adjivas/electronic-levelup/Dossier de Fabrication/Spec Files/Valeurs_Polar.ods

Layer |  | Material | Dielectric |  | Copper | Trace |  |  |  |  | Current | Impedance | Edge Coupled | Broadside Coupled
Number | Name | Type | Constant | Thickness (mm) | Thickness (mm) | Clearance Diff 100 (mm) | Width Diff 100 (mm) | Clearance Diff 90 (mm) | Width Diff 90 (mm) | Width Sing 50 (mm) | (Amps) | Characteristic (Zo) | Differential (Zdiff) | Differential (Zdbs) | Description
 | Top Solder | Dielectric Solder Resist | 3,7 | 0,254 |  |  |  |  |  |  |  |  |  |  | Solder Mask
1 | Top Layer (Sig 1) | Conductive |  |  | 0.035 | 0,1 | 0,13 | 0,2 | 0,29 | 0,342 |  | 50,01 | 100 / 89,98 |  | Signal
 |  | Dielectric FR-4 | 4,3 | 0,2 |  |  |  |  |  |  |  |  |  |  | Prepreg
2 | Ground Plane 1 | Conductive |  |  | 0.035 |  |  |  |  |  |  |  |  |  | Plane
 |  | Dielectric FR-4 | 4,3 | 0,2 |  |  |  |  |  |  |  |  |  |  | Core
3 | Signal Layer 2 | Conductive |  |  | 0.035 | 0,16 | 0,121 | 0,195 | 0,2 | 0,291 |  | 50 | 100,03 / 90,01 |  | Signal
 |  | Dielectric FR-4 | 4,3 | 0,2 |  |  |  |  |  |  |  |  |  |  | Prepreg
4 | Power Plane 1 | Conductive |  |  | 0.035 |  |  |  |  |  |  |  |  |  | Plane
 |  | Dielectric FR-4 | 4,3 | 0,2 |  |  |  |  |  |  |  |  |  |  | Core
5 | Power Plane 2 | Conductive |  |  | 0.035 |  |  |  |  |  |  |  |  |  | Plane
 |  | Dielectric FR-4 | 4,3 | 0,2 |  |  |  |  |  |  |  |  |  |  | Prepreg
6 | Signal Layer 3 | Conductive |  |  | 0.035 | 0,16 | 0,121 | 0,195 | 0,2 | 0,291 |  | 50 | 100,03 / 90,01 |  | Signal
 |  | Dielectric FR-4 | 4,3 | 0,2 |  |  |  |  |  |  |  |  |  |  | Core
7 | Ground Plane 2 | Conductive |  |  | 0.035 |  |  |  |  |  |  |  |  |  | Plane
 |  | Dielectric FR-4 | 4,3 | 0,2 |  |  |  |  |  |  |  |  |  |  | Prepreg
8 | Bottom Layer (Sig 4) | Conductive |  |  | 0.035 | 0,1 | 0,13 | 0,2 | 0,29 | 0,342 |  | 50,01 | 100 / 89,98 |  | Signal
 | Bottom Solder | Dielectric Solder Resist | 3,7 | 0,254 |  |  |  |  |  |  |  |  |  |  | Solder Mask
