adjivas/electronic-levelup/calcul polar/pair extern ddr 100ohm.PNG

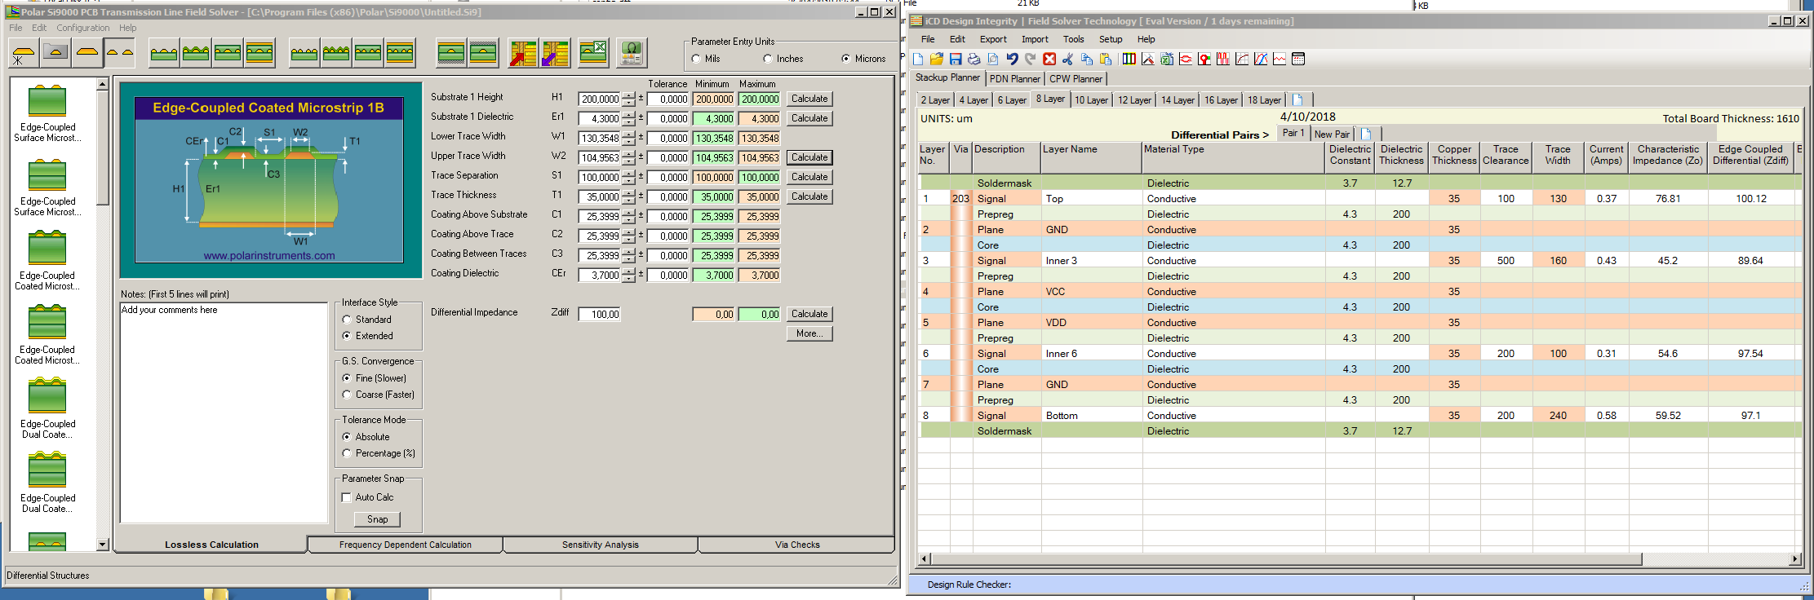
calcul polar/pair extern ddr 100ohm.PNG
