adjivas/electronic-levelup/calcul polar/pair extern usb 90ohm.PNG

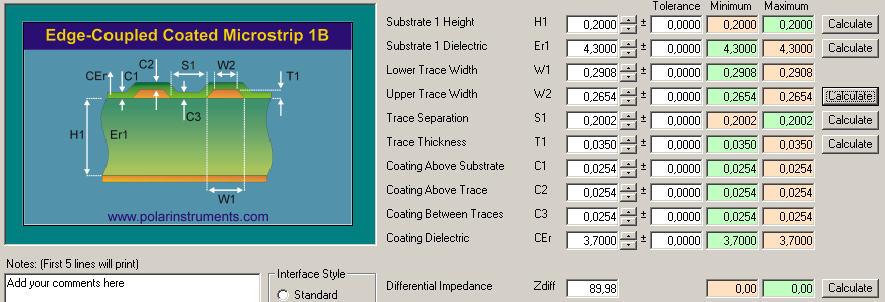
calcul polar/pair extern usb 90ohm.PNG
