adjivas/electronic-levelup/calcul polar/pair intern ddr 100ohm.PNG

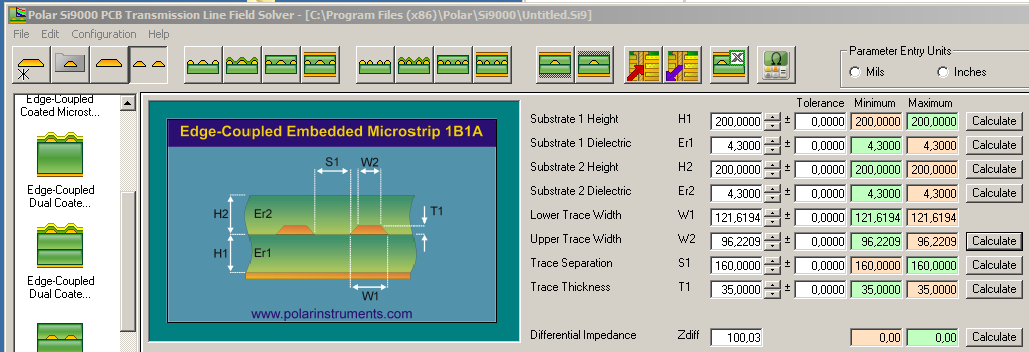
calcul polar/pair intern ddr 100ohm.PNG
