adjivas/electronic-levelup/calcul polar/pair intern usb 90ohm.PNG

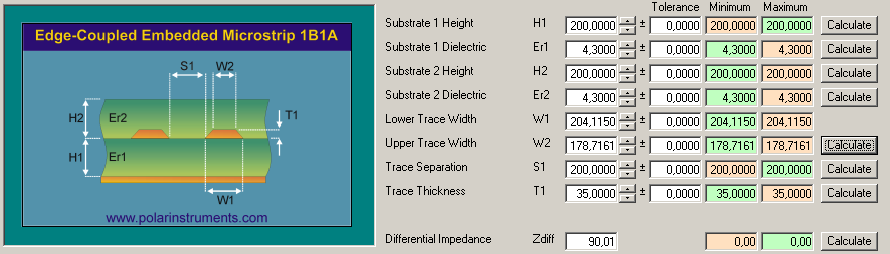
calcul polar/pair intern usb 90ohm.PNG
