adjivas/electronic-levelup/calcul polar/single extern 55ohm.PNG

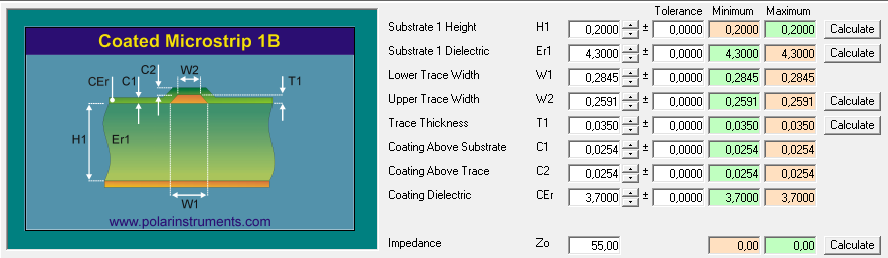
calcul polar/single extern 55ohm.PNG
