adjivas/electronic-levelup/calcul polar/single intern 55ohm.PNG

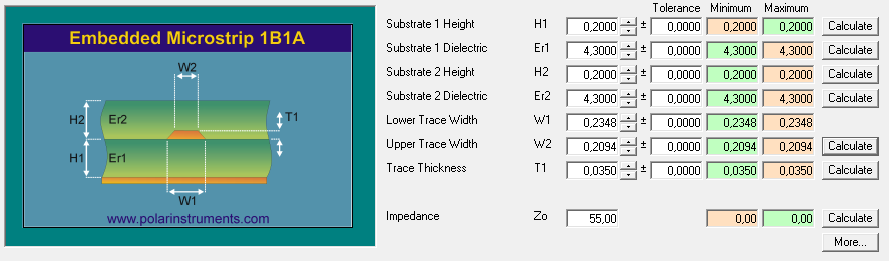
calcul polar/single intern 55ohm.PNG
