adjivas/electronic-levelup/Dossier de Fabrication/Bill of Materials-Michel.xlsx

Designator | Value | Description | RefFabricant | Fabricant | RefFournisseur | Fournisseur | Quantity | Footprint | Case | DataSheet
C181, C195 | 220pF | Capacitor | CC0603JRNPO9BN221 | YAGEO | 430948 | Farnell | 2 | CAPC1608X08 | 0603 [1608 Metric] | http://www.farnell.com/datasheets/2213336.pdf
U11 |  | Optocoupler | 6N139-300E | BOADCOM | 1085023 | Farnell | 1 | SOIC127P970X356-8N |  | http://www.farnell.com/datasheets/1266261.pdf
U1, U5 |  | Buffers & Transmetteurs | SN74LVC1G07DCKR | TEXAS INSTRUMENTS | 1287544 | Farnell | 2 | DCK5 |  | http://www.ti.com/lit/ds/symlink/sn74lvc1g07.pdf
P6 |  | Connecteur USB-Type-B | 1734346-1 | TE CONNECTIVITY | 1321918 | Farnell | 1 | CONN4-292304 |  | http://www.farnell.com/datasheets/2365064.pdf
L5, L6, L7 | 2.2uH | Inductor | LQM18NN2R2K00D | MURATA | 1343118 | Farnell | 3 | INDM1608X08N | 0603 [1608 Metric] | http://www.farnell.com/datasheets/66032.pdf
U8 |  | Stereo In/Out Audio Codec | PCM3060PW | TEXAS INSTRUMENTS | 1390706 | Farnell | 1 | TSSOP28_PCM3060 |  | http://www.ti.com/lit/ds/symlink/pcm3060.pdf
U15 |  | Dual Audio OpAmp | NE5532AD8G | ON SEMICONDUCTOR | 1426379 | Farnell | 1 | D8-M |  | http://www.farnell.com/datasheets/1777901.pdf
S2, S3 |  | Commutateur tactile | KMR211G LFS | C & K COMPONENTS | 1437635 | Farnell | 2 | C&K_KMR211G |  | http://www.farnell.com/datasheets/2044619.pdf
L8 | 18uH | Inductor | MLF2012C180K | TDK | 1669551 | Farnell | 1 | INDM2612X12N | 0805 [2012 Metric] | http://www.farnell.com/datasheets/321059.pdf
L1, L2, L3 | FB0805/600R/2A, [NoValue], [NoParam] | FB0805/600R/2A | MPZ2012S601A | TDK | 1669753 | Farnell | 3 | IND2012X8 | 0805 [2012 Metric] | http://www.farnell.com/datasheets/84904.pdf
R56, R63, R66, R75 | 7.5k | Resistor | ERA3AEB752V | PANASONIC ELECTRONIC COMPONENTS | 1670187 | Farnell | 4 | RESC1608X05 | 0603 [1608 Metric] | http://www.farnell.com/datasheets/2052875.pdf
R64, R70 | 20k | Resistor | ERA3AEB203V | PANASONIC ELECTRONIC COMPONENTS | 1670194 | Farnell | 2 | RESC1608X05 | 0603 [1608 Metric] | http://www.farnell.com/datasheets/2052875.pdf
C120, C125 | 330pF | Capacitor | MC0603B331K500CT | MULTICOMP | 1759075 | Farnell | 2 | CAPC1608X08 | 0603 [1608 Metric] | http://www.farnell.com/datasheets/1901289.pdf
C119, C123, C126, C130 | 470pF | Capacitor | MC0603B471K500CT | MULTICOMP | 1759079 | Farnell | 4 | CAPC1608X08 | 0603 [1608 Metric] | http://www.farnell.com/datasheets/1901289.pdf
P10 |  | DIN 5pin | PSG03463 | PRO SIGNAL | 1791756 | Farnell | 1 | PRO SIGNAL_PSG03463 |  | http://www.farnell.com/datasheets/1697491.pdf
P8 |  | Connecteur LCD et Touch screen | 4-1734592-0 | TE CONNECTIVITY | 1816399 | Farnell | 1 | TE_4-1734592-0 |  | http://www.farnell.com/cad/1794473.pdf
C11, C13, C84, C85, C86, C107 | 1uF | Capacitor | GRM188F51A105ZA01D | MURATA | 1828847 | Farnell | 6 | CAPC1608X08 | 0603 [1608 Metric] | http://www.farnell.com/datasheets/2048756.pdf
U14, U16 |  | Dual DigiPot non volatile I2C | MCP4661-503E/ST | MICROCHIP | 1840724 | Farnell | 2 | TSSOP14_MC-M |  | http://www.farnell.com/datasheets/2243913.pdf
J1 |  | Jack Socket Thru-Hole Vertical 2-Conductor Open Circuit | FC681465P | CLIFF ELECTRONIC COMPONENTS | 1854512 | Farnell | 1 | CLIFF ELECTRONIC COMPONENTS_FC681465P |  | http://www.farnell.com/datasheets/1855458.pdf
C176, C177, C179, C182, C184, C190, C191, C193, C196, C198, C200, C201, C204, C205 | 100pF | Capacitor | MCMT18N101F250CT | MULTICOMP | 1856128 | Farnell | 14 | CAPC1608X08 | 0603 [1608 Metric] | http://www.farnell.com/datasheets/1825496.pdf
D11 |  | LED Blanc | LNJ037X8ARA | PANASONIC ELECTRONIC COMPONENTS | 1908051 | Farnell | 1 | LED_LNJ |  | http://www.farnell.com/datasheets/2085723.pdf
P9 |  | Embase mémoire | 693072010801 | WURTH ELEKTRONIK | 2081364 | Farnell | 1 | WURTH ELEKTRONIK_693072010801 |  | http://www.farnell.com/datasheets/1912449.pdf
U9, U13, U17 |  | Quad Audio OpAmp | OPA1654 | TEXAS INSTRUMENTS | 2099889 | Farnell | 3 | D14-M |  | http://www.ti.com/lit/ds/symlink/opa1654.pdf
C6 | 0.47uF | Capacitor | C1608X5R1H474K080AB | TDK | 2211183 | Farnell | 1 | CAPC1608X08 | 0603 [1608 Metric] | http://www.farnell.com/datasheets/2291921.pdf
C1, C4, C122, C127, C131, C132, C134, C136, C139, C141, C142, C143, C144, C160, C162, C163, C164, C165, C166, C167, C168, C170, C174, C175, C178, C183, C192, C197 | 10uF | Capacitor | C1608X5R1A106M080AC | TDK | 2309028 | Farnell | 28 | CAPC1608X08 | 0603 [1608 Metric] | http://www.farnell.com/datasheets/2291921.pdf
R11 | 240 1% | Resistor | CPF0603B240RE1 | TE CONNECTIVITY | 2331060 | Farnell | 1 | RESC1608X05 | 0603 [1608 Metric]
R118, R123, R130, R135 | 150 | Capacitor | CRGH0603J150R | TE CONNECTIVITY | 2331715 | Farnell | 4 | RESC1608X05 | 0603 [1608 Metric]
R78, R97, R112 | 220 | Capacitor | CRGH0603J220R | TE CONNECTIVITY | 2331717 | Farnell | 3 | RESC1608X05 | 0603 [1608 Metric]
R58, R61, R69, R74 | 820 | Resistor | CRGH0603J820R | TE CONNECTIVITY | 2331726 | Farnell | 4 | RESC1608X05 | 0603 [1608 Metric] | http://www.farnell.com/datasheets/2563624.pdf
R124, R136 | 4.7k | Resistor | CRGH0603J4K7 | TE CONNECTIVITY | 2331736 | Farnell | 2 | RESC1608X05 | 0603 [1608 Metric] | http://www.farnell.com/datasheets/2007183.pdf
R3, R7, R10, R12, R13, R15, R19, R52, R53, R54, R55, R57, R60, R62, R67, R68, R73, R83, R84, R89, R90, R91, R92, R94, R96, R98, R99, R101, R105, R106, R107, R109, R111, R113, R114, R116, R121, R122, R133, R134 | 10k | Resistor | CRGH0603J10K | TE CONNECTIVITY | 2331740 | Farnell | 40 | RESC1608X05 | 0603 [1608 Metric] | CRGH0603J10K
R79 | 470 | Resistor | CRGH0603F470R | TE CONNECTIVITY | 2331997 | Farnell | 1 | RESC1608X05 | 0603 [1608 Metric]
R65, R71, R80, R117, R129 | 1k | Resistor | CRGH0603F1K0 | TE CONNECTIVITY | 2332003 | Farnell | 5 | RESC1608X05 | 0603 [1608 Metric] | http://www.farnell.com/datasheets/2007183.pdf
R4, R5 | 2.2K 1% | Resistor | CRGH0603F2K2 | TE CONNECTIVITY | 2332007 | Farnell | 2 | RESC1608X05 | 0603 [1608 Metric]
L4 | 470nH | Inductor High Frequency | 744786247A | WURTH ELEKTRONIK | 2424740 | Farnell | 1 | INDM1608X08N | 0603 [1608 Metric] | http://www.farnell.com/datasheets/1818786.pdf
C2, C5, C7, C12, C116, C158, C161, C180, C194, C199, C202, C203, C206 | 22uF | Capacitor | GRM188R61A226ME15D | MURATA | 2426957 | Farnell | 13 | CAPC1608X08 | 0603 [1608 Metric] | http://www.farnell.com/datasheets/2047978.pdf
S1 |  | SPDT Subminiature Toggle Switch, Right Angle Mounting, Vertical Actuation | TS01ABE | C & K COMPONENTS | 2435185 | Farnell | 1 | C&K_TS01ABE |  | http://www.farnell.com/datasheets/1839865.pdf
D1, D2, D3, D4, D5, D6, D7, D8, D9 |  | Diode signaux faibles | 1N4148WS | ON SEMICONDUCTOR | 2453269 | Farnell | 9 | SOD323-M |  | http://www.farnell.com/datasheets/2288055.pdf
Q1 | 24MHz | Quartz 24MHz | ABMM2-24.000MHZ-E2-T | ABRACON | 2467855 | Farnell | 1 | SON440P360X120-4N |  | http://www.farnell.com/datasheets/1750519.pdf
R16 | 1.2k | Resistor | CPF-A-0603B1K2E1 | TE CONNECTIVITY | 2483896 | Farnell | 1 | RESC1608X05 | 0603 [1608 Metric] | http://www.farnell.com/datasheets/1935020.pdf
U12 |  | Gestion d'alimentation PMIC | TPS65217CRSLT | TEXAS INSTRUMENTS | 2492485 | Farnell | 1 | CRSLT |  | http://www.ti.com/lit/ds/symlink/tps65217.pdf
U7 |  | Protection_ESD | TPD4E1U06DBVR | TEXAS INSTRUMENTS | 2496529 | Farnell | 1 | DBV6-M |  | http://www.ti.com/lit/ds/symlink/tpd4e1u06.pdf
P2, P4 |  | Header, 3-Pin, Dual row | TSM-103-01-T-DV | SAMTEC | 2505049 | Farnell | 2 | CONN_1241050-3_T |  | http://www.farnell.com/datasheets/318453.pdf
VR4 |  | Voltage Regulator | MIC5270-5.0YM5-TR | MICROCHIP | 2510308 | Farnell | 1 | SOT95P280X130-5N |  | http://www.farnell.com/datasheets/29611.pdf
C39, C40, C41, C115, C124, C129, C133, C135, C137, C138, C140, C159, C185, C186, C187, C188, C189, C207, C208, C209 | 100nF | Capacitor | C0603T104K5RALTU | KEMET | 2522432 | Farnell | 20 | CAPC1608X08 | 0603 [1608 Metric]
C47, C106, C108 | 10nF | Capacitor | C1005X8R1E103K050BA | TDK | 2525066 | Farnell | 3 | CAPC1005X05 (0402) | 0402 [1005 Metric] | http://www.farnell.com/datasheets/1936795.pdf
C51, C83, C95, C105, C114 | 22uF | Capacitor | C2012X5R0J226K125AB | TDK | 2525125 | Farnell | 5 | 0805 (2012 metric) | 0805 [2012 Metric] | http://www.farnell.com/datasheets/2291921.pdf
R59, R72 | 100 | Resistor | CRGS0603J100R | TE CONNECTIVITY | 2531678 | Farnell | 2 | RESC1608X05 | 0603 [1608 Metric]
C19, C22 | 12pF | Capacitor | GRM1555C1H120FA01D | MURATA | 2611890 | Farnell | 2 | CAPC1005X05 (0402) | 0402 [1005 Metric] | http://www.farnell.com/datasheets/2079134.pdf
C15, C18 | 18pF | Capacitor | GRM1555C1H180FA01D | MURATA | 2611892 | Farnell | 2 | CAPC1005X05 (0402) | 0402 [1005 Metric] | http://www.farnell.com/datasheets/2048029.pdf
R14 | 49.9R 1% | Resistor | RN73C1J49R9BTDF | TE CONNECTIVITY | 2613729 | Farnell | 1 | RESC1608X05 | 0603 [1608 Metric]
R1, R2, R6, R17, R81, R82, R87, R88, R102, R103, R104, R126, R127, R128 | 0 | Resistor | CRCW06030000Z0EB | VISHAY | 2616741 | Farnell | 14 | RESC1608X05 | 0603 [1608 Metric]
C14, C16, C17, C20, C21, C23, C24, C25, C26, C27, C28, C29, C30, C31, C32, C33, C34, C35, C36, C37, C38, C42, C48, C49, C50, C52, C53, C54, C55, C56, C57, C58, C59, C60, C61, C62, C63, C64, C65, C66, C67, C68, C69, C70, C71, C72, C73, C74, C75, C76, C77, C78, C79, C80, C81, C82, C87, C88, C89, C90, C91, C92, C93, C94, C96, C97, C98, C99, C100, C101, C102, C103, C104, C109, C110, C111, C112, C113 | 100nF | Capacitor | MC0402N101J160CT | MULTICOMP | 2627387 | Farnell | 78 | CAPC1005X05 (0402) | 0402 [1005 Metric] | http://www.farnell.com/datasheets/2117933.pdf
C43, C44, C45, C46 | 1nF | Capacitor | GRT1885C1H102JA02D | MURATA | 2672134 | Farnell | 4 | CAPC1608X08 | 0603 [1608 Metric] | http://www.farnell.com/datasheets/2165937.pdf
C169, C171 | 2.2uF | Capacitor | GRT188R60J225KE13D | MURATA | 2672153 | Farnell | 2 | CAPC1608X08 | 0603 [1608 Metric] | http://www.farnell.com/datasheets/2165952.pdf
C117, C118, C172, C173 | 4.7uF | Capacitor | GRT188R61E475KE13D | MURATA | 2672159 | Farnell | 4 | CAPC1608X08 | 0603 [1608 Metric] | http://www.farnell.com/datasheets/2165958.pdf
R22, R29, R34, R36, R37, R39, R40, R41, R42, R43, R44, R46, R47, R48, R49, R51, R85, R86, R93, R95, R100, R108, R110, R115, R119, R120, R125, R131, R132, R137 | 100k | Resistor | RN73C1J100KBTDF | TE CONNECTIVITY | 2687850 | Farnell | 30 | RESC1608X05 | 0603 [1608 Metric] | http://www.farnell.com/datasheets/2189072.pdf
Q4 |  | PNP Bipolar Transistor | SMMUN2114LT1G | ON SEMICONDUCTOR | 2724481 | Farnell | 1 | SOT95P234X111-3N |  | http://www.farnell.com/datasheets/2237089.pdf
J3, J4 |  | Dual Jack stereo bypassed | ACJS-MHDC | AMPHENOL | 2771861 | Farnell | 2 | Amphenol_ACJS-MHDC |  | http://www.farnell.com/datasheets/866888.pdf
C121, C128 | 1500pF | Capacitor | C0603C152K1RACAUTO | KEMET | 2810266 | Farnell | 2 | CAPC1608X08 | 0603 [1608 Metric] | http://www.farnell.com/datasheets/2048264.pdf
P1 |  | Header, 8-Pin, Dual row | TSM-108-02-T-DV | SAMTEC | 2856657 | Farnell | 1 | CONN_1241050-8_T |  | http://www.farnell.com/datasheets/318453.pdf
VR3 |  | Voltage Regulator | TS2940CW-3.3 RP | TAIWAN SEMICONDUCTOR | 7261403 | Farnell | 1 | SOT230P715X180-4N |  | http://www.farnell.com/datasheets/2044143.pdf
Q3 |  | NPN Bipolar Transistor | SMMUN2214LT1G | ON SEMICONDUCTOR | 9556672 | Farnell | 1 | SOT95P234X111-3N |  | http://www.farnell.com/datasheets/1813846.pdf
P3, P5 |  | Header, 2-Pin, Dual row | 1241050-2 | AMP - TE CONNECTIVITY | 9689559 | Farnell | 2 | CONN_1241050-2_T |  | http://www.farnell.com/datasheets/318453.pdf
C3, C8, C9, C10 | 470uF | Polarized Capacitor (Radial) | EEEFK1E471P | PANASONIC ELECTRONIC COMPONENTS | 9695800 | Farnell | 4 | CAPC100100X102 | [10mm] | http://www.farnell.com/datasheets/2002520.pdf
Q2 | 32,768KHz | Crystal Oscillator | LFXTAL003000 | IQD FREQUENCY PRODUCTS | 9713220 | Farnell | 1 | SON550P380X250-4N |  | http://www.farnell.com/datasheets/2175893.pdf
VR1, VR2 |  | Voltage Regulator | LM1117MP-5.0 | TEXAS INSTRUMENTS | 9778209 | Farnell | 2 | MP04A |  | http://www.farnell.com/datasheets/2019100.pdf
D10 |  | Zener Diode | LM4041DIM3-1.2 | TEXAS INSTRUMENTS | 9778349 | Farnell | 1 | MF03A-M |  | http://www.ti.com/lit/ds/symlink/lm4041-n.pdf
U2 |  | Microprocesseur ARM | AM3352ZCZD72 | TEXAS INSTRUMENTS | AM3352ZCZD72 | Olimex | 1 | ZCZ324 |  | http://www.ti.com/lit/ds/symlink/am3352.pdf
U3 |  | Mémoire DDR3/SRAM | DS_K4B4G1646D | Samsung | K4B4G1646D-BCK0 | Olimex | 1 | BGA96C80P16X6_133X75X11 |  | http://www.samsung.com/global/business/semiconductor/file/product/DS_K4B4G1646D-BC_I_P_Rev102.pdf
P7 |  | Connecteur LCD et Touch screen (limande) | MALE-PAV16X-2x20 | Olimex | MALE-PAV16X-2x20 | Olimex | 1 | MALE-PAV16X-2x05 |  | https://www.olimex.com/Products/Components/Connectors/MALE-PAV16X-2x05/resources/MALE-PA16X-2Xxx.jpg
U4 |  | Mémoire Flash/NAND | MT29F64G08CBABAWP | Hynix | MT29F64G08CBABAWP | Olimex | 1 | TSSOP50P2000X120-48N |  | https://www.olimex.com/Products/Components/IC/H27UBG8T2BTR/resources/H27UBG8T2BTR.pdf
