adjivas/electronic-levelup/Remarques footprints.xls

Designator | Value | Description | RefFabricant | Fabricant | RefFournisseur | Fournisseur | Quantity | Footprint | Case | DataSheet | Remarques footprints
U12 |  | LED_Controller | MAX7219CWG+ | MAXIM | 2519520 | Farnell | 1 | 21-0042B_24-M |  | http://www.farnell.com/datasheets/1825883.pdf
U57 |  | Quad DAC Package | MAX5842LEUB+ | MAXIM INTEGRATED PRODUCTS | 2518696 | Farnell | 1 | 21-0061L-M |  | http://www.farnell.com/datasheets/74794.pdf
U11 |  | Micro-contrôleur ATMEGA | ATMEGA328-AU | MicroChip | 1972086 | Farnell | 1 | 32A-M |  | http://www.farnell.com/datasheets/2047852.pdf
P8, P9 | 10k | Potentiometer | RK09K1130C79 | ALPS | 1191741 | Farnell | 2 | ALPS_RK09K1130C79 |  | http://www.farnell.com/datasheets/2160634.pdf
J5, J6, J7 |  | Dual Jack stereo bypassed | ACJS-MHDC | AMPHENOL | 2771861 | Farnell | 3 | Amphenol_ACJS-MHDC |  | http://www.farnell.com/datasheets/866888.pdf
U4 |  | Mémoire DDR3/SRAM | DS_K4B4G1646D | Samsung | K4B4G1646D-BCK0 | Olimex | 1 | BGA96C80P16X6_133X75X11
U13, U14, U15, U16 |  | Encodeurs cliquables | PEC11R-4120F-S0018 | BOURNS | 2663521 | Farnell | 4 | BOURNS_PEC11R-4120F-S0018 |  | http://www.farnell.com/datasheets/2360546.pdf
S2, S3, S4 |  | Commutateur tactile | KMR211G LFS | C & K COMPONENTS | 1437635 | Farnell | 3 | C&K_KMR211G |  | http://www.farnell.com/datasheets/2044619.pdf
S1 |  | SPDT Subminiature Toggle Switch, Right Angle Mounting, Vertical Actuation | TS01ABE | C & K COMPONENTS | 2435185 | Farnell | 1 | C&K_TS01ABE |  | http://www.farnell.com/datasheets/1839865.pdf
C3, C8, C9, C10 | 470uF, 470uF, 470uF, 470pf | Polarized Capacitor (Radial) | EEEFK1E471P | PANASONIC ELECTRONIC COMPONENTS | 9695800 | Farnell | 4 | CAPC100100X102 | [10mm] | http://www.farnell.com/datasheets/2002520.pdf
C104, C105, C106, C127 | 1uF | Capacitor | GRT155C81A105KE01D | MURATA | 2672105 | Farnell | 4 | CAPC1005X05 | 0402 [1005 Metric] | http://www.farnell.com/datasheets/2165911.pdf
C32, C34, C35, C38, C39, C41, C42, C43, C44, C45, C46, C47, C48, C49, C50, C51, C52, C53, C54, C55, C56, C62, C68, C69, C70, C72, C73, C74, C75, C76, C77, C78, C79, C80, C81, C82, C83, C84, C85, C86, C87, C88, C89, C90, C91, C92, C93, C94, C95, C96, C97, C98, C99, C100, C101, C102, C107, C108, C109, C110, C111, C112, C113, C115, C116, C117, C118, C119, C120, C121, C122, C123, C124, C129, C130, C131, C132, C133 | 100pF | Capacitor | GRM155R61A104JA01D | MURATA | 2470461 | Farnell | 78 | CAPC1005X05 | 0402 [1005 Metric] | http://www.farnell.com/datasheets/2048172.pdf
C33, C36 | 18pF | Capacitor | GRM1555C1H180FA01D | MURATA | 2611892 | Farnell | 2 | CAPC1005X05 | 0402 [1005 Metric] | http://www.farnell.com/datasheets/2048029.pdf
C37, C40 | 12pF | Capacitor | GRM1555C1H120GA01D | MURATA | 2611891 | Farnell | 2 | CAPC1005X05 | 0402 [1005 Metric] | http://www.farnell.com/datasheets/2079135.pdf
C57, C58, C59, C60 | 0.1uF | Capacitor (Semiconductor SIM Model) | GRM1555C1H240JA01D | MURATA | 2218850 | Farnell | 4 | CAPC1005X05 | 0402 [1005 Metric] | http://www.farnell.com/datasheets/2048172.pdf
C63, C64, C65, C66 | 1nF | Capacitor | GRM1555C1H102GA01D | MURATA | 2470453 | Farnell | 4 | CAPC1005X05 | 0402 [1005 Metric] | http://www.farnell.com/datasheets/2048131.pdf
C67, C126, C128 | 10nf, 100pF, 100pF | Capacitor | GRM155R71E103JA01D | MURATA | 2470469 | Farnell | 3 | CAPC1005X05 | 0402 [1005 Metric] | http://www.farnell.com/datasheets/2048220.pdf
C71, C103, C114, C125, C134 | 22uF | Capacitor | GRM155R61A224KE19D | MURATA | 8819718 | Farnell | 5 | CAPC1005X05 | 0402 [1005 Metric] | http://www.farnell.com/datasheets/2048289.pdf
C1, C4, C139, C157, C158, C159, C160, C166, C169, C170, C171, C172, C173, C176_Audio Input L, C176_Audio Input R, C176_Audio Repeat L, C176_Audio Repeat R, C191, C196, C205, C210, C261_Mode Select 1A, C261_Mode Select 1B, C261_Mode Select 2A, C261_Mode Select 2B, C288, C289, C290, C291 | 10uF | Capacitor (Semiconductor SIM Model) | GRM188R60J106ME47J | MURATA | 2611921 | Farnell | 29 | CAPC1608X08 | 0603 [1608 Metric] | http://www.farnell.com/datasheets/2079165.pdf
C11, C31 | 1uF | Capacitor (Semiconductor SIM Model), Capacitor | GRM188R60J105KA01D | MURATA | 9527699 | Farnell | 2 | CAPC1608X08 | 0603 [1608 Metric] | http://www.farnell.com/datasheets/2048127.pdf
C13, C14, C15, C16, C17, C18, C19, C20, C21, C22, C23, C24, C25, C26, C27, C28, C29, C30, C61, C136, C137, C140, C141, C142, C143, C144, C145, C146, C147, C148, C149, C150, C151, C152, C153, C154, C155 | 22uF, 100nF, 10uF, 22uF, 10uF, 10uF, 10uF, 10uF, 10uF, 10uF, 10uF, 2.2uF, 10uF, 2.2uF, 4.7uF, 4.7uF, 10uF, 10uF, 10uF, 22uF, 4.7uF, 10uF, 0.1uF, 0.1uF, 0.1uF, 100nF, 100nF, 100nF, 100nF, 100nF, 100nF, 100nF, 100nF, 100nF, 100nF, 100nF, 100nF | Capacitor | GRM188R60J226MEA0D, GRM188F51E104ZA01D, GRM188R60J106ME47J, GRM188R60J226MEA0D, GRM188R60J106ME47J, GRM188R60J106ME47J, GRM188R60J106ME47J, GRM188R60J106ME47J, GRM188R60J106ME47J, GRM188R60J106ME47J, GRM188R60J106ME47J, GRT188R60J225KE13D, GRM188R60J106ME47J, GRT188R60J225KE13D, GRM188R60J475KE19D, GRM188R60J475KE19D, GRM188R60J106ME47J, GRM188R60J106ME47J, GRM188R60J106ME47J, ZRB18AR60J226ME01L, GRM188R60J475KE19D, GRM188R60J106ME47J, GRM188F51E104ZA01D, GRM188F51E104ZA01D, GRM188F51E104ZA01D, GRM188F51E104ZA01D, GRM188F51E104ZA01D, GRM188F51E104ZA01D, GRM188F51E104ZA01D, GRM188F51E104ZA01D, GRM188F51E104ZA01D, GRM188F51E104ZA01D, GRM188F51E104ZA01D, GRM188F51E104ZA01D, GRM188F51E104ZA01D, GRM188F51E104ZA01D, GRM188F51E104ZA01D | MURATA | 2666490, 1828902, 2611921, 2666490, 2611921, 2611921, 2611921, 2611921, 2611921, 2611921, 2611921, 2672153, 2611921, 2672153, 2666491, 2666491, 2611921, 2611921, 2611921, 2666613, 2666491, 2611921, 2821272, 2821272, 2821272, 1828902, 1828902, 1828902, 1828902, 1828902, 1828902, 1828902, 1828902, 1828902, 1828902, 1828902, 1828902 | Farnell | 37 | CAPC1608X08 | 0603 [1608 Metric]
C135, C138, C178_Audio Input L, C178_Audio Input R, C178_Audio Repeat L, C178_Audio Repeat R, C179_Audio Input L, C179_Audio Input R, C179_Audio Repeat L, C179_Audio Repeat R, C180_Audio Input L, C180_Audio Input R, C180_Audio Repeat L, C180_Audio Repeat R, C187_Audio Output1, C187_Audio Output2, C187_Audio Output3, C188_Audio Output1, C188_Audio Output2, C188_Audio Output3, C198, C199, C200, C201, C202, C214_MS - LR Converter1, C214_MS - LR Converter2, C215_MS - LR Converter1, C215_MS - LR Converter2, C216_MS - LR Converter1, C216_MS - LR Converter2, C217_MS - LR Converter1, C217_MS - LR Converter2, C218_MS - LR Converter1, C218_MS - LR Converter2, C223, C224, C225, C226, C233, C234, C235, C242, C243, C250, C251, C252, C259, C260, C262_Mode Select 1A, C262_Mode Select 1B, C262_Mode Select 2A, C262_Mode Select 2B, C263, C264, C265, C266, C267, C268, C269, C270, C271, C272, C273, C282, C283, C284, C285, C286, C287, C292, C293, C294, C295 | 0.1uF | Capacitor (Semiconductor SIM Model) | GRM188F51E104ZA01D | MURATA | 2821272 | Farnell | 74 | CAPC1608X08 | 0603 [1608 Metric] | http://www.farnell.com/datasheets/2048672.pdf
C156, C161, C162, C163, C164, C165, C167, C168, C175_Audio Input L, C175_Audio Input R, C175_Audio Repeat L, C175_Audio Repeat R, C177_Audio Input L, C177_Audio Input R, C177_Audio Repeat L, C177_Audio Repeat R, C181_Audio Output1, C181_Audio Output2, C181_Audio Output3, C182_Audio Output1, C182_Audio Output2, C182_Audio Output3, C183_Audio Output1, C183_Audio Output2, C183_Audio Output3, C184_Audio Output1, C184_Audio Output2, C184_Audio Output3, C185_Audio Output1, C185_Audio Output2, C185_Audio Output3, C186_Audio Output1, C186_Audio Output2, C186_Audio Output3 | 1uF, 1uF, 1uF, 1uF, 1uF, 1uF, 1uF, 1uF, 0.01uF, 0.01uF, 0.01uF, 0.01uF, 2200pF, 2200pF, 2200pF, 2200pF, 330pF, 330pF, 330pF, 1500pF, 1500pF, 1500pF, 330pF, 330pF, 330pF, 330pF, 330pF, 330pF, 1500pF, 1500pF, 1500pF, 330pF, 330pF, 330pF | Capacitor (Semiconductor SIM Model) | GRM188R60J105KA01D, GRM188R60J105KA01D, GRM188R60J105KA01D, GRM188R60J105KA01D, GRM188R60J105KA01D, GRM188R60J105KA01D, GRM188R60J105KA01D, GRM188R60J105KA01D, GRM188F51E104ZA01D, GRM188F51E104ZA01D, GRM188F51E104ZA01D, GRM188F51E104ZA01D, GRT188R71H222KE01D, GRT188R71H222KE01D, GRT188R71H222KE01D, GRT188R71H222KE01D, GRT1885C1H331JA02D, GRT1885C1H331JA02D, GRT1885C1H331JA02D, GRT1885C1H152JA02D, GRT1885C1H152JA02D, GRT1885C1H152JA02D, GRT1885C1H331JA02D, GRT1885C1H331JA02D, GRT1885C1H331JA02D, GRT1885C1H331JA02D, GRT1885C1H331JA02D, GRT1885C1H331JA02D, GRT1885C1H152JA02D, GRT1885C1H152JA02D, GRT1885C1H152JA02D, GRT1885C1H331JA02D, GRT1885C1H331JA02D, GRT1885C1H331JA02D | MURATA | 9527699, 9527699, 9527699, 9527699, 9527699, 9527699, 9527699, 9527699, 1828902, 1828902, 1828902, 1828902, 2672172, 2672172, 2672172, 2672172, 2672142, 2672142, 2672142, 2672137, 2672137, 2672137, 2672142, 2672142, 2672142, 2672142, 2672142, 2672142, 2672137, 2672137, 2672137, 2672142, 2672142, 2672142 | Farnell | 34 | CAPC1608X08 | 0603 [1608 Metric]
C189, C190, C192, C195, C197, C203, C204, C206, C209, C211, C220, C222, C275, C276, C279, C280 | 100pF | Capacitor (Semiconductor SIM Model) | GRT1885C1H101JA02D | MURATA | 2672133 | Farnell | 16 | CAPC1608X08 | 0603 [1608 Metric] | http://www.farnell.com/datasheets/2165936.pdf
C194, C208 | 220pF | Capacitor (Semiconductor SIM Model) | GRM1885C1H221JA01D | MURATA | 8819882 | Farnell | 2 | CAPC1608X08 | 0603 [1608 Metric] | http://www.farnell.com/datasheets/2048203.pdf
C2, C5, C7, C12, C174_Audio Input L, C174_Audio Input R, C174_Audio Repeat L, C174_Audio Repeat R, C193, C207, C212_MS - LR Converter1, C212_MS - LR Converter2, C213_MS - LR Converter1, C213_MS - LR Converter2, C219, C221, C274, C277, C278, C281 | 22uF | Capacitor (Semiconductor SIM Model) | GRM188R60J226MEA0D | MURATA | 2666490 | Farnell | 20 | CAPC1608X08 | 0603 [1608 Metric]
C227, C231, C232, C236, C240, C241, C244, C248, C249, C253, C257, C258 | 0.22uF | Capacitor (Semiconductor SIM Model) | GRM188R71A224KA01D | MURATA | 2695909 | Farnell | 12 | CAPC1608X08 | 0603 [1608 Metric] | http://www.farnell.com/datasheets/2048635.pdf
C228, C237, C245, C254 | 68pF | Capacitor (Semiconductor SIM Model) | GRT1885C1H680JA02D | MURATA | 2672146 | Farnell | 4 | CAPC1608X08 | 0603 [1608 Metric] | http://www.farnell.com/datasheets/2165946.pdf
C229, C230, C238, C239, C246, C247, C255, C256 | 1000pF | Capacitor (Semiconductor SIM Model) | GRT1885C1H102JA02D | MURATA | 2672134 | Farnell | 8 | CAPC1608X08 | 0603 [1608 Metric] | http://www.farnell.com/datasheets/2165937.pdf
C6 | 0.47uF | Capacitor (Semiconductor SIM Model) | GRM188R61A474KA61D | MURATA | 2695904 | Farnell | 1 | CAPC1608X08 | 0603 [1608 Metric] | http://www.farnell.com/datasheets/2191628.pdf
J1 |  | Jack Socket Thru-Hole Vertical 2-Conductor Open Circuit | FC681465P | CLIFF ELECTRONIC COMPONENTS | 1854512 | Farnell | 1 | CLIFF ELECTRONIC COMPONENTS_FC681465P |  | http://www.farnell.com/datasheets/1855458.pdf
J3 |  | Connecteurs carte à carte | 1241050-2 | AMP - TE CONNECTIVITY | 2399730 | Farnell | 1 | CONN_1241050-2_T |  | http://www.farnell.com/datasheets/318453.pdf
J2 |  | Connecteurs carte à carte | 1241050-3 | AMP - TE CONNECTIVITY | 9689567 | Farnell | 1 | CONN_1241050-3_T |  | http://www.farnell.com/datasheets/318453.pdf
P10, P11, P12, P13 | 10k | Potentiometer | P160KMP-0QC20B10K | Bi Technology | 1760793 | Farnell | 4
P14 |  | Header, 3-Pin | 1241150-3 | AMP - TE CONNECTIVITY | 9689478 | Farnell | 1 | CONN_1241150-3_T |  | http://www.farnell.com/datasheets/318453.pdf
P4 |  | Header, 3-Pin | 1241150-3 | AMP - TE CONNECTIVITY | 9689478 | Farnell | 1 | CONN_1241150-3_T |  | http://www.farnell.com/datasheets/318453.pdf
P5, P7 |  | Header, 3-Pin | 1241150-3 | AMP - TE CONNECTIVITY | 9689478 | Farnell | 2 | CONN_1241150-3_T |  | http://www.farnell.com/datasheets/318453.pdf
P6 |  | Header, 3-Pin | 1241150-3 | AMP - TE CONNECTIVITY | 9689478 | Farnell | 1 | CONN_1241150-3_T |  | http://www.farnell.com/datasheets/318453.pdf
P2 |  | Connecteur USB-Type-B | 1734346-1 | TE CONNECTIVITY | 1321918 | Farnell | 1 | CONN4_1-1734346 |  | http://www.farnell.com/cad/1650080.pdf
U1 |  | Gestion d'alimentation PMIC | TPS65217CRSLT | Texas Instruments | 2492485 | Farnell | 1 | CRSLT |  | http://www.ti.com/lit/ds/symlink/tps65217.pdf
Q5 | 8MHz | Ceramic Resonator | CSTCC8M00G53-R0 | MURATA | 1170435 | Farnell | 1 | CSTCC_G |  | http://www.farnell.com/datasheets/19296.pdf
U20, U52 |  | Quad Audio OpAmp | OPA1654AID | Texas Instruments | 2099889 | Farnell | 2 | D14-M |  | http://www.ti.com/lit/ds/symlink/opa1654.pdf
U24_MS - LR Converter1, U24_MS - LR Converter2, U56 |  | Quad Audio OpAmp | TL084ID | Texas Instrument | 9593462 | Farnell | 3 | D14-M |  | http://www.ti.com/lit/ds/symlink/tl084.pdf
U29, U32, U34, U37 |  | Hex Inverter | CD4069UBM | Texas Instruments | 1607751 | Farnell | 4 | D14-M |  | http://www.ti.com/lit/ds/symlink/cd4069ub.pdf
U33, U35, U38 |  | Dual Transconductance OpAmp | LM13700M/NOPB | Texas Instruments | 1468910 | Farnell | 3 | D14-M |  | http://www.ti.com/lit/ds/symlink/lm13700.pdf
U36 |  | Dual DigiPot non volatile I2C | MCP4661-503E/ST | Microchip | 1840724 | Farnell | 1 | TSSOP14_MC-M |  | http://www.farnell.com/datasheets/2243913.pdf
U18_Audio Input L, U18_Audio Input R, U18_Audio Repeat L, U18_Audio Repeat R, U19_Audio Output1, U19_Audio Output2, U19_Audio Output3 |  | Amplificateur Opérationnel | NE5532AD | Texas Instrument | 1103060 | Farnell | 7 | D8-M |  | http://www.ti.com/lit/ds/symlink/ne5532a.pdf
U22, U25_MS - LR Converter1, U25_MS - LR Converter2, U27 |  | Dual Audio OpAmp | NE5532AD | Texas Instruments | 1103060 | Farnell | 4 | D8-M |  | http://www.ti.com/lit/ds/symlink/ne5532a.pdf
U26, U28, U40, U41, U43, U44, U45, U46, U47, U48, U49, U50 |  | Single 2:1 Multiplexer | 74LVC1G3157GV,125 | NEXPERIA | 2463921 | Farnell | 12 | DBV6-M |  | http://www.farnell.com/datasheets/2053574.pdf
U7 |  | Protection_ESD | TPD4E001DBVR | Texas Instrument | 2335452 | Farnell | 1 | DBV6-M |  | http://www.ti.com/lit/ds/symlink/tpd4e001.pdf
U2, U6, U54 |  | Buffers & Transmetteurs | SN74LVC1G07DCKR | Texas Instrument | 1287544 | Farnell | 3 | DCK5 |  | http://www.ti.com/lit/ds/symlink/sn74lvc1g07.pdf
U53 |  | Optocoupler | 6N139-300E | BOADCOM | 1085023 | Farnell | 1 | DIP8_VISHAY_6N13 |  | http://www.farnell.com/datasheets/1266261.pdf
G1 |  | Ground Ultime |  |  |  |  | 1 | GND
U8 |  | Connecteur LCD & Touch screen (limande) | M50-3502042 | HARWIN | 1022307 | Farnell | 1 | HARWIN_M50-3602042 |  | http://www.farnell.com/cad/1718609.pdf
L1, L2, L3 | 2.2uH | Inductor | LQM18NN2R2K00D | MURATA | 1343118 | Farnell | 3 | INDM1608X08N | 0603 [1608 Metric] | http://www.farnell.com/datasheets/66032.pdf
L4 | 18uH | Inductor | MLF2012C180K | TDK | 1669551 | Farnell | 1 | INDM2612X12N | 0805 [2012 Metric] | http://www.farnell.com/datasheets/321059.pdf
L5, L6, L7 | 10mH | FB0805/600R/2A | LQH55DN103M03L | MURATA | 1515495 | Farnell | 3 | INDM5750X47N | 2220 [5650 Metric] | http://www.farnell.com/datasheets/5135.pdf
D10 |  | LED Blanc | LNJ037X8ARA | PANASONIC ELECTRONIC COMPONENTS | 1908051 | Farnell | 1 | LED_LNJ |  | http://www.farnell.com/datasheets/2085723.pdf
D11, D12, D13, D14, D15, D16, D17, D18, D19, D20, D21, D22, D23, D24, D25, D26, D27, D28, D29, D30, D31, D32, D33, D34, D35, D36, D37, D38, D39, D40, D41, D42, D43, D44, D45, D46, D47, D48, D49, D50, D51, D52, D53, D54, D55, D56, D57, D58 |  | LED Bleu | LNJ937W8CRA | PANASONIC ELECTRONIC COMPONENTS | 1908058 | Farnell | 48 | LED_LNJ |  | http://www.farnell.com/datasheets/1915212.pdf
D9 |  | Zener Diode | LM4041DIM3-1.2 | Texas Instruments | 9778349 | Farnell | 1 | MF03A-M |  | http://www.ti.com/lit/ds/symlink/lm4041-n.pdf
VR1, VR2 |  | Voltage Regulator | LM1117MP-5.0 | Texas Instrument | 9778209 | Farnell | 2 | MP04A |  | http://www.farnell.com/datasheets/2019100.pdf
J4 |  | Pad traversant |  |  |  |  | 1 | Pad
U17 |  | Codec Audio, 6ADC/8DAC | PCM3168APAP | TEXAS INSTRUMENTS | 2496455 | Farnell | 1 | PAP64_7X7P26 |  | http://www.ti.com/lit/ds/symlink/pcm3168a.pdf
U10 |  | 8 ADC Package SPI | MCP3008-I/SL | MICROCHIP | 1292241 | Farnell | 1 | SOIC16_MCP3008 |  | http://www.farnell.com/datasheets/808965.pdf
P15, P16 |  | DIN 5pin | PSG03463 | PRO SIGNAL | 1791756 | Farnell | 2 | PRO SIGNAL_PSG03463 |  | http://www.farnell.com/datasheets/1697491.pdf
R1, R2, R3, R4, R5, R6, R7, R8, R9, R10, R11, R12, R13, R14, R15, R16, R17, R18, R19, R20, R21, R22, R23, R24, R25, R26, R27, R28, R29, R30, R31, R32, R33, R34, R35, R36, R37, R38, R39, R40, R41, R42, R43, R44, R45, R46, R47, R48, R49, R50, R51, R52, R53, R54, R55, R56, R57, R58, R59, R60, R61, R62,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
R101 | 1K | Resistor | CPF-A-0603B1K0E1 | TE CONNECTIVITY | 2483880 | Farnell | 1 | RESC1608X05 | 0603 [1608 Metric] | http://www.farnell.com/datasheets/1935020.pdf
R102 | 1K | Resistor | CPF-A-0603B1K0E1 | TE CONNECTIVITY | 2483880 | Farnell | 1 | RESC1608X05 | 0603 [1608 Metric] | http://www.farnell.com/datasheets/1935020.pdf
R170, R273, R274, R275, R276, R277, R278, R281, R286, R296, R297, R298, R299, R300, R301, R304, R309, R316, R317, R318, R319, R320, R321, R324, R329, R339, R340, R341, R342, R343, R344, R347, R352 | 33k | Resistor | CPF-A-0603B33KE1 | TE CONNECTIVITY | 2483920 | Farnell | 33 | RESC1608X05 | 0603 [1608 Metric]
R220, R222, R227, R235, R237, R242, R250_MS - LR Converter1, R250_MS - LR Converter2, R259_MS - LR Converter1, R259_MS - LR Converter2, R263, R267, R270, R271, R272, R287, R289, R293, R294, R295, R310, R312, R313, R314, R315, R330, R332, R336, R337, R338, R353, R355, R364, R365, R370, R376, R377, R382 | 100k | Resistor | RN73C1J100KBTDF | TE CONNECTIVITY | 2687850 | Farnell | 38 | RESC1608X05 | 0603 [1608 Metric] | http://www.farnell.com/datasheets/2189072.pdf
R224, R239, R383, R386, R387 | 220k | Resistor | CPF-A-0603B220KE1 | TE CONNECTIVITY | 2483903 | Farnell | 5 | RESC1608X05 | 0603 [1608 Metric] | http://www.farnell.com/datasheets/1935020.pdf
R265, R269 | 13k | Resistor | CPF0603B13KE1 | TE CONNECTIVITY | 2330920 | Farnell | 2 | RESC1608X05 | 0603 [1608 Metric] | http://www.farnell.com/datasheets/2104089.pdf
R279, R280, R288, R302, R303, R311, R322, R323, R331, R345, R346, R354, R362, R374, R385, R402, R404, R405, R407, R408, R410, R411, R413 | 1k | Resistor | CPF-A-0603B1K0E1 | TE CONNECTIVITY | 2483880 | Farnell | 23 | RESC1608X05 | 0603 [1608 Metric] | http://www.farnell.com/datasheets/1935020.pdf
R282, R283, R305, R306, R325, R326, R348, R349 | 51k | Resistor | CPF0603B51KE1 | TE CONNECTIVITY | 2331265 | Farnell | 8 | RESC1608X05 | 0603 [1608 Metric] | http://www.farnell.com/datasheets/2043335.pdf
R284, R285, R307, R308, R327, R328, R350, R351, R369, R381 | 4.7k | Resistor | CPF-A-0603B4K7E1 | TE CONNECTIVITY | 2483933 | Farnell | 10 | RESC1608X05 | 0603 [1608 Metric] | http://www.farnell.com/datasheets/1935020.pdf
R356_Mode Select 1A, R356_Mode Select 1B, R356_Mode Select 2A, R356_Mode Select 2B | 470k | Resistor | CPF0603B470KE1 | TE CONNECTIVITY | 2331232 | Farnell | 4 | RESC1608X05 | 0603 [1608 Metric] | http://www.farnell.com/datasheets/2043335.pdf
R363, R368, R375, R380 | 150k | Resistor | CPF0603B150KE1 | TE CONNECTIVITY | 2330937 | Farnell | 4 | RESC1608X05 | 0603 [1608 Metric] | http://www.farnell.com/datasheets/2104089.pdf
R384 | 470k | Resistor | CPF0603B470KE1 | TE CONNECTIVITY | 2331232 | Farnell | 1 | RESC1608X05 | 0603 [1608 Metric] | http://www.farnell.com/datasheets/2043335.pdf
R82, R83, R84, R85, R229, R230, R231, R260_MS - LR Converter1, R260_MS - LR Converter2, R261_MS - LR Converter1, R261_MS - LR Converter2, R262, R266, R290, R291, R292, R333, R334, R335, R357_Mode Select 1A, R357_Mode Select 1B, R357_Mode Select 2A, R357_Mode Select 2B, R358_Mode Select 1A, R358_Mode Select 1B, R358_Mode Select 2A, R358_Mode Select 2B, R359_Mode Select 1A, R359_Mode Select 1B, R359_Mode Select 2A, R359_Mode Select 2B, R360, R361, R371, R372, R373, R388, R389, R390, R391, R392, R393 | 0 | Resistor |  |  |  |  | 42 | RESC1608X05 | 0603 [1608 Metric]
R86, R87, R88, R89, R90, R91, R92, R93, R94, R128, R129, R130, R131, R132, R133, R134, R135, R136, R137, R138, R139, R140, R141, R142, R143, R144, R145, R146, R147, R148, R149, R150, R151, R152, R153, R154, R155, R156, R157, R158, R159, R160, R161, R162, R163, R164, R165, R166, R167, R168, R169, R171, R172, R173, R174, R175, R176, R177, R178, R179, R180, R181, R182, R183, R184, R185, R186, R187, R188, R189, R190, R191, R192, R193, R194 | 0, 0, 10k, 10k, 100k, 100k, 0, 0, 10k, 1.2k, 0, DNI, 10k, DNI, DNI, 100K, DNI, DNI, DNI, DNI, DNI, DNI, 100K, DNI, DNI, DNI, DNI, 100K, DNI, 100K, 100K, DNI, 100K, 100K, 100K, 100K, 100K, 100K, DNI, 100K, 100K, 100K, 100K, DNI, 100K, 10k, 10k, 10k, 10k, 10k, 10k, 10k, 27k, 10k, 27k, 10k, 27k, 10k, 27k, 10k, 27k, 10k, 27k, 10k, 27k, 10k, 27k, 10k, 27k, 10k, 27k, 10k, 27k, 10k, 27k | Resistor | [NoParam], [NoParam], CPF-A-0603B4K7E1, CPF-A-0603B4K7E1, RN73C1J100KBTDF, RN73C1J100KBTDF, [NoParam], [NoParam], CPF-A-0603B4K7E1, CPF-A-0603B1K2E1, [NoParam], [NoParam], CPF-A-0603B4K7E1, [NoParam], [NoParam], RN73C1J100KBTDF, [NoParam], [NoParam], [NoParam], [NoParam], [NoParam], [NoParam], RN73C1J100KBTDF, [NoParam], [NoParam], [NoParam], [NoParam], RN73C1J100KBTDF, [NoParam], RN73C1J100KBTDF, RN73C1J100KBTDF, [NoParam], RN73C1J100KBTDF, RN73C1J100KBTDF, RN73C1J100KBTDF, RN73C1J100KBTDF, RN73C1J100KBTDF, RN73C1J100KBTDF, [NoParam], RN73C1J100KBTDF, RN73C1J100KBTDF, RN73C1J100KBTDF, RN73C1J100KBTDF, [NoParam], RN73C1J100KBTDF, CPF-A-0603B4K7E1, CPF-A-0603B4K7E1, CPF-A-0603B4K7E1, CPF-A-0603B4K7E1, CPF-A-0603B4K7E1, CPF-A-0603B4K7E1, CPF-A-0603B4K7E1, CRGH0603F27K, CPF-A-0603B4K7E1, CRGH0603F27K, CPF-A-0603B4K7E1, CRGH0603F27K, CPF-A-0603B4K7E1, CRGH0603F27K, CPF-A-0603B4K7E1, CRGH0603F27K, CPF-A-0603B4K7E1, CRGH0603F27K, CPF-A-0603B4K7E1, CRGH0603F27K, CPF-A-0603B4K7E1, CRGH0603F27K, CPF-A-0603B4K7E1, CRGH0603F27K, CPF-A-0603B4K7E1, CRGH0603F27K, CPF-A-0603B4K7E1, CRGH0603F27K, CPF-A-0603B4K7E1, CRGH0603F27K |  | [NoParam], [NoParam], 2483933, 2483933, 2687850, 2687850, [NoParam], [NoParam], 2483933, 2483896, [NoParam], [NoParam], 2483933, [NoParam], [NoParam], 2687850, [NoParam], [NoParam], [NoParam], [NoParam], [NoParam], [NoParam], 2687850, [NoParam], [NoParam], [NoParam], [NoParam], 2687850, [NoParam], 2687850, 2687850, [NoParam], 2687850, 2687850, 2687850, 2687850, 2687850, 2687850, [NoParam], 2687850, 2687850, 2687850, 2687850, [NoParam], 2687850, 2483933, 2483933, 2483933, 2483933, 2483933, 2483933, 2483933, 2332021, 2483933, 2332021, 2483933, 2332021, 2483933, 2332021, 2483933, 2332021, 2483933, 2332021, 2483933, 2332021, 2483933, 2332021, 2483933, 2332021, 2483933, 2332021, 2483933, 2332021, 2483933, 2332021 |  | 75 | RESC1608X05 | 0603 [1608 Metric]
R95 | 10k | Resistor | CPF-A-0603B4K7E1 | TE CONNECTIVITY | 2483933 | Farnell | 1 | RESC1608X05 | 0603 [1608 Metric] | http://www.farnell.com/datasheets/1935020.pdf
R96, R97 | 1K | Resistor | CPF-A-0603B1K0E1 | TE CONNECTIVITY | 2483880 | Farnell | 2 | RESC1608X05 | 0603 [1608 Metric] | http://www.farnell.com/datasheets/1935020.pdf
R98 | 1K | Resistor | CPF-A-0603B1K0E1 | TE CONNECTIVITY | 2483880 | Farnell | 1 | RESC1608X05 | 0603 [1608 Metric] | http://www.farnell.com/datasheets/1935020.pdf
R99, R100, R127, R217, R218, R219, R221, R223, R225, R226, R228, R232, R233, R234, R236, R238, R240, R241, R243, R244_MS - LR Converter1, R244_MS - LR Converter2, R245_MS - LR Converter1, R245_MS - LR Converter2, R246_MS - LR Converter1, R246_MS - LR Converter2, R247_MS - LR Converter1, R247_MS - LR Converter2, R248_MS - LR Converter1, R248_MS - LR Converter2, R249_MS - LR Converter1, R249_MS - LR Converter2, R251_MS - LR Converter1, R251_MS - LR Converter2, R252_MS - LR Converter1, R252_MS - LR Converter2, R253_MS - LR Converter1, R253_MS - LR Converter2, R254_MS - LR Converter1, R254_MS - LR Converter2, R255_MS - LR Converter1, R255_MS - LR Converter2, R256_MS - LR Converter1, R256_MS - LR Converter2, R257_MS - LR Converter1, R257_MS - LR Converter2, R258_MS - LR Converter1, R258_MS - LR Converter2, R264, R268, R366, R367, R378, R379 | 1K, 1K, 1K, 10k, 10k, 10k, 10k, 10k, 10k, 10k, 10k, 10k, 10k, 10k, 10k, 10k, 10k, 10k, 10k, 10k, 10k, 10k, 10k, 10k, 10k, 10k, 10k, 10k, 10k, 10k, 10k, 10k, 10k, 10k, 10k, 10k, 10k, 10k, 10k, 10k, 10k, 10k, 10k, 10k, 10k, 10k, 10k, 10k, 10k, 10k, 10k, 10k, 10k | Resistor | CPF-A-0603B1K0E1, CPF-A-0603B1K0E1, CPF-A-0603B1K0E1, CPF-A-0603B4K7E1, CPF-A-0603B4K7E1, CPF-A-0603B4K7E1, CPF-A-0603B4K7E1, CPF-A-0603B4K7E1, CPF-A-0603B4K7E1, CPF-A-0603B4K7E1, CPF-A-0603B4K7E1, CPF-A-0603B4K7E1, CPF-A-0603B4K7E1, CPF-A-0603B4K7E1, CPF-A-0603B4K7E1, CPF-A-0603B4K7E1, CPF-A-0603B4K7E1, CPF-A-0603B4K7E1, CPF-A-0603B4K7E1, CPF-A-0603B4K7E1, CPF-A-0603B4K7E1, CPF-A-0603B4K7E1, CPF-A-0603B4K7E1, CPF-A-0603B4K7E1, CPF-A-0603B4K7E1, CPF-A-0603B4K7E1, CPF-A-0603B4K7E1, CPF-A-0603B4K7E1, CPF-A-0603B4K7E1, CPF-A-0603B4K7E1, CPF-A-0603B4K7E1, CPF-A-0603B4K7E1, CPF-A-0603B4K7E1, CPF-A-0603B4K7E1, CPF-A-0603B4K7E1, CPF-A-0603B4K7E1, CPF-A-0603B4K7E1, CPF-A-0603B4K7E1, CPF-A-0603B4K7E1, CPF-A-0603B4K7E1, CPF-A-0603B4K7E1, CPF-A-0603B4K7E1, CPF-A-0603B4K7E1, CPF-A-0603B4K7E1, CPF-A-0603B4K7E1, CPF-A-0603B4K7E1, CPF-A-0603B4K7E1, CPF-A-0603B4K7E1, CPF-A-0603B4K7E1, CPF-A-0603B4K7E1, CPF-A-0603B4K7E1, CPF-A-0603B4K7E1, CPF-A-0603B4K7E1 | TE CONNECTIVITY | 2483880, 2483880, 2483880, 2483933, 2483933, 2483933, 2483933, 2483933, 2483933, 2483933, 2483933, 2483933, 2483933, 2483933, 2483933, 2483933, 2483933, 2483933, 2483933, 2483933, 2483933, 2483933, 2483933, 2483933, 2483933, 2483933, 2483933, 2483933, 2483933, 2483933, 2483933, 2483933, 2483933, 2483933, 2483933, 2483933, 2483933, 2483933, 2483933, 2483933, 2483933, 2483933, 2483933, 2483933, 2483933, 2483933, 2483933, 2483933, 2483933, 2483933, 2483933, 2483933, 2483933 | Farnell | 53 | RESC1608X05 | 0603 [1608 Metric] | http://www.farnell.com/datasheets/1935020.pdf
U55 |  | 16b I/O Expander | MCP23017-E/SO | MICROCHIP | 1332087 | Farnell | 1 | SOIC28_MCP23017 |  | http://www.farnell.com/datasheets/12179.pdf
U30 |  | Dual Transconductance OpAmp | LM13700M/NOPB | Texas Instruments | 1468910 | Farnell | 1 | SO16NB |  | http://www.ti.com/lit/ds/symlink/lm13700.pdf
D1, D2, D3, D4, D5, D6, D7, D8, D59, D60, D61, D62, D63, D64, D65, D66, D67, D68, D69, D70, D71 |  | Diode signaux faibles | 1N4148WS | ON SEMICONDUCTOR | 2453269 | Farnell | 21 | SOD323-M |  | http://www.farnell.com/datasheets/2288055.pdf
Q1 |  |  | ABMM2-24.000MHZ-E2-T | ABRACON | 2467855 | Farnell | 1 | SON440P360X120-4N |  | http://www.farnell.com/datasheets/1750519.pdf | Composant Package SON insoudable à la main (à sourcer en CMS)
Q2 | 32,768KHz | Crystal Oscillator | LFXTAL003000 | IQD FREQUENCY PRODUCTS | 9713220 | Farnell | 1 | SON550P380X250-4N |  | http://www.farnell.com/datasheets/2175893.pdf | Composant Package SON insoudable à la main (à sourcer en CMS)
U39_Mode Select 1A, U39_Mode Select 1B, U39_Mode Select 2A, U39_Mode Select 2B |  | Dual 4:1 Multiplexer | 74HC4052D | NEXPERIA | 1201328 | Farnell | 4 | SOT109-1-M |  | http://www.farnell.com/datasheets/2051461.pdf
VR3 |  | Voltage Regulator | TS2940CW-3.3 RP | TAIWAN SEMICONDUCTOR | 7261403 | Farnell | 1 | SOT230P715X180-4N |  | http://www.farnell.com/datasheets/2044143.pdf
Q3 |  | NPN Bipolar Transistor | SMMUN2214LT1G | ON SEMICONDUCTOR | 9556672 | Farnell | 1 | SOT95P234X111-3N |  | http://www.farnell.com/datasheets/1813846.pdf
Q4 |  | PNP Bipolar Transistor | SMMUN2114LT1G | ON SEMICONDUCTOR | 2724481 | Farnell | 1 | SOT95P234X111-3N |  | http://www.farnell.com/datasheets/2237089.pdf
VR4 |  | Voltage Regulator | MIC5270-5.0YM5-TR | MICROCHIP | 2510308 | Farnell | 1 | SOT95P280X130-5N |  | http://www.farnell.com/datasheets/29611.pdf
U9 |  | Connecteur LCD & Touch screen | 4-1734592-0 | TE Connectivity | 1816399 | Farnell | 1 | TE_4-1734592-0 |  | http://www.farnell.com/cad/1794473.pdf
U23_MS - LR Converter1, U23_MS - LR Converter2, U42 |  | Quad 2:1 Multiplexer | FSAL200QSCX | ON SEMICONDUCTOR | 2450768 | Farnell | 3 | TSOP65P730X110-16N |  | http://www.farnell.com/datasheets/2299862.pdf
U21, U31, U51 |  | Dual DigiPot non volatile I2C | MCP4661-503E/ST | Microchip | 1840724 | Farnell | 3 | TSSOP14_MC-M |  | http://www.farnell.com/datasheets/2243913.pdf
U58, U59 |  | Dual DigiPot non volatile 10Klog I2C | AD5142AWBCPZ10-RL7 | AD | 2768195 | Farnell | 2 | TSSOP14_MC-M |  | http://www.farnell.com/datasheets/2313394.pdf
U5 |  | Mémoire Flash/NAND | S34MS02G100BHI000 | CYPRESS SEMICONDUCTOR | 2772804 | Farnell | 1 | VBM063 |  | http://www.farnell.com/datasheets/2330450.pdf
P3 |  | Embase mémoire | 693063020911 | WURTH ELEKTRONIK | 2081361 | Farnell | 1 | WURTH ELEKTRONIK_693063020911 |  | http://www.farnell.com/datasheets/1912447.pdf
U3 |  | Microprocesseur ARM | AM3352BZCZ100 | Texas Instrument | 2494119 | Farnell | 1 | ZCZ324 |  | http://www.ti.com/lit/ds/symlink/am3352.pdf
 |  |  |  |  |  |  | 1018 |  |  |  | Bon courage :)
