adjivas/electronic-levelup/STL/CONN_1241050-2_TYCO-M.step

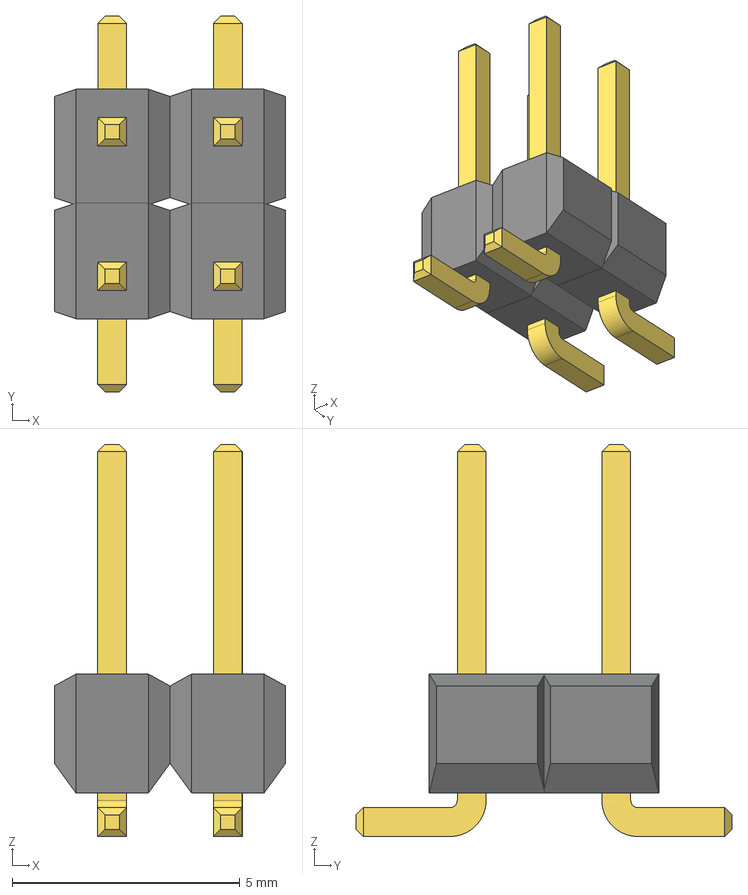
[picture p7: CAD file, 2018-04-01]
STL/CONN_1241050-2_TYCO-M.step
5.08 x 8.26 x 8.61 mm
