adjivas/electronic-levelup/STL/CONN_1241050-3_TYCO-L.step

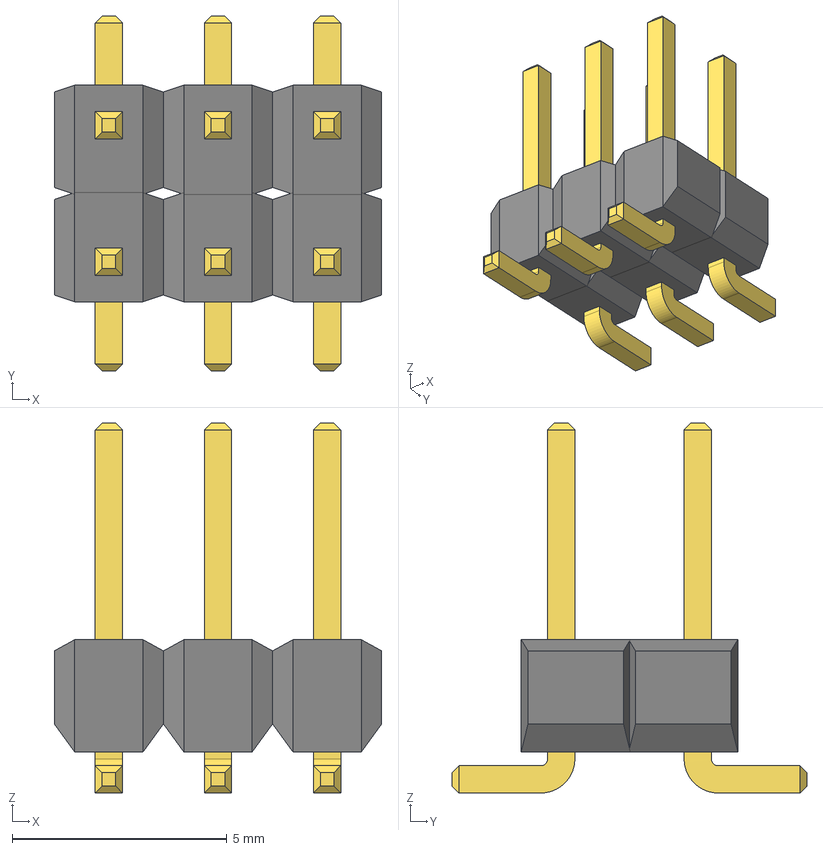
[picture p8: CAD file, 2018-04-01]
STL/CONN_1241050-3_TYCO-L.step
7.62 x 8.26 x 8.61 mm
