adjivas/electronic-levelup/STL/CONN_1241150-3_TYCO-M.step

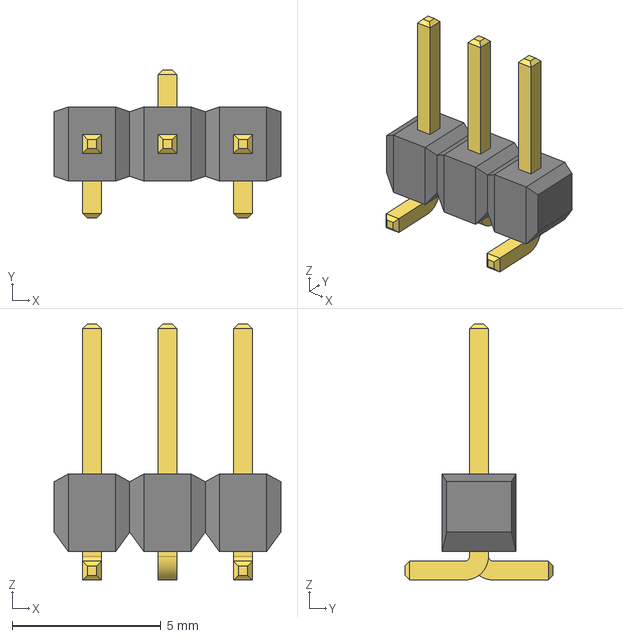
[picture p9: CAD file, 2018-04-01]
STL/CONN_1241150-3_TYCO-M.step
7.62 x 4.98 x 8.61 mm
