adjivas/electronic-levelup/STL/LED_LNJ.step

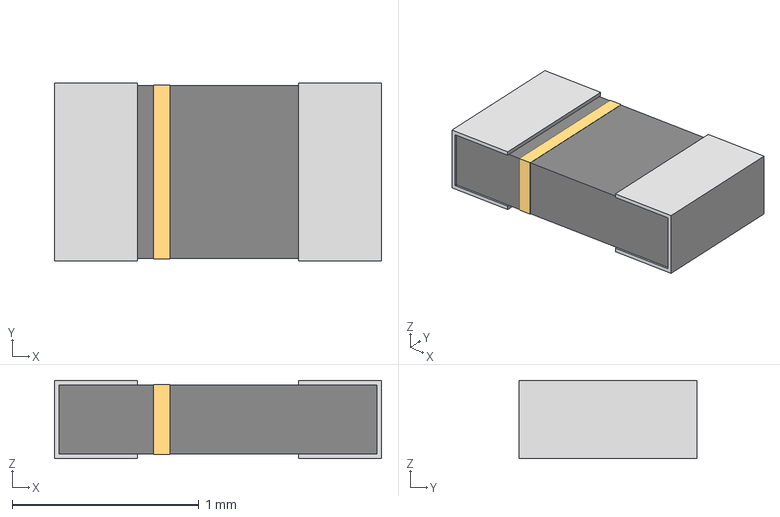
[picture p10: CAD file, 2018-04-01]
STL/LED_LNJ.step
1.75 x 0.95 x 0.42 mm
