adjivas/electronic-levelup/STL/DBV6.step

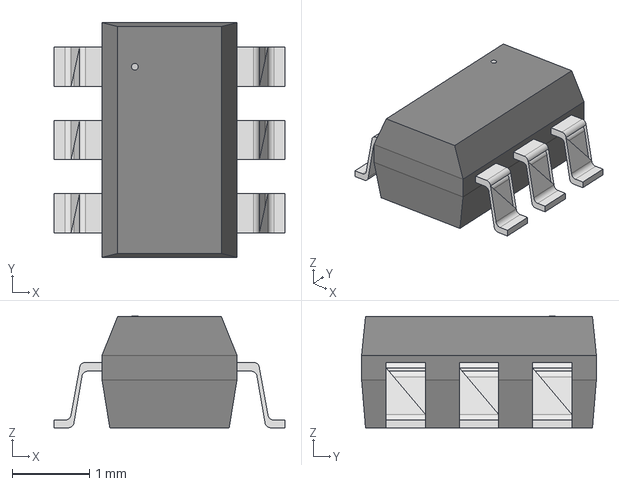
[picture p11: CAD file, 2018-03-29]
STL/DBV6.step
3.00 x 3.05 x 1.45 mm
