adjivas/electronic-levelup/STL/SOD323-M.step

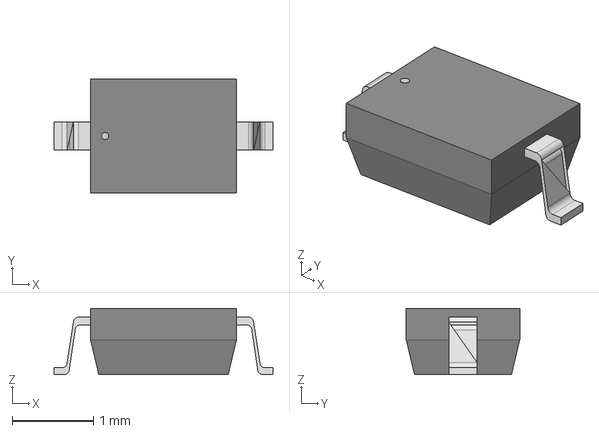
[picture p12: CAD file, 2018-03-29]
STL/SOD323-M.step
2.70 x 1.40 x 0.815 mm
