adjivas/electronic-levelup/STL/D14-L.step

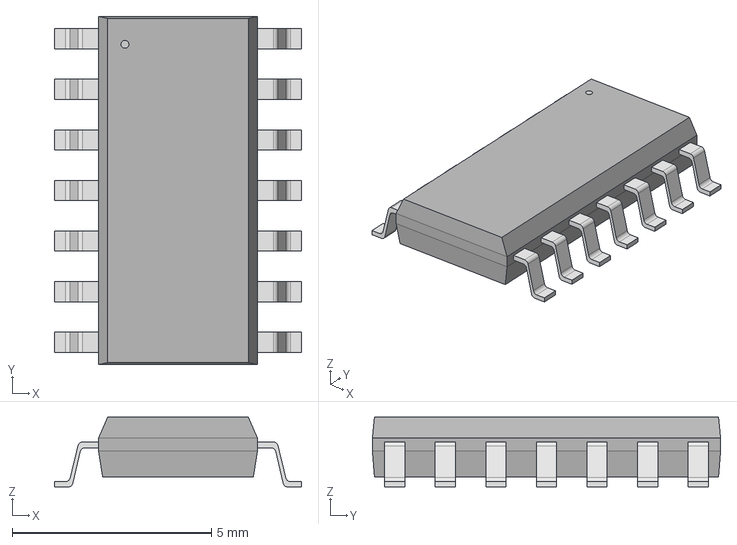
[picture p13: CAD file, 2018-03-28]
STL/D14-L.step
6.20 x 8.74 x 1.75 mm
