adjivas/electronic-levelup/STL/PAP64_7X7P26-M.step

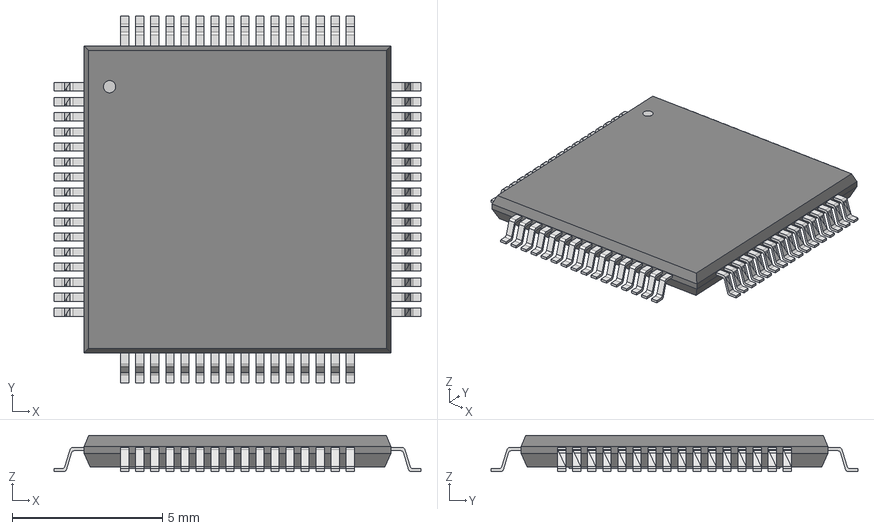
[picture p14: CAD file, 2018-03-28]
STL/PAP64_7X7P26-M.step
12.2 x 12.2 x 1.20 mm
