adjivas/electronic-levelup/STL/LED_PLCC_VSMB-L.step

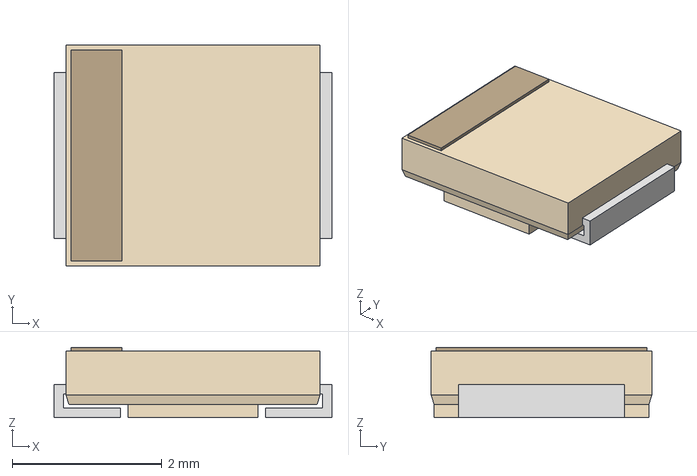
[picture p15: CAD file, 2018-03-28]
STL/LED_PLCC_VSMB-L.step
3.71 x 2.95 x 0.94 mm
