adjivas/electronic-levelup/STL/32A-M.step

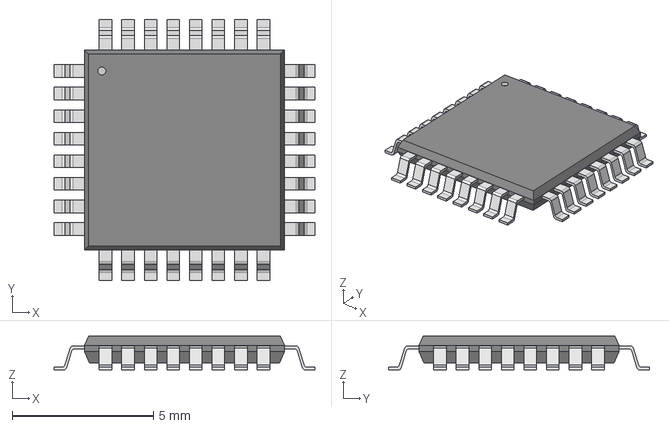
[picture p16: CAD file, 2018-03-28]
STL/32A-M.step
9.25 x 9.25 x 1.20 mm
