adjivas/electronic-levelup/STL/21-0061L-L.step

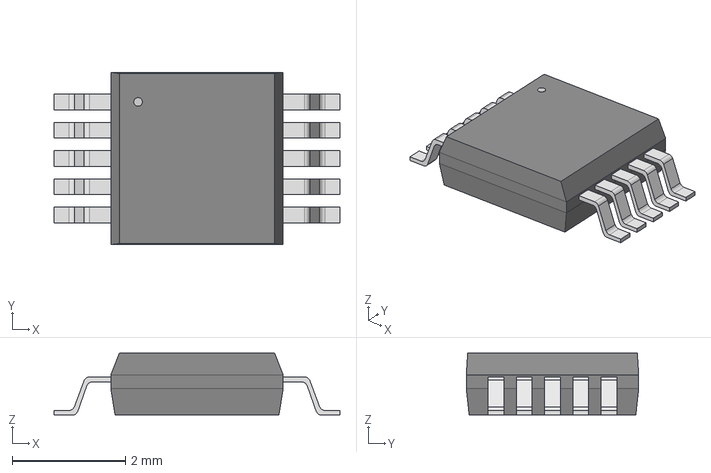
[picture p17: CAD file, 2018-03-28]
STL/21-0061L-L.step
5.05 x 3.05 x 1.09 mm
