adjivas/electronic-levelup/STL/D8-L.step

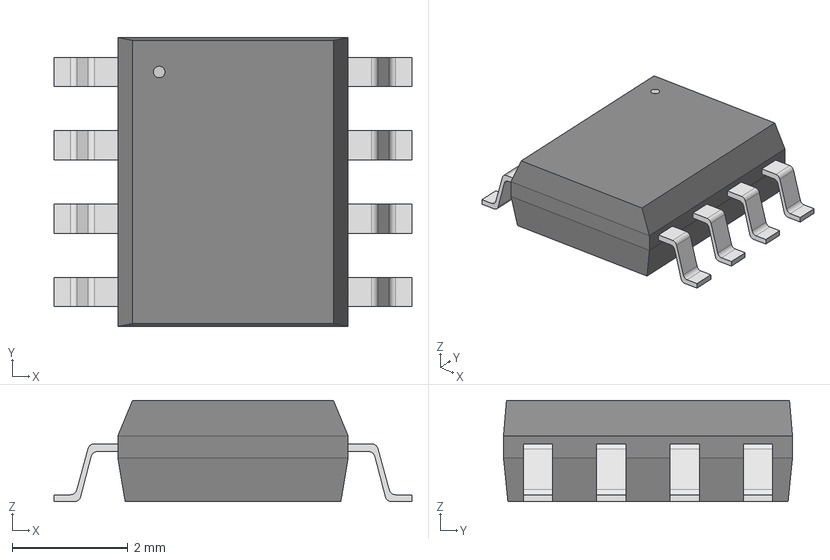
[picture p18: CAD file, 2018-03-28]
STL/D8-L.step
6.20 x 5.00 x 1.75 mm
