adjivas/electronic-levelup/STL/DIP8_VISHAY_6N13X.step

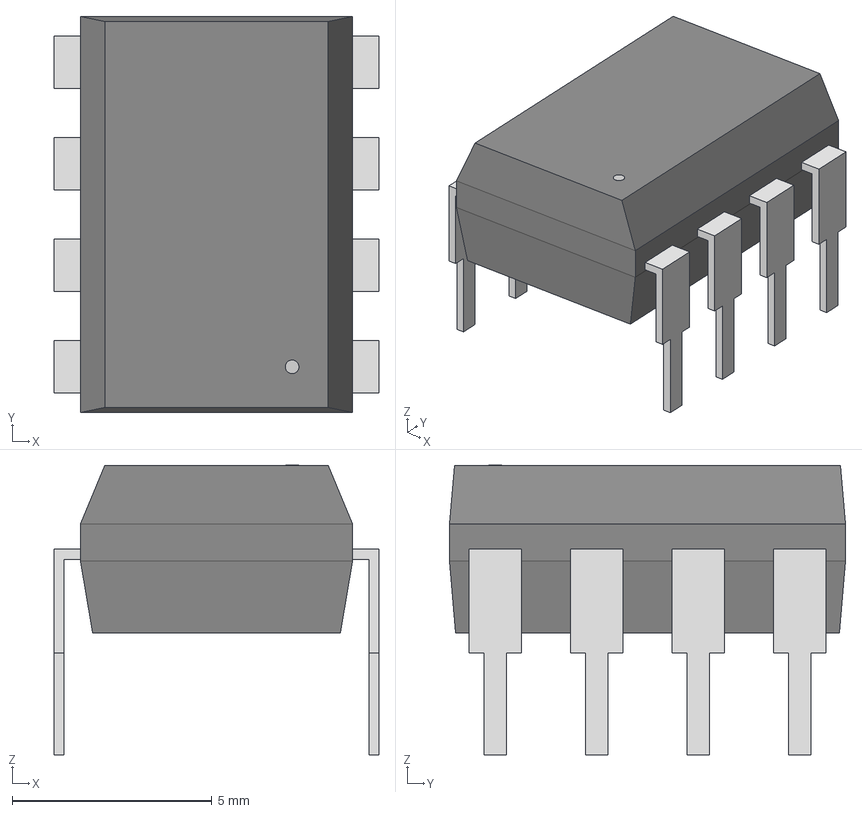
[picture p19: CAD file, 2018-03-28]
STL/DIP8_VISHAY_6N13X.step
8.13 x 9.91 x 7.24 mm
