adjivas/electronic-levelup/STL/DCK5-M.step

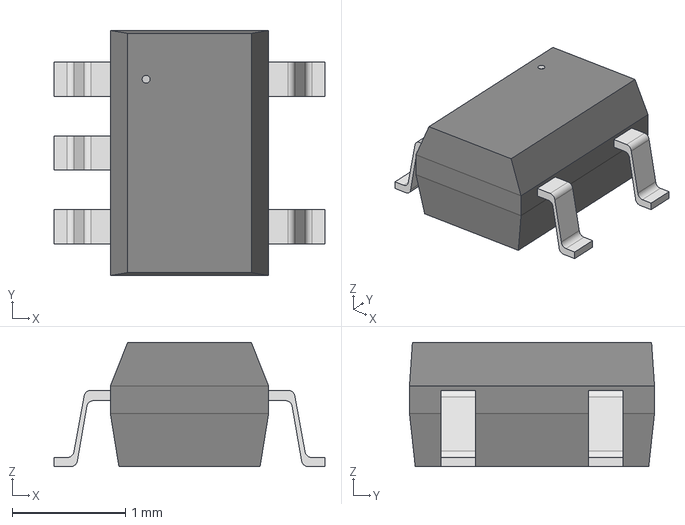
[picture p20: CAD file, 2018-03-28]
STL/DCK5-M.step
2.39 x 2.16 x 1.09 mm
