adjivas/electronic-levelup/STL/MP04A-M.step

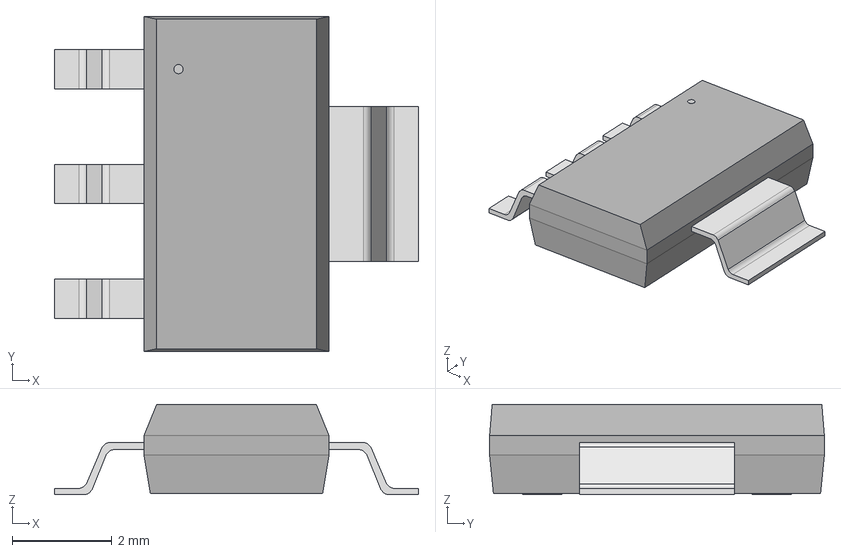
[picture p21: CAD file, 2018-03-28]
STL/MP04A-M.step
7.29 x 6.71 x 1.81 mm
