adjivas/electronic-levelup/STL/SO16NB.step

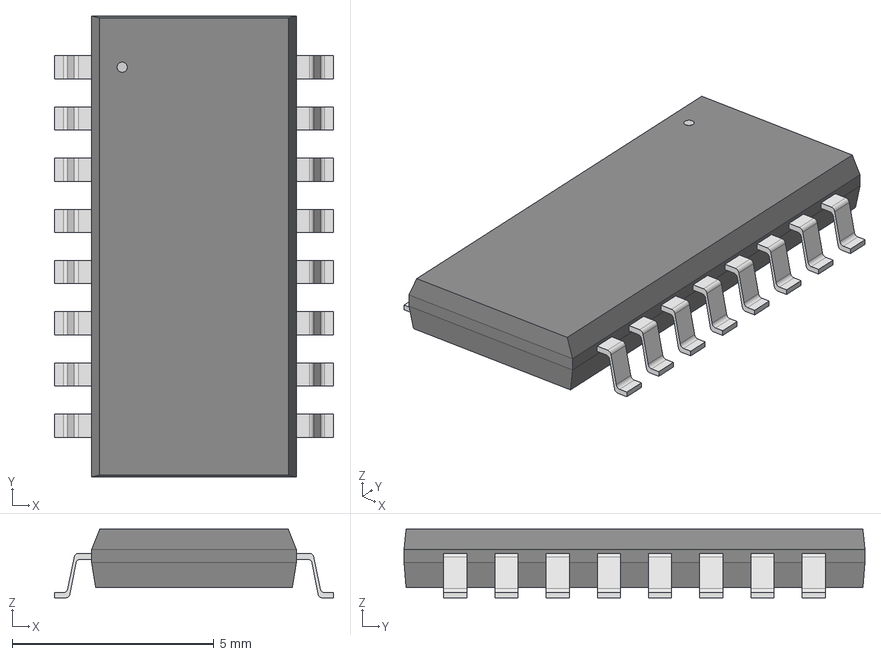
[picture p22: CAD file, 2018-03-28]
STL/SO16NB.step
6.92 x 11.4 x 1.70 mm
