adjivas/electronic-levelup/STL/21-0042B_24.step

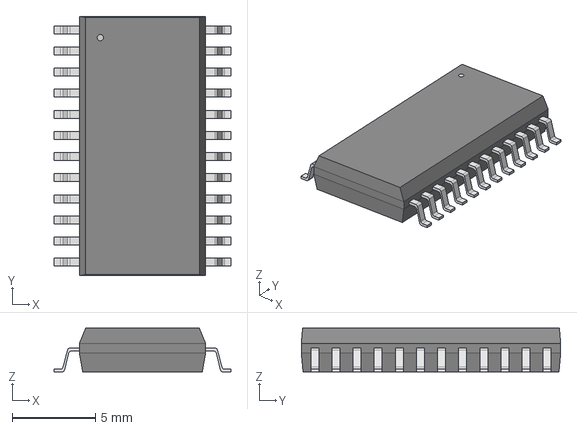
[picture p23: CAD file, 2018-03-28]
STL/21-0042B_24.step
10.6 x 15.6 x 2.64 mm
