adjivas/electronic-levelup/STL/BGA-63_VBM063.step

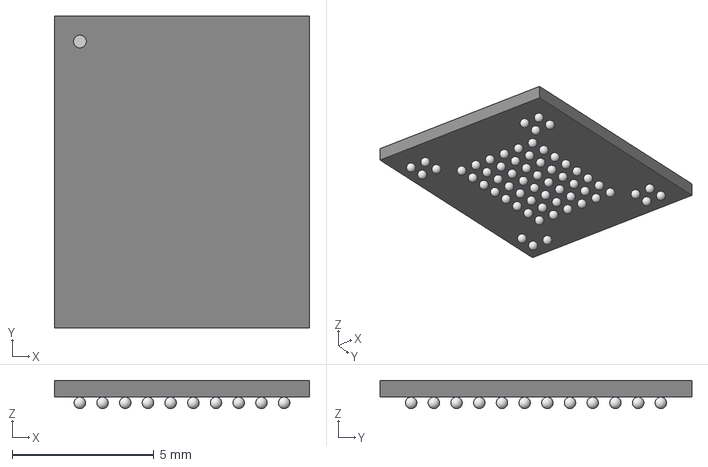
[picture p24: CAD file, 2018-03-28]
STL/BGA-63_VBM063.step
8.99 x 11.0 x 0.993 mm
