adjivas/electronic-levelup/STL/SOT109-1-M.step

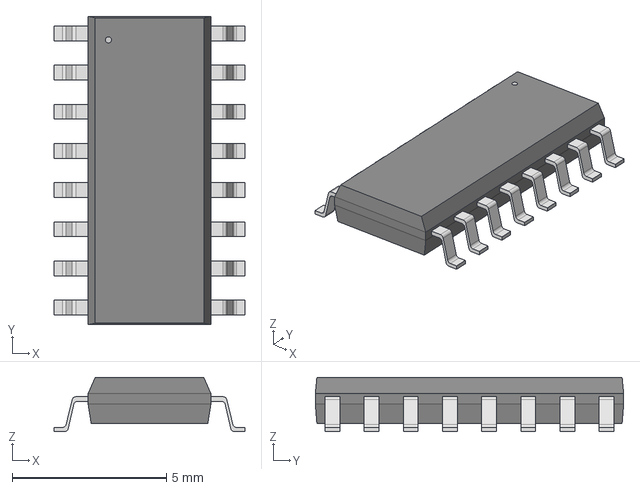
[picture p25: CAD file, 2018-03-28]
STL/SOT109-1-M.step
6.20 x 10.0 x 1.75 mm
