adjivas/electronic-levelup/STL/SO14NB.step

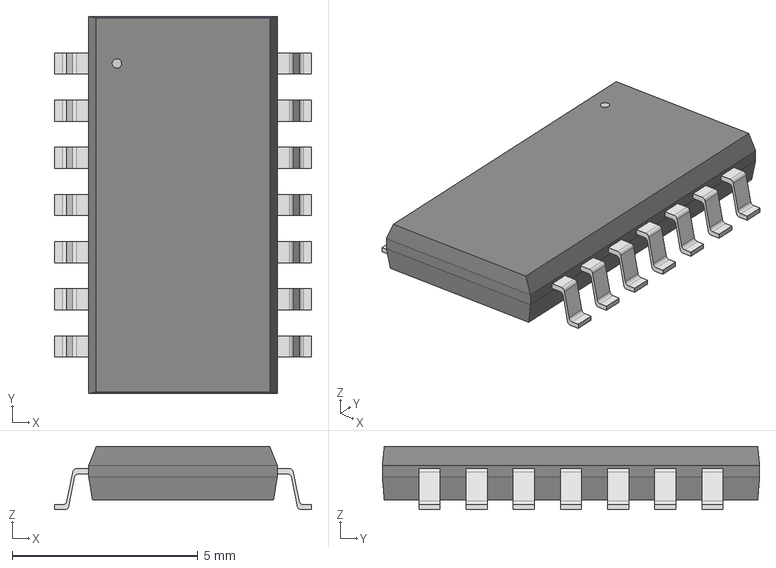
[picture p26: CAD file, 2018-03-28]
STL/SO14NB.step
6.92 x 10.2 x 1.70 mm
