adjivas/electronic-levelup/STL/RSL48_4P05X4P05.step

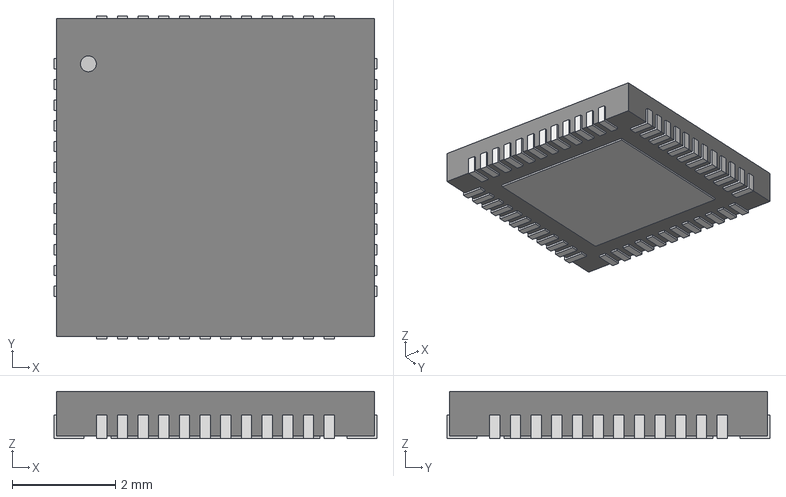
[picture p27: CAD file, 2018-03-28]
STL/RSL48_4P05X4P05.step
6.25 x 6.25 x 0.917 mm
