adjivas/electronic-levelup/(list of files, cad)

Other CAD files:
STL/MIDI.step
STL/Double-Jack.step
STL/PowerSwitch.step
STL/USB.step
STL/BarrelAlim.step
STL/CONN_1241050-3_TYCO-M.step
STL/CONN_1241150-3_TYCO.step
STL/CONN_1241050-3_TYCO.step
STL/CONN_1241050-2_TYCO.step
STL/CONN_1241150-3_TYCO-L.step
STL/CONN_1241050-2_TYCO-L.step
STL/DBV6-L.step
STL/DBV6-M.step
STL/SOD323.step
STL/SOD323-L.step
STL/D14-M.step
STL/D14.step
STL/D8-M.step
STL/D8.step
STL/MP04A.step
STL/DCK5-L.step
STL/DCK5.step
STL/PAP64_7X7P26.step
STL/32A-L.step
STL/MP04A-L.step
STL/21-0061L.step
STL/21-0042B_24-M.step
STL/PAP64_7X7P26-L.step
STL/LED_PLCC_VSMB-M.step
STL/SOT109-1-L.step
STL/SOT109-1.step
STL/LED_PLCC_VSMB.step
STL/21-0042B_24-L.step
STL/21-0061L-M.step
STL/32A.step
