adjivas/electronic-levelup/Dossier de Fabrication/Stackup.png

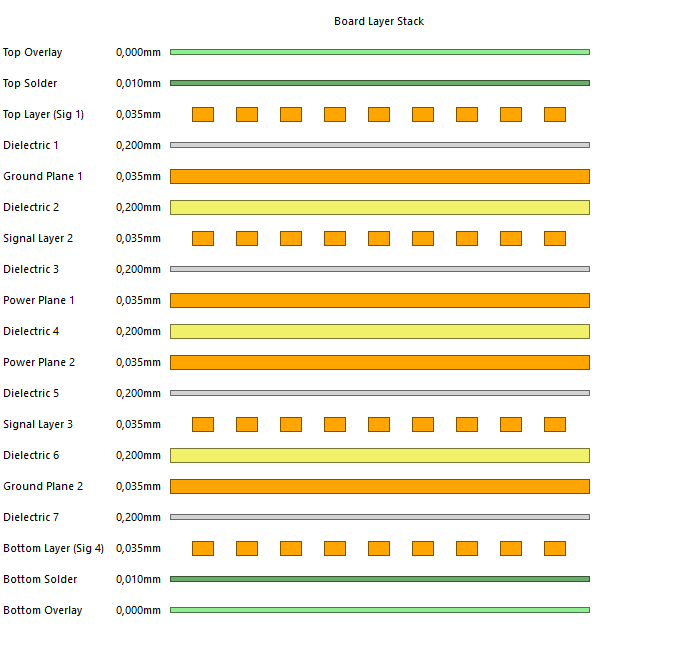
Dossier de Fabrication/Stackup.png
