adjivas/electronic-levelup/Dossier de Fabrication/Assembly Drawings.pdf

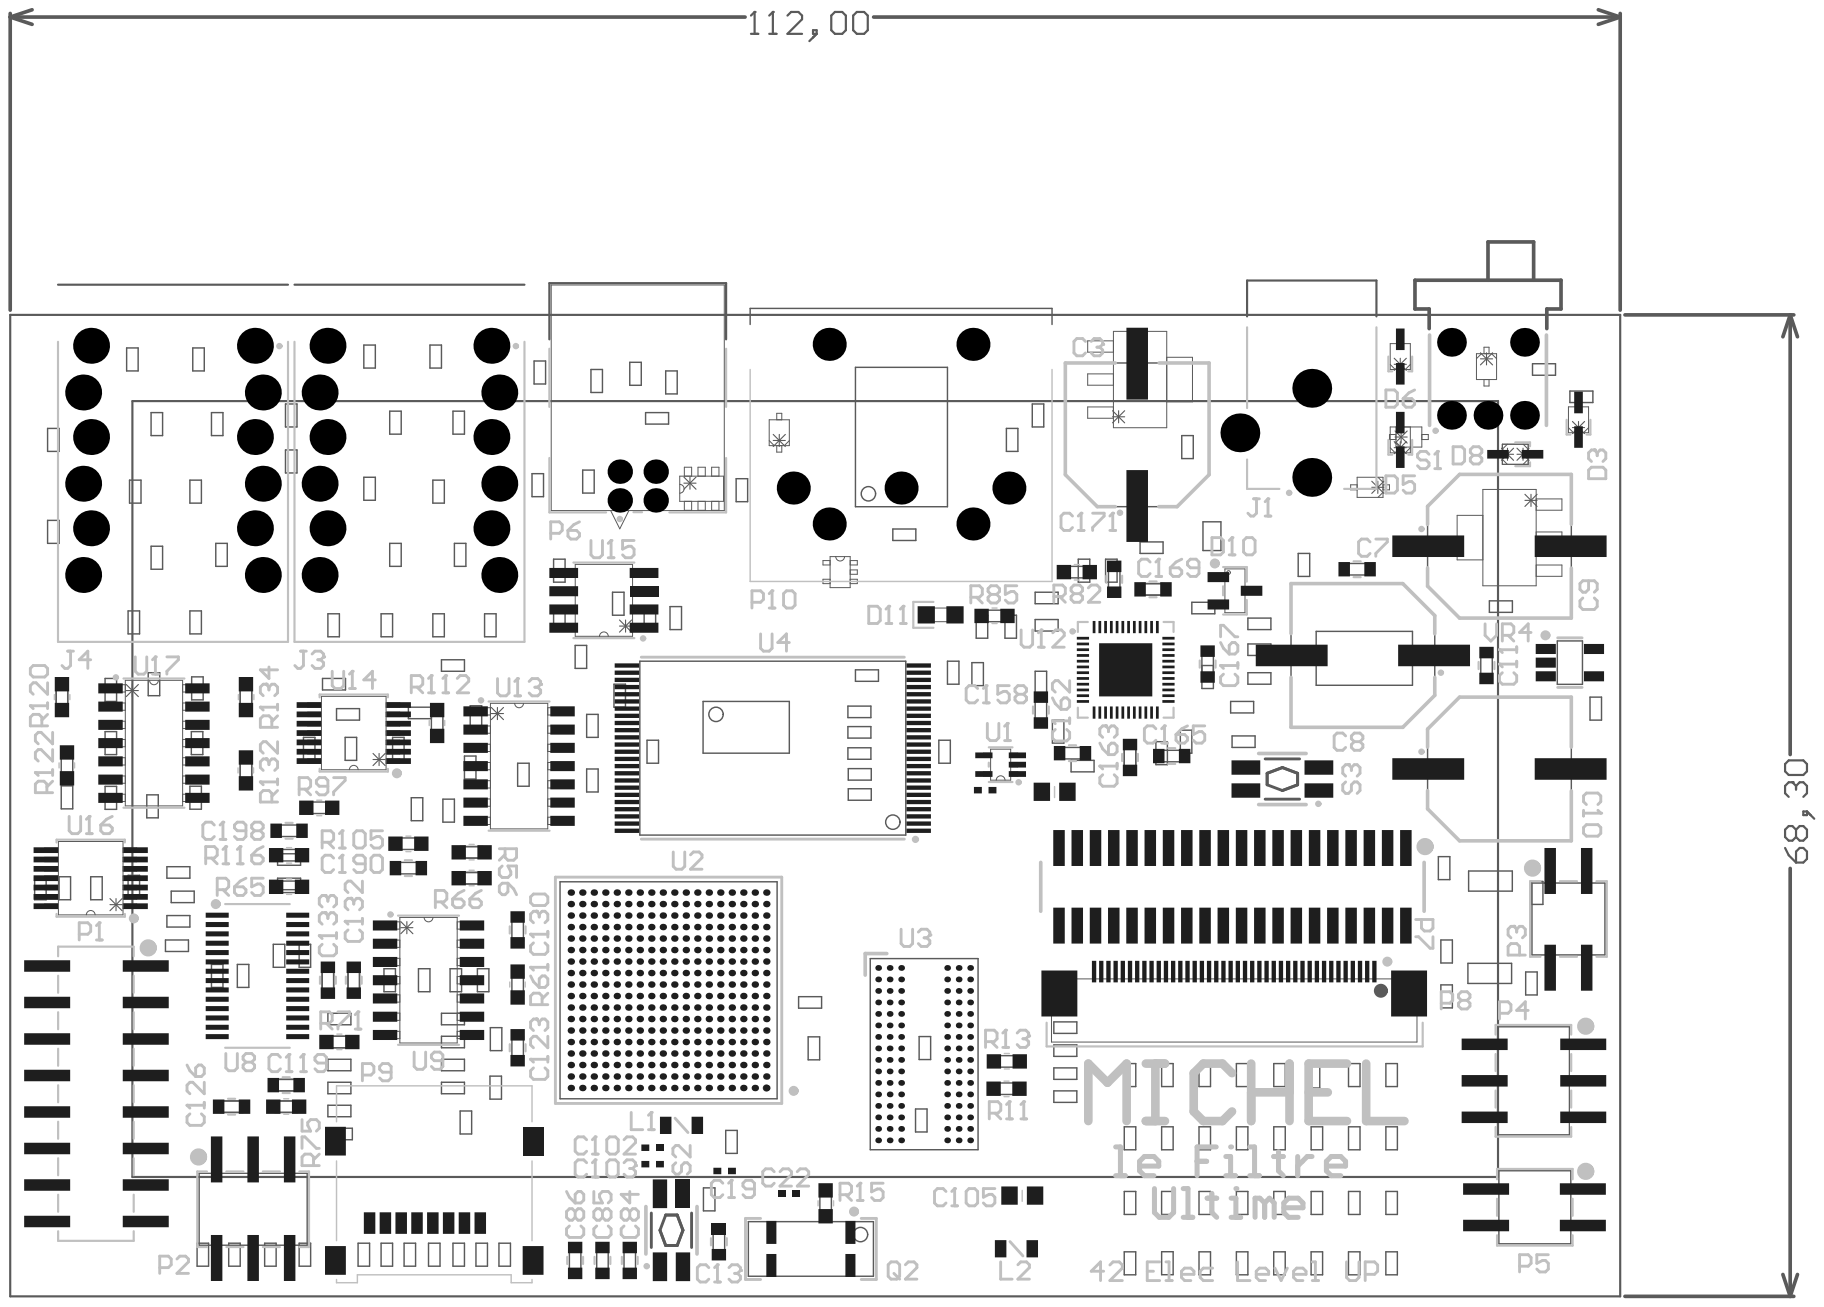
[picture p29: page 1]

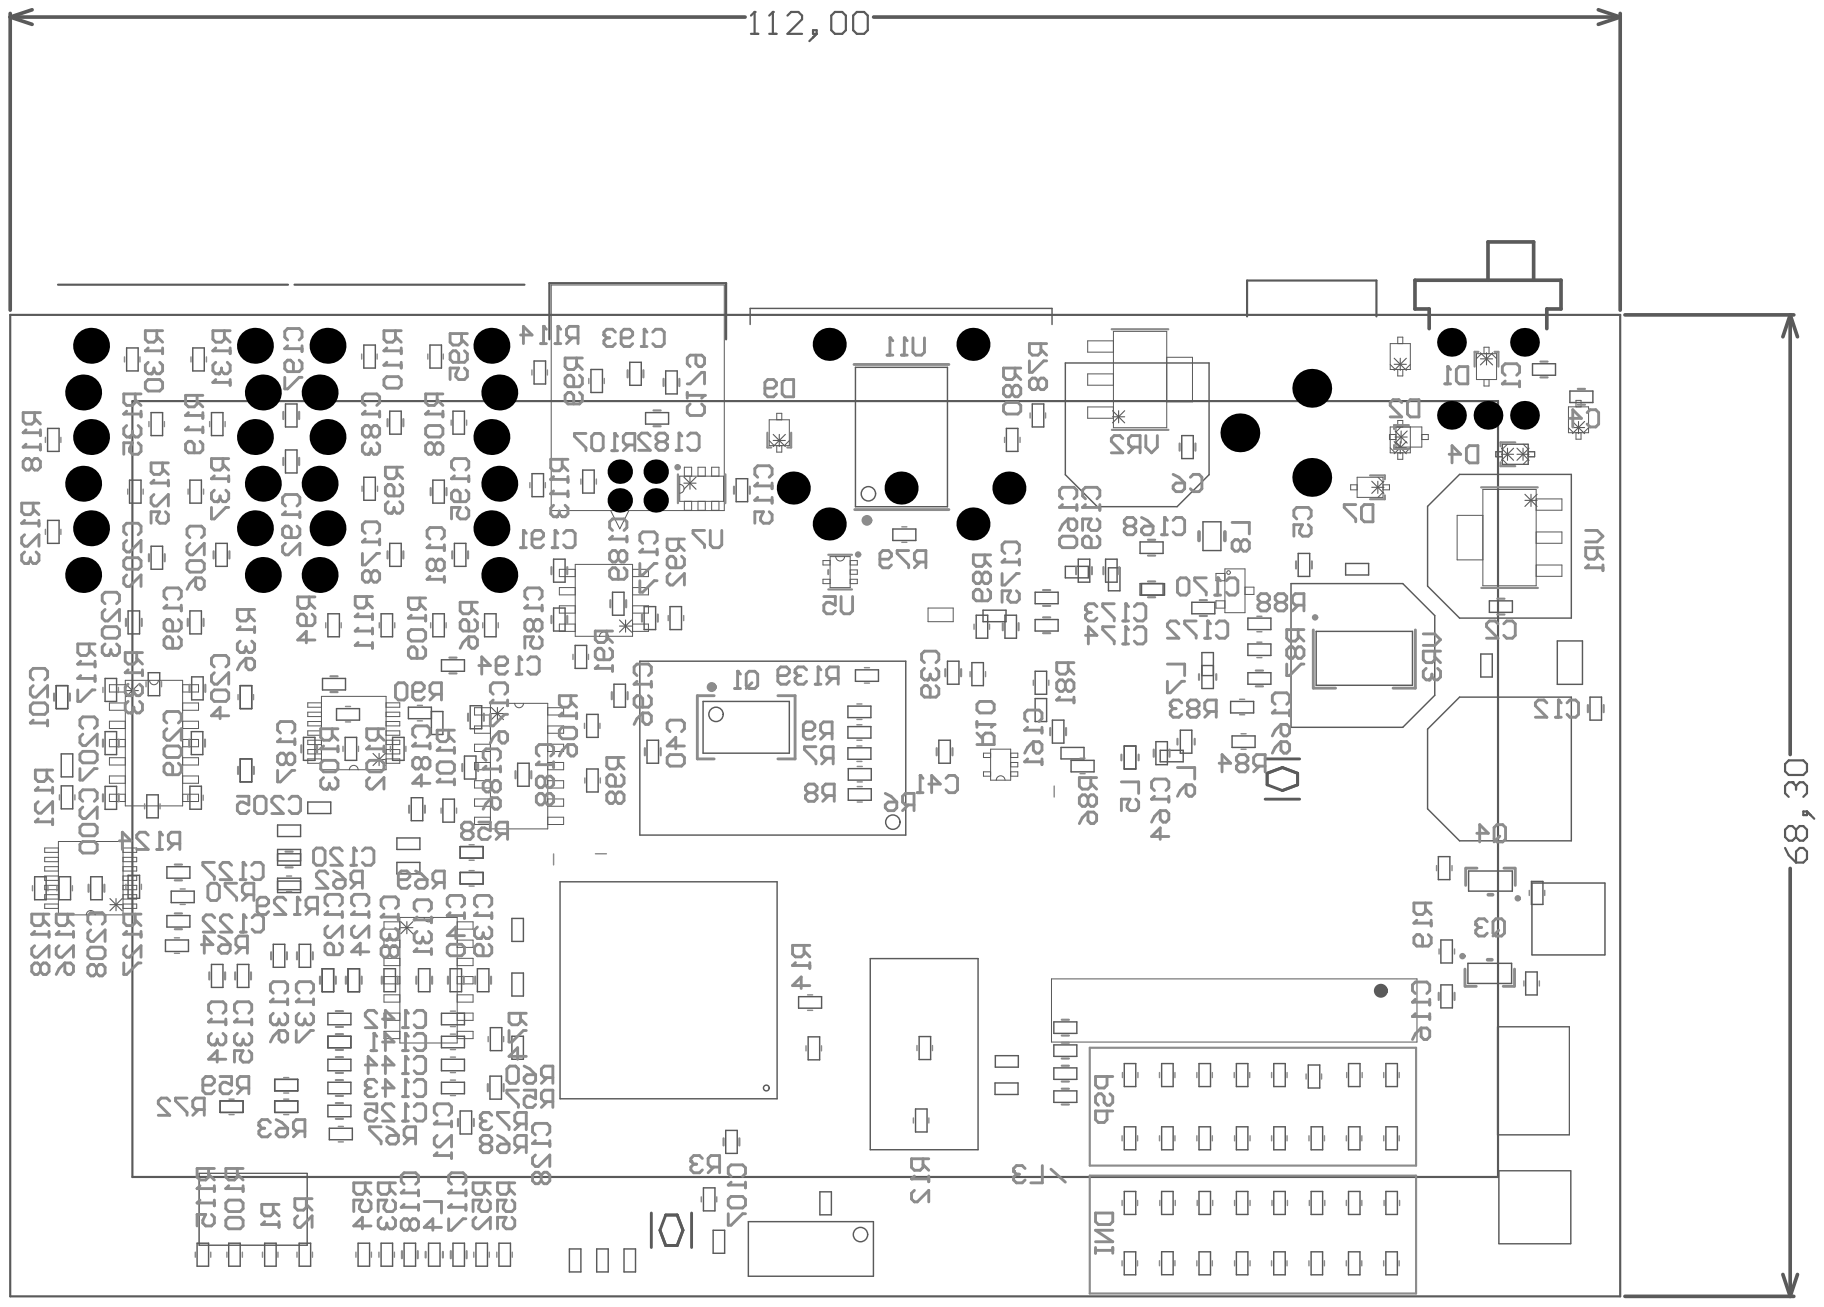
[picture p30: page 2]

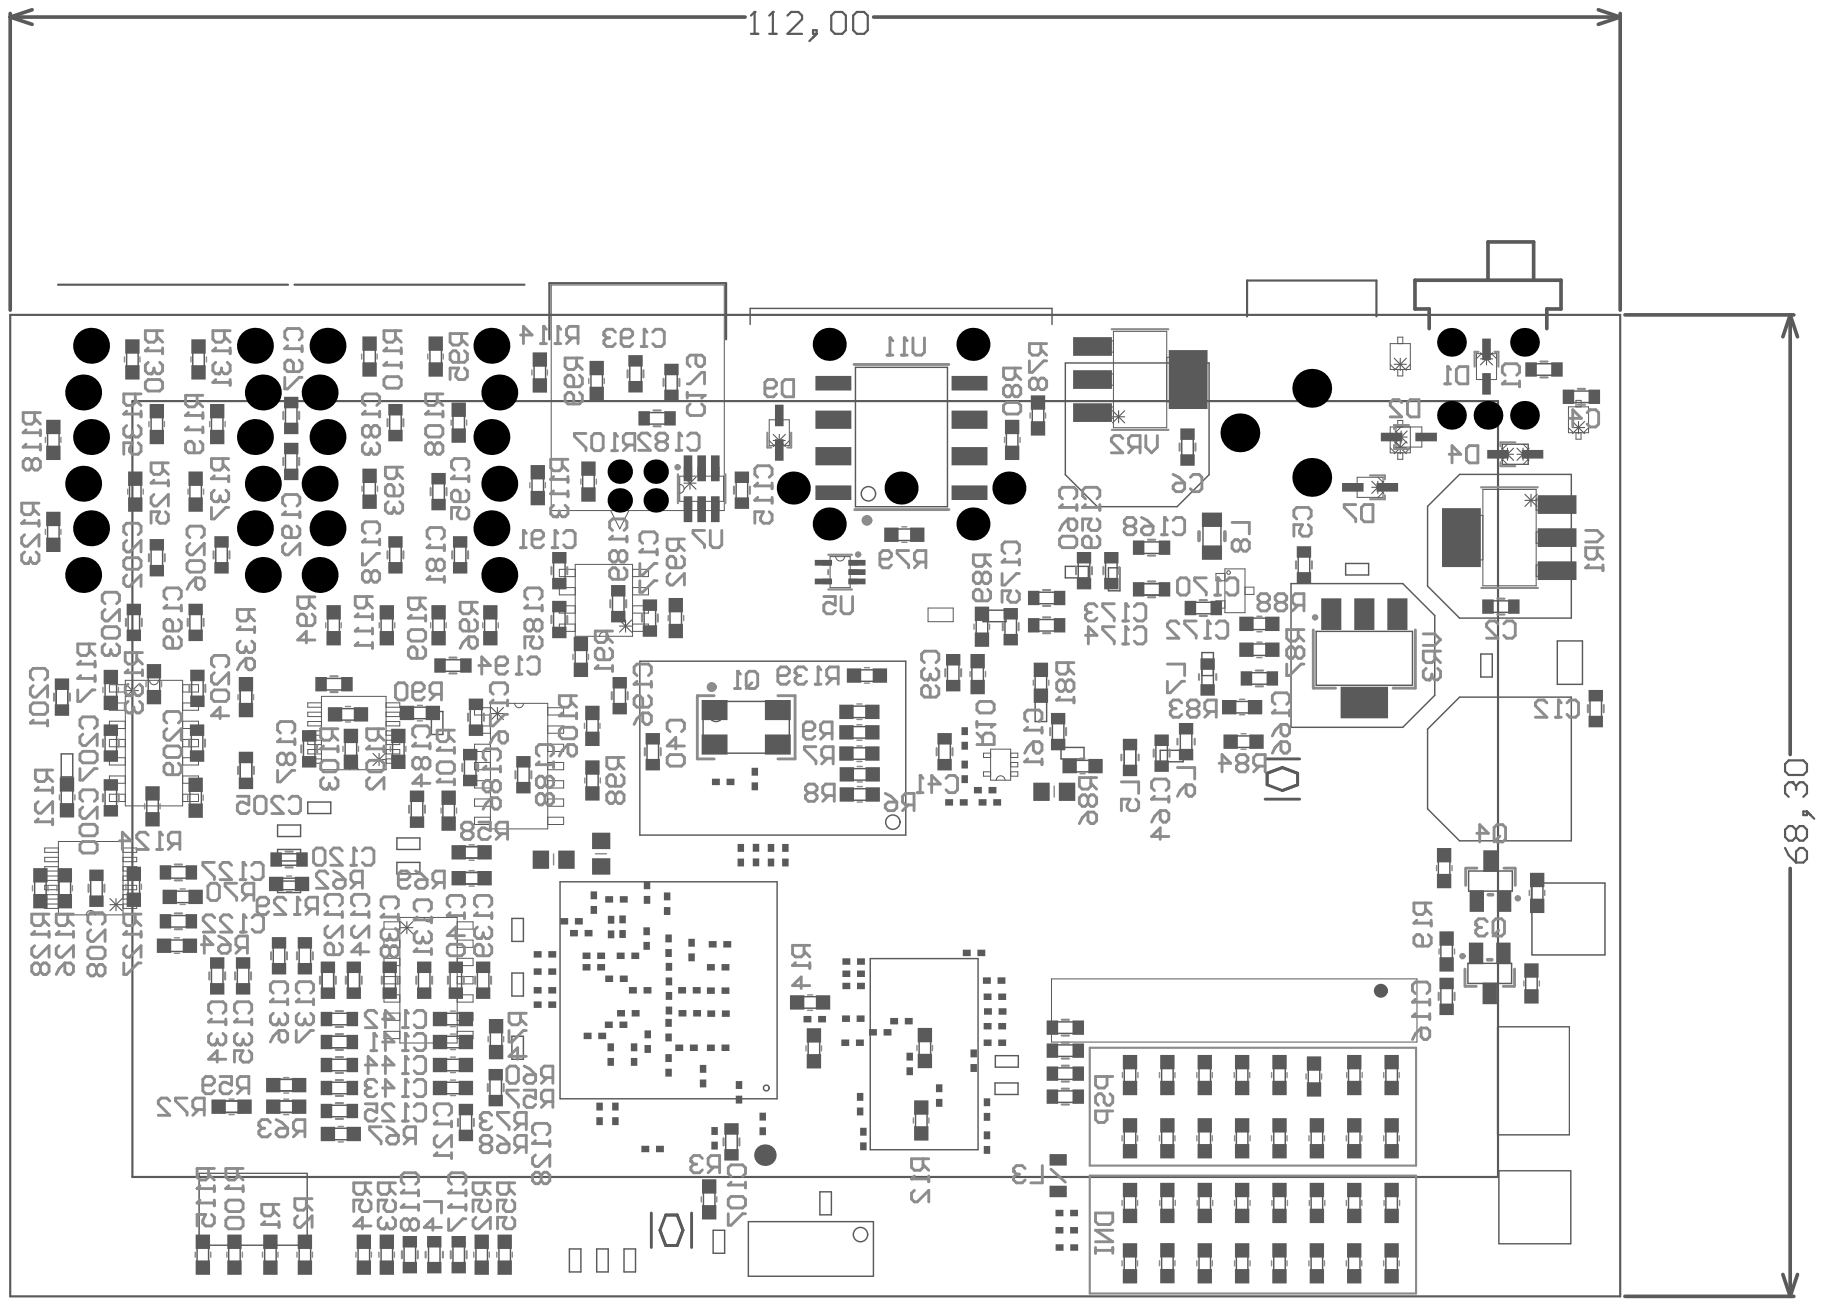
[picture p31: page 4]
