adjivas/electronic-levelup/Dossier de Fabrication/Mechanical Drawings.pdf

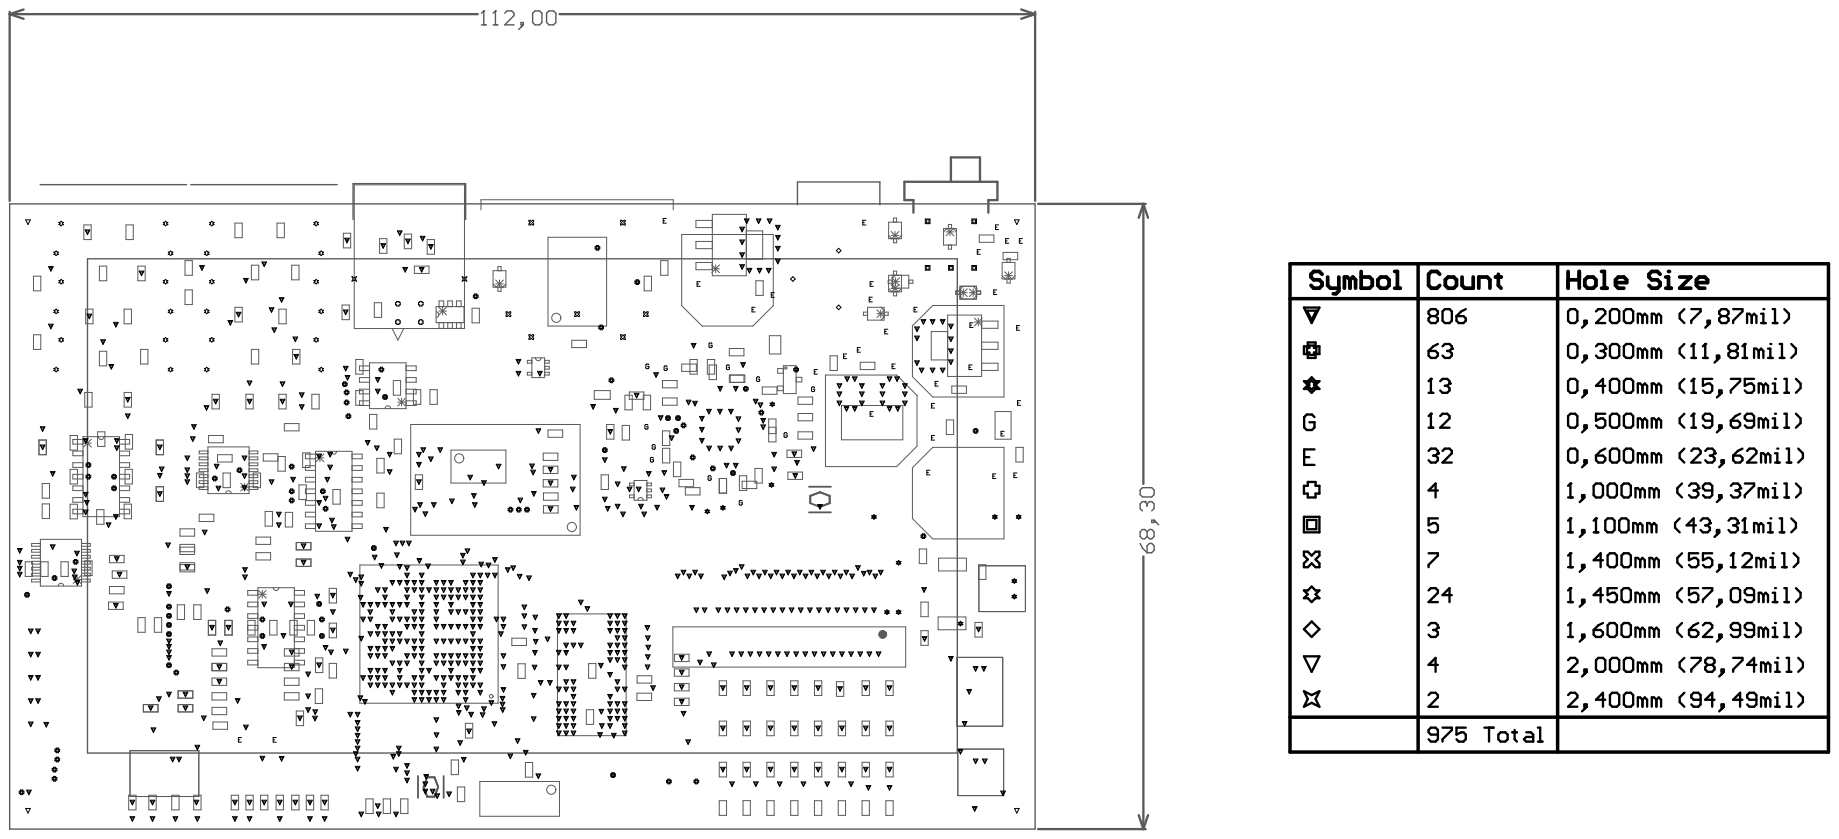
[picture p32: page 1]

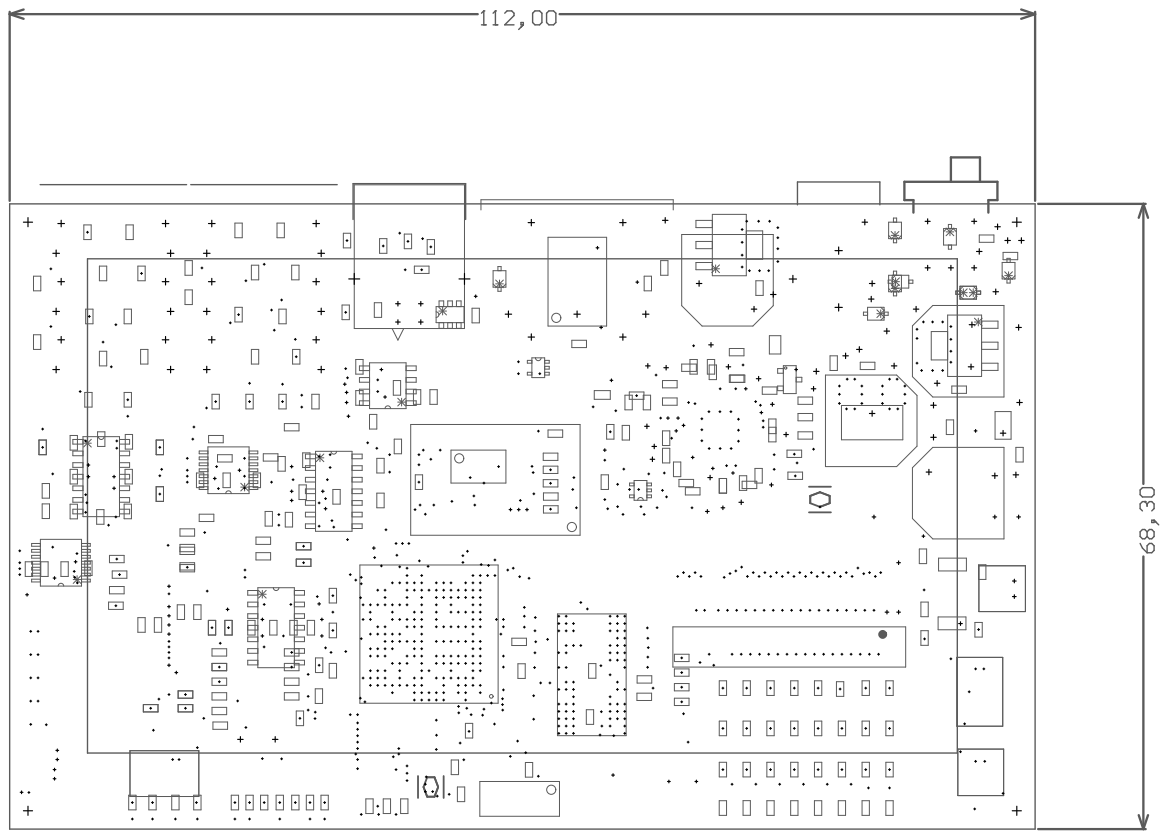
[picture p33: page 2]
