adjivas/electronic-levelup/Dossier de Fabrication/Schematics Prints.pdf

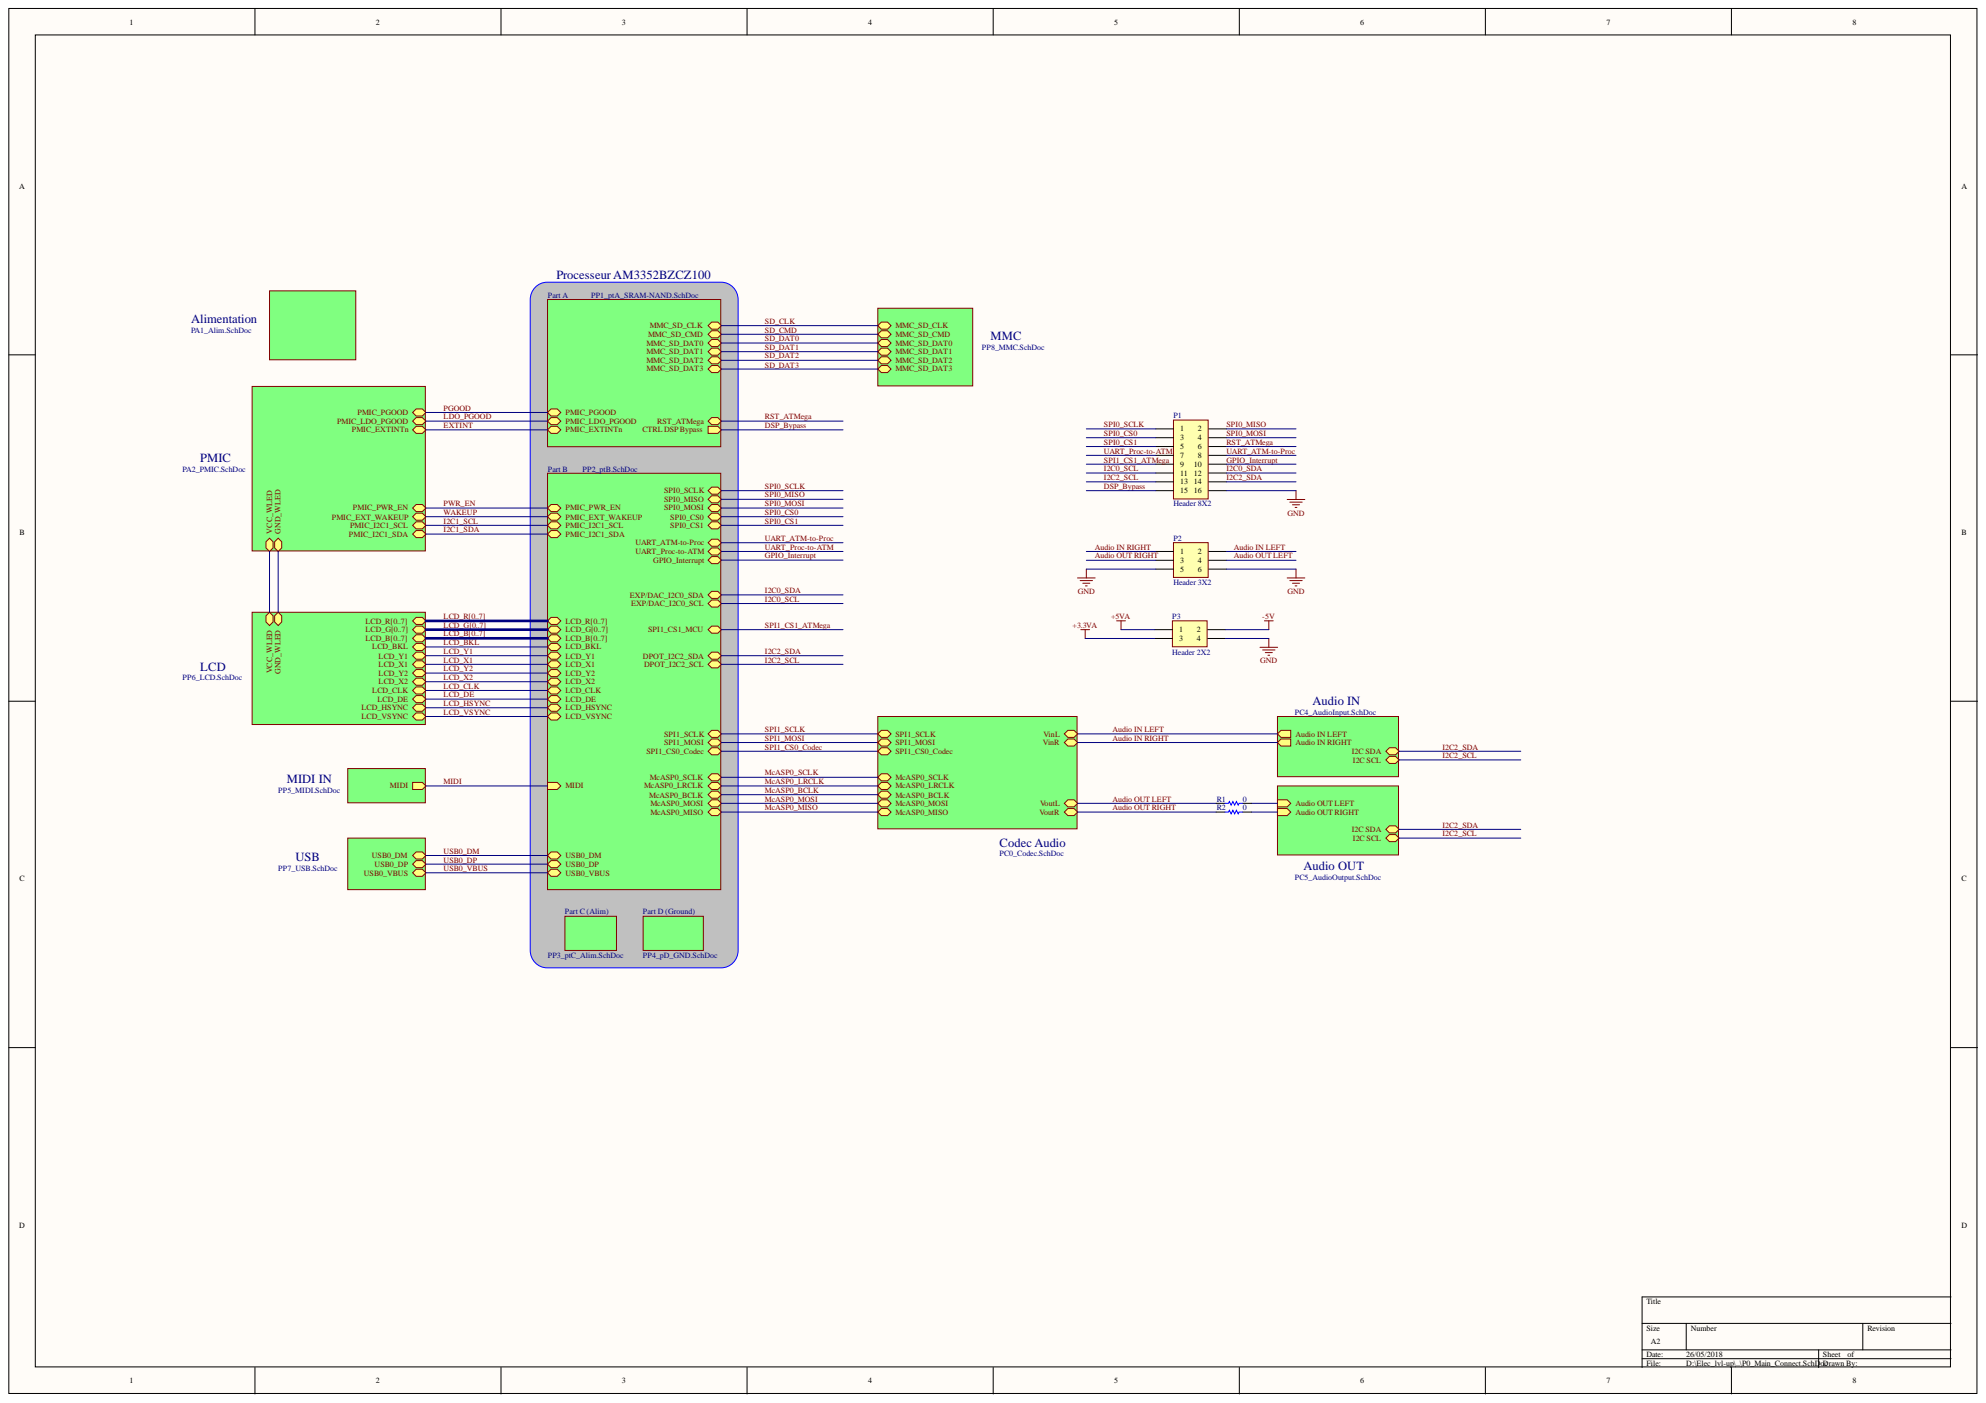
[picture p34: page 1]

VoutL VoutR VinL VinR

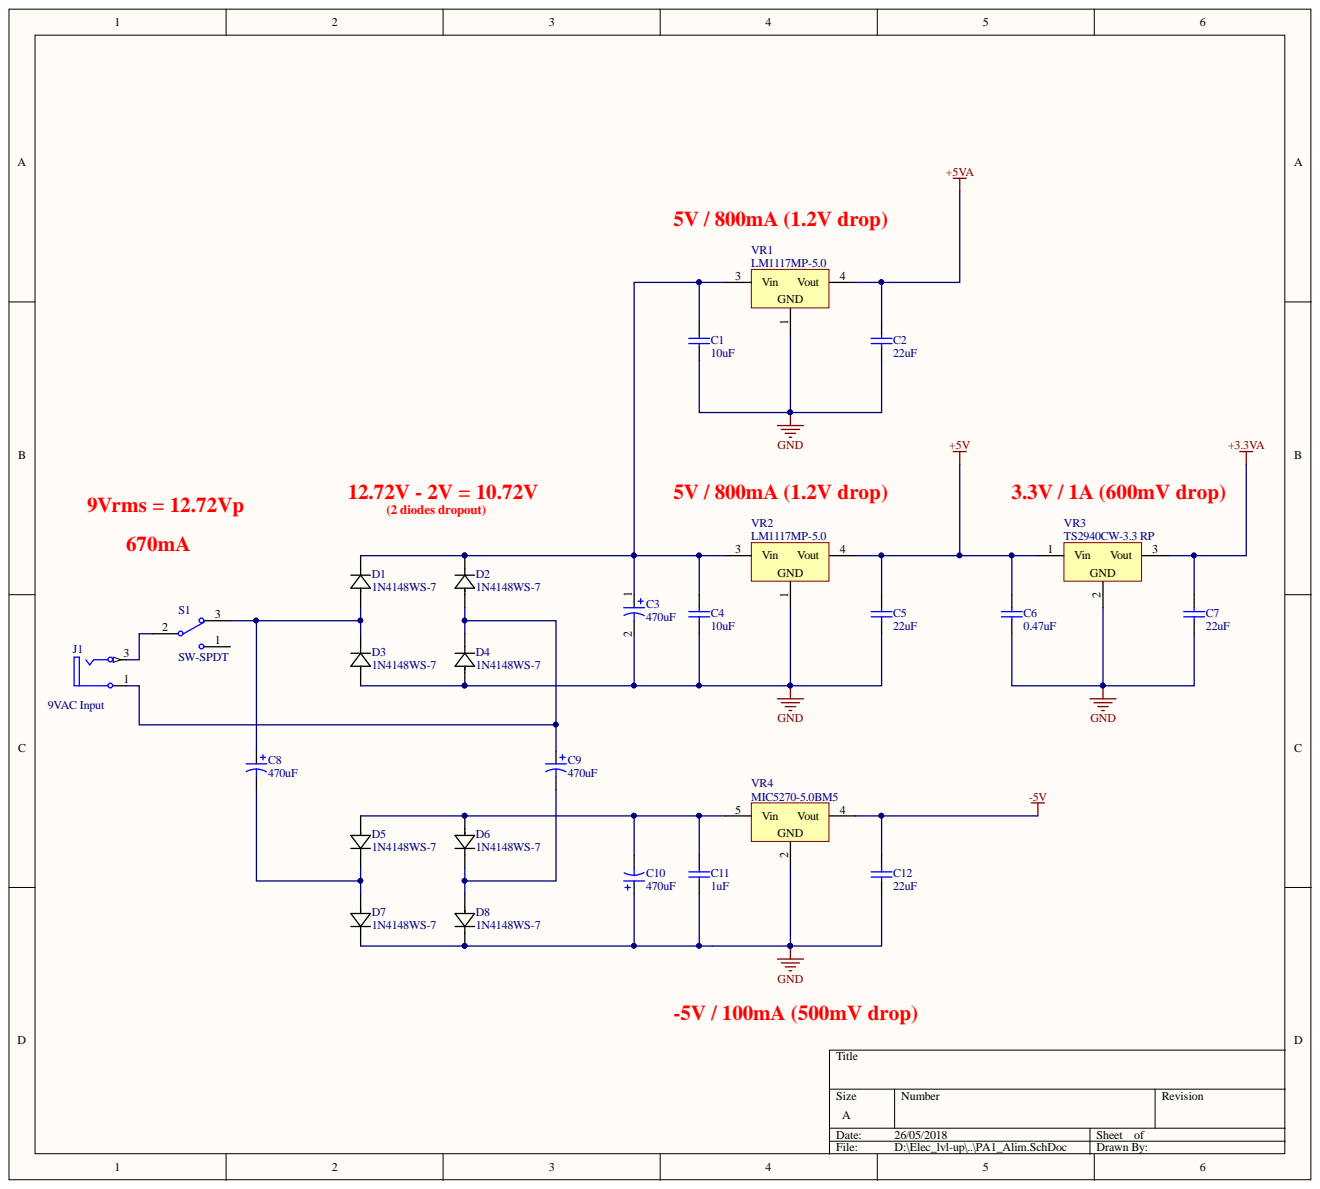
[picture p35: page 2]

Size A | Nu mber | Revisio n

Date: 6/0 5/2 8 | Sheet o f
File: D:\Elec_lvl-u p\..\PA1 _Alim.SchDo c | Drawn B y :

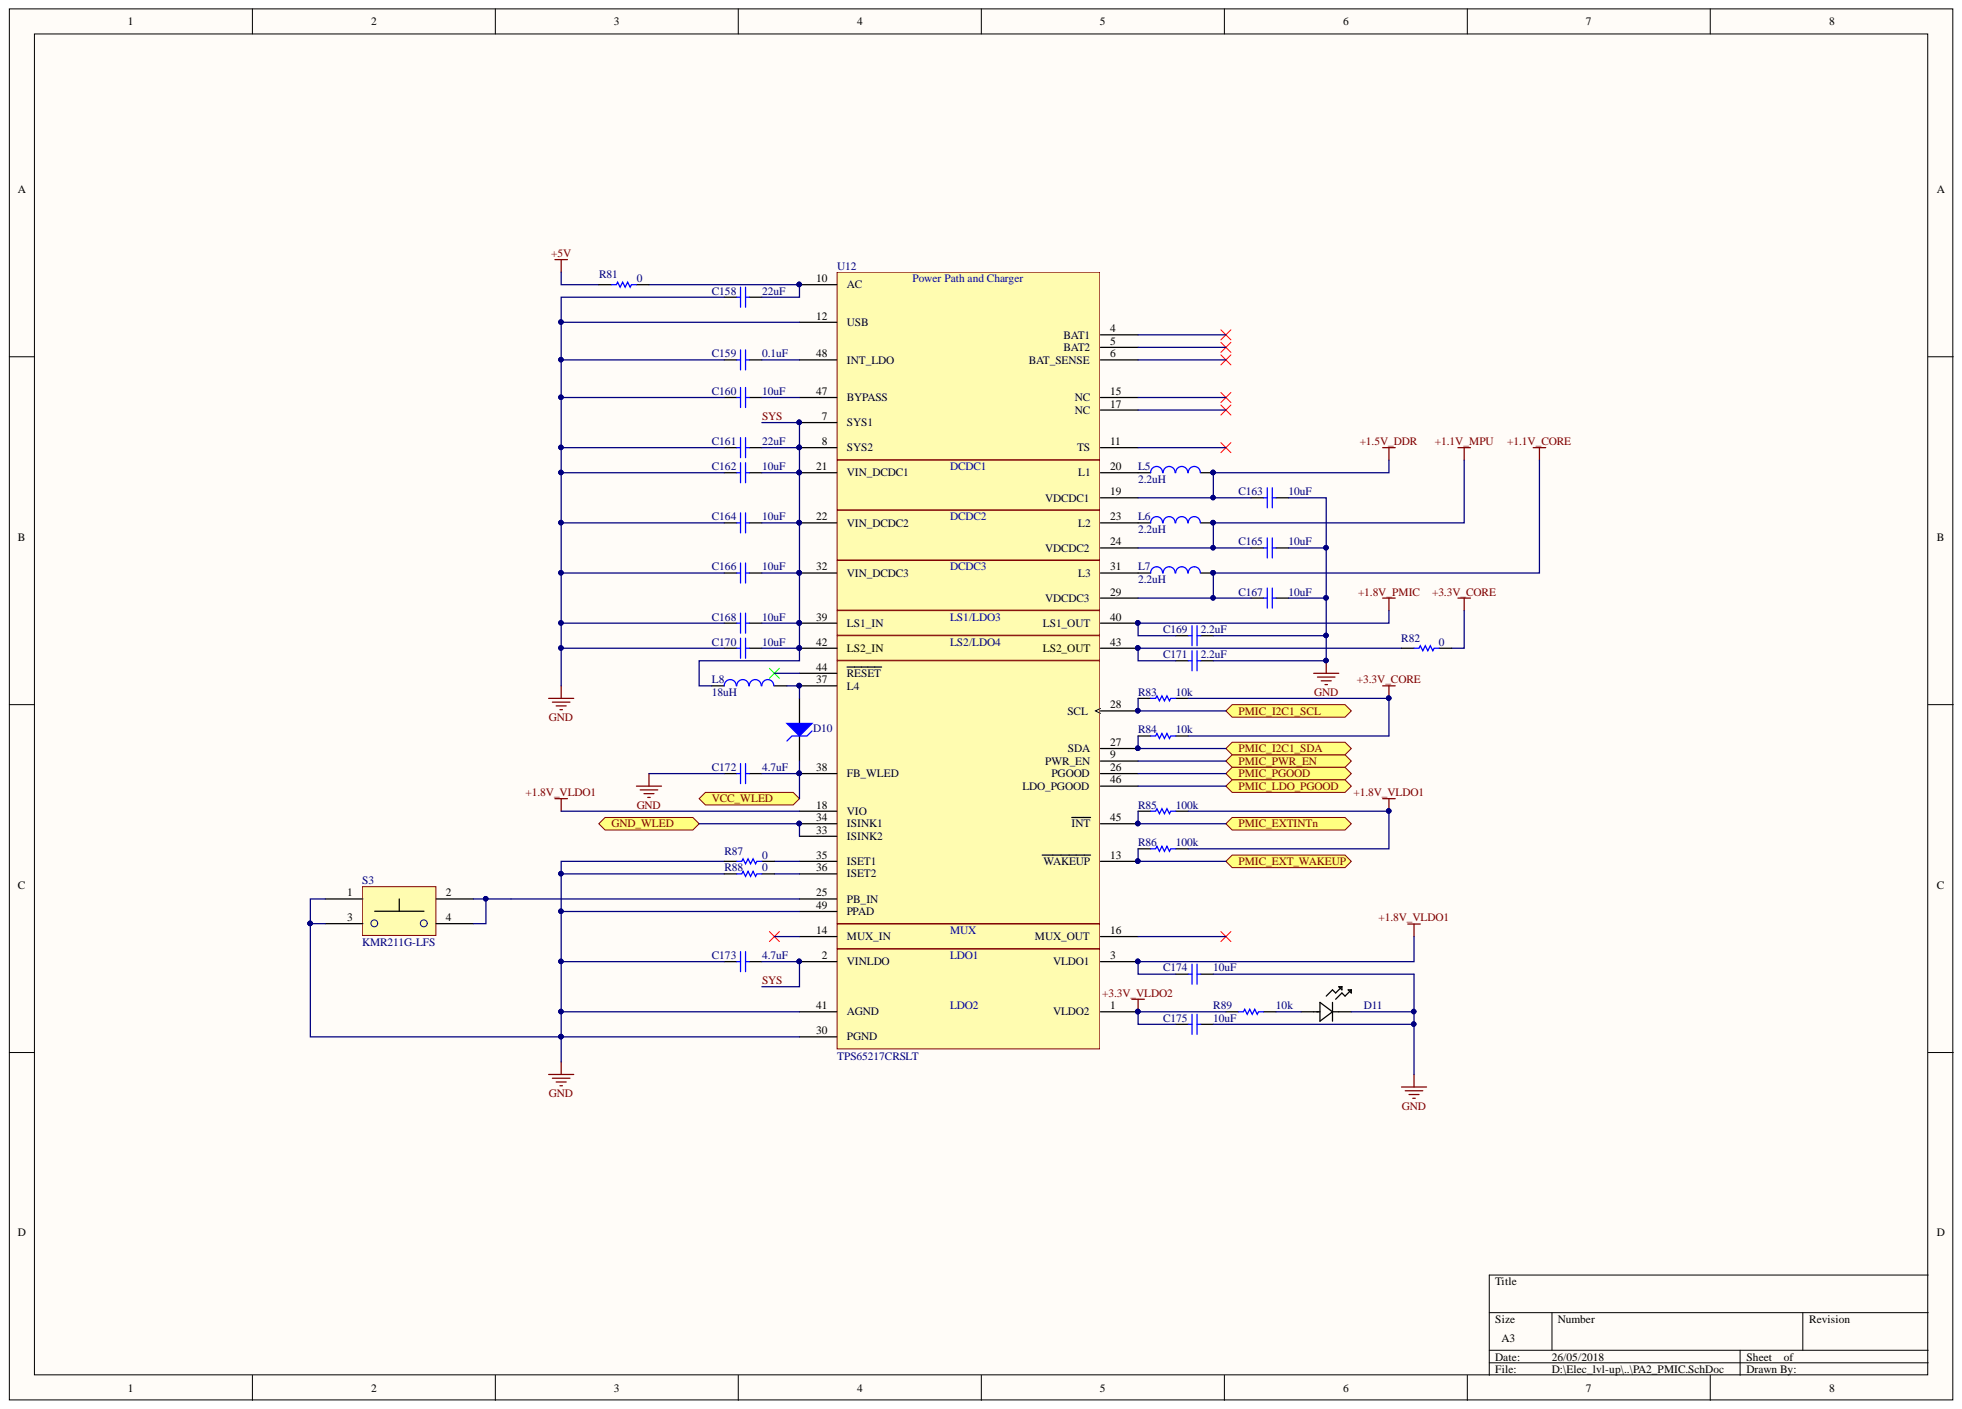
[picture p36: page 3]

Power Path and Charger

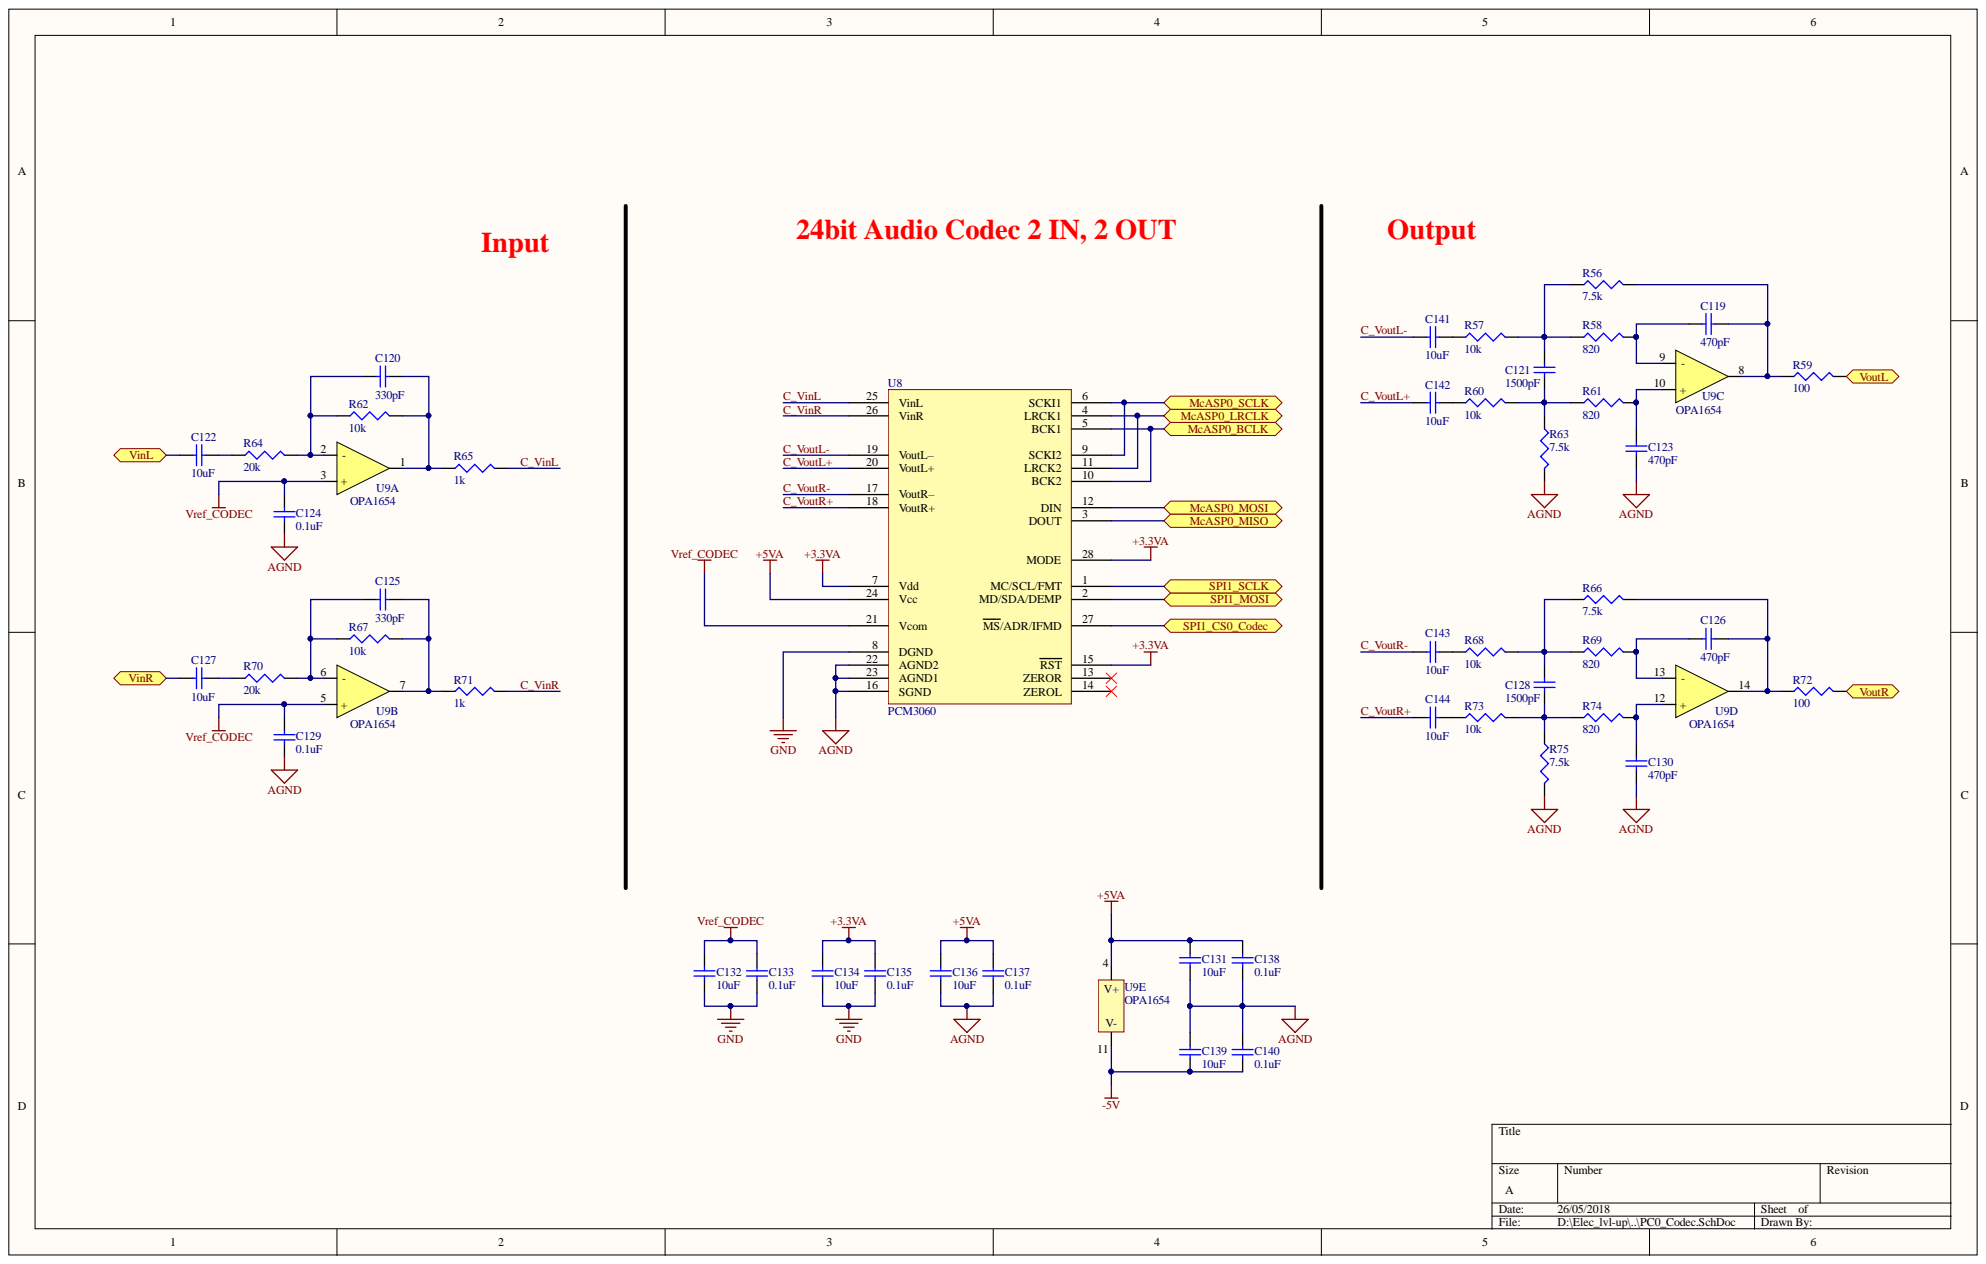
[picture p37: page 4]

AGND2 22

SGND 16

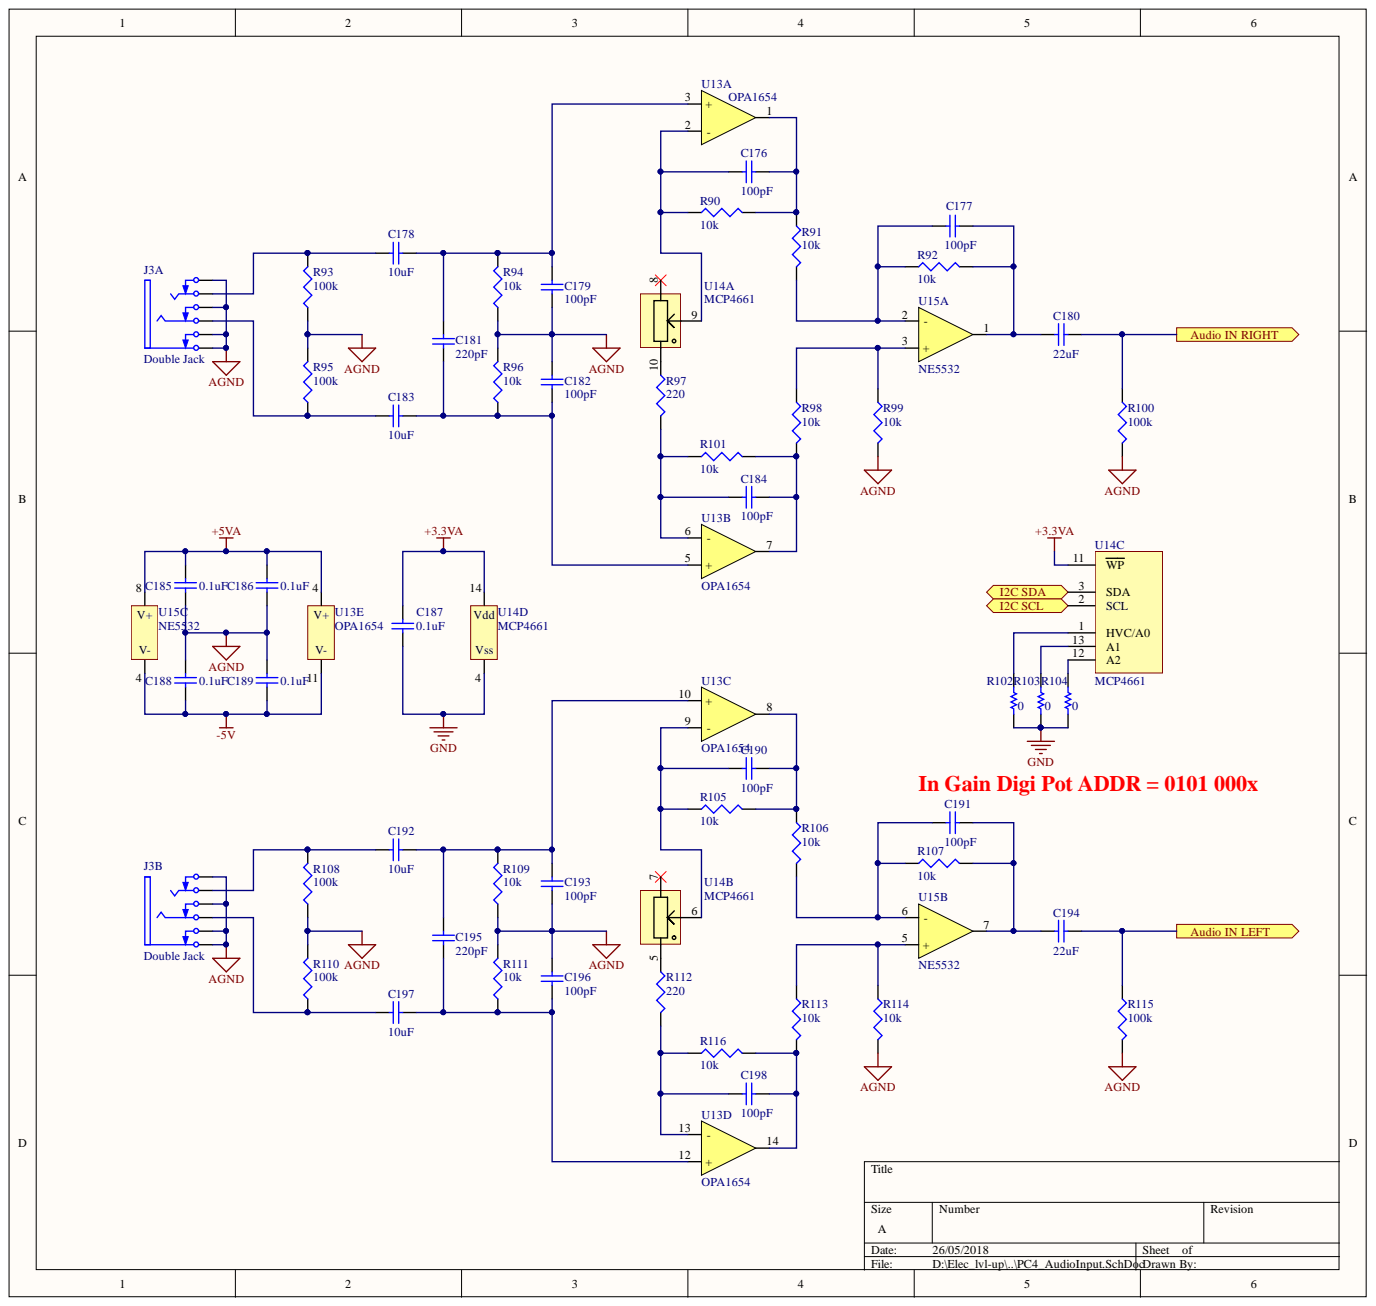
[picture p38: page 5]

U13A OPA1654

OPA1654
In Gain Digi Pot ADDR = 0101 000x R105

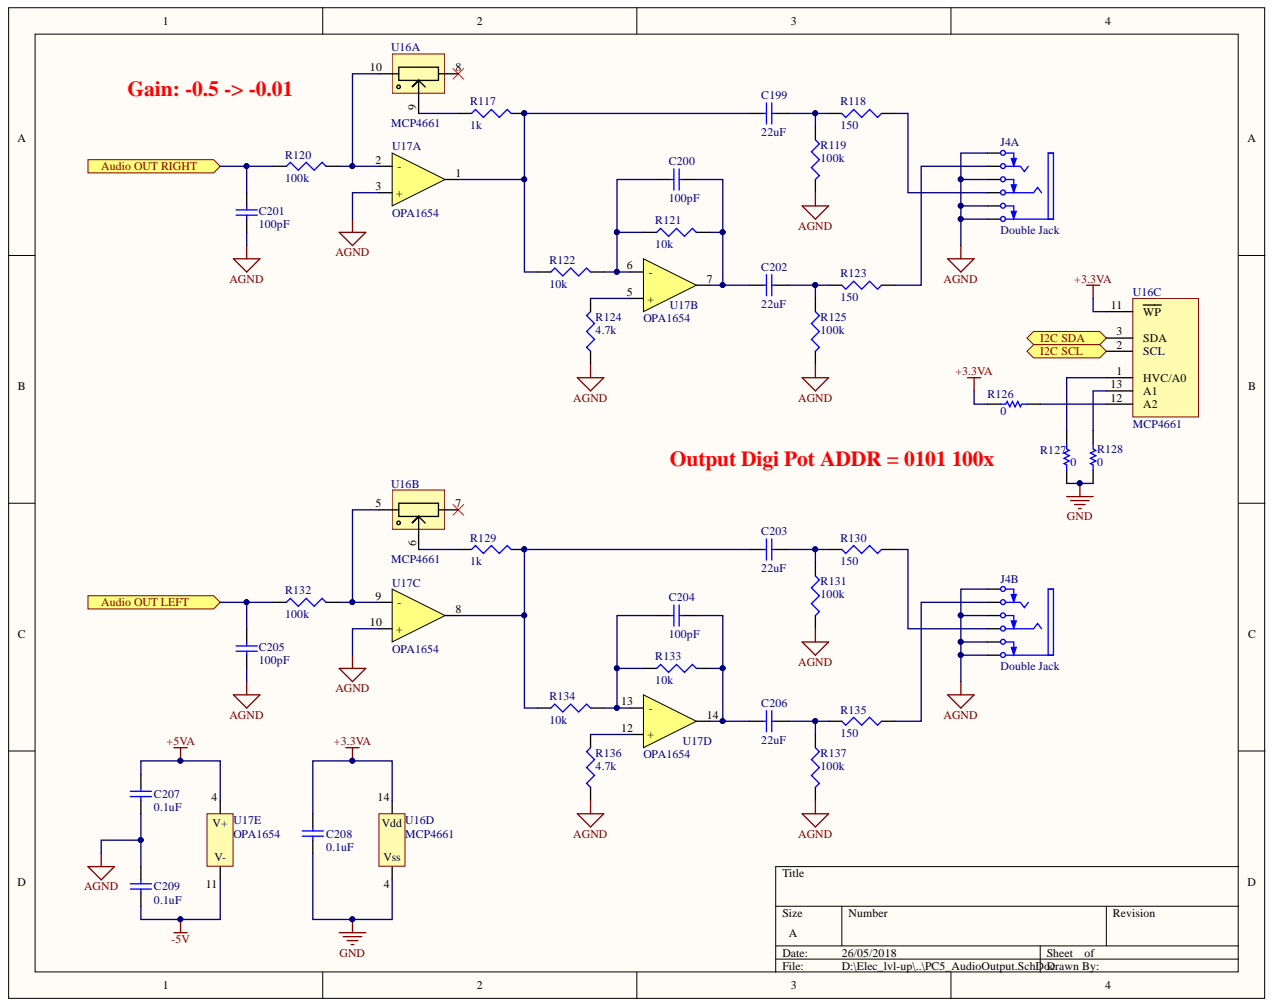
[picture p39: page 6]

A1 13
A2 12

Output Digi Pot ADDR = 0101 100x

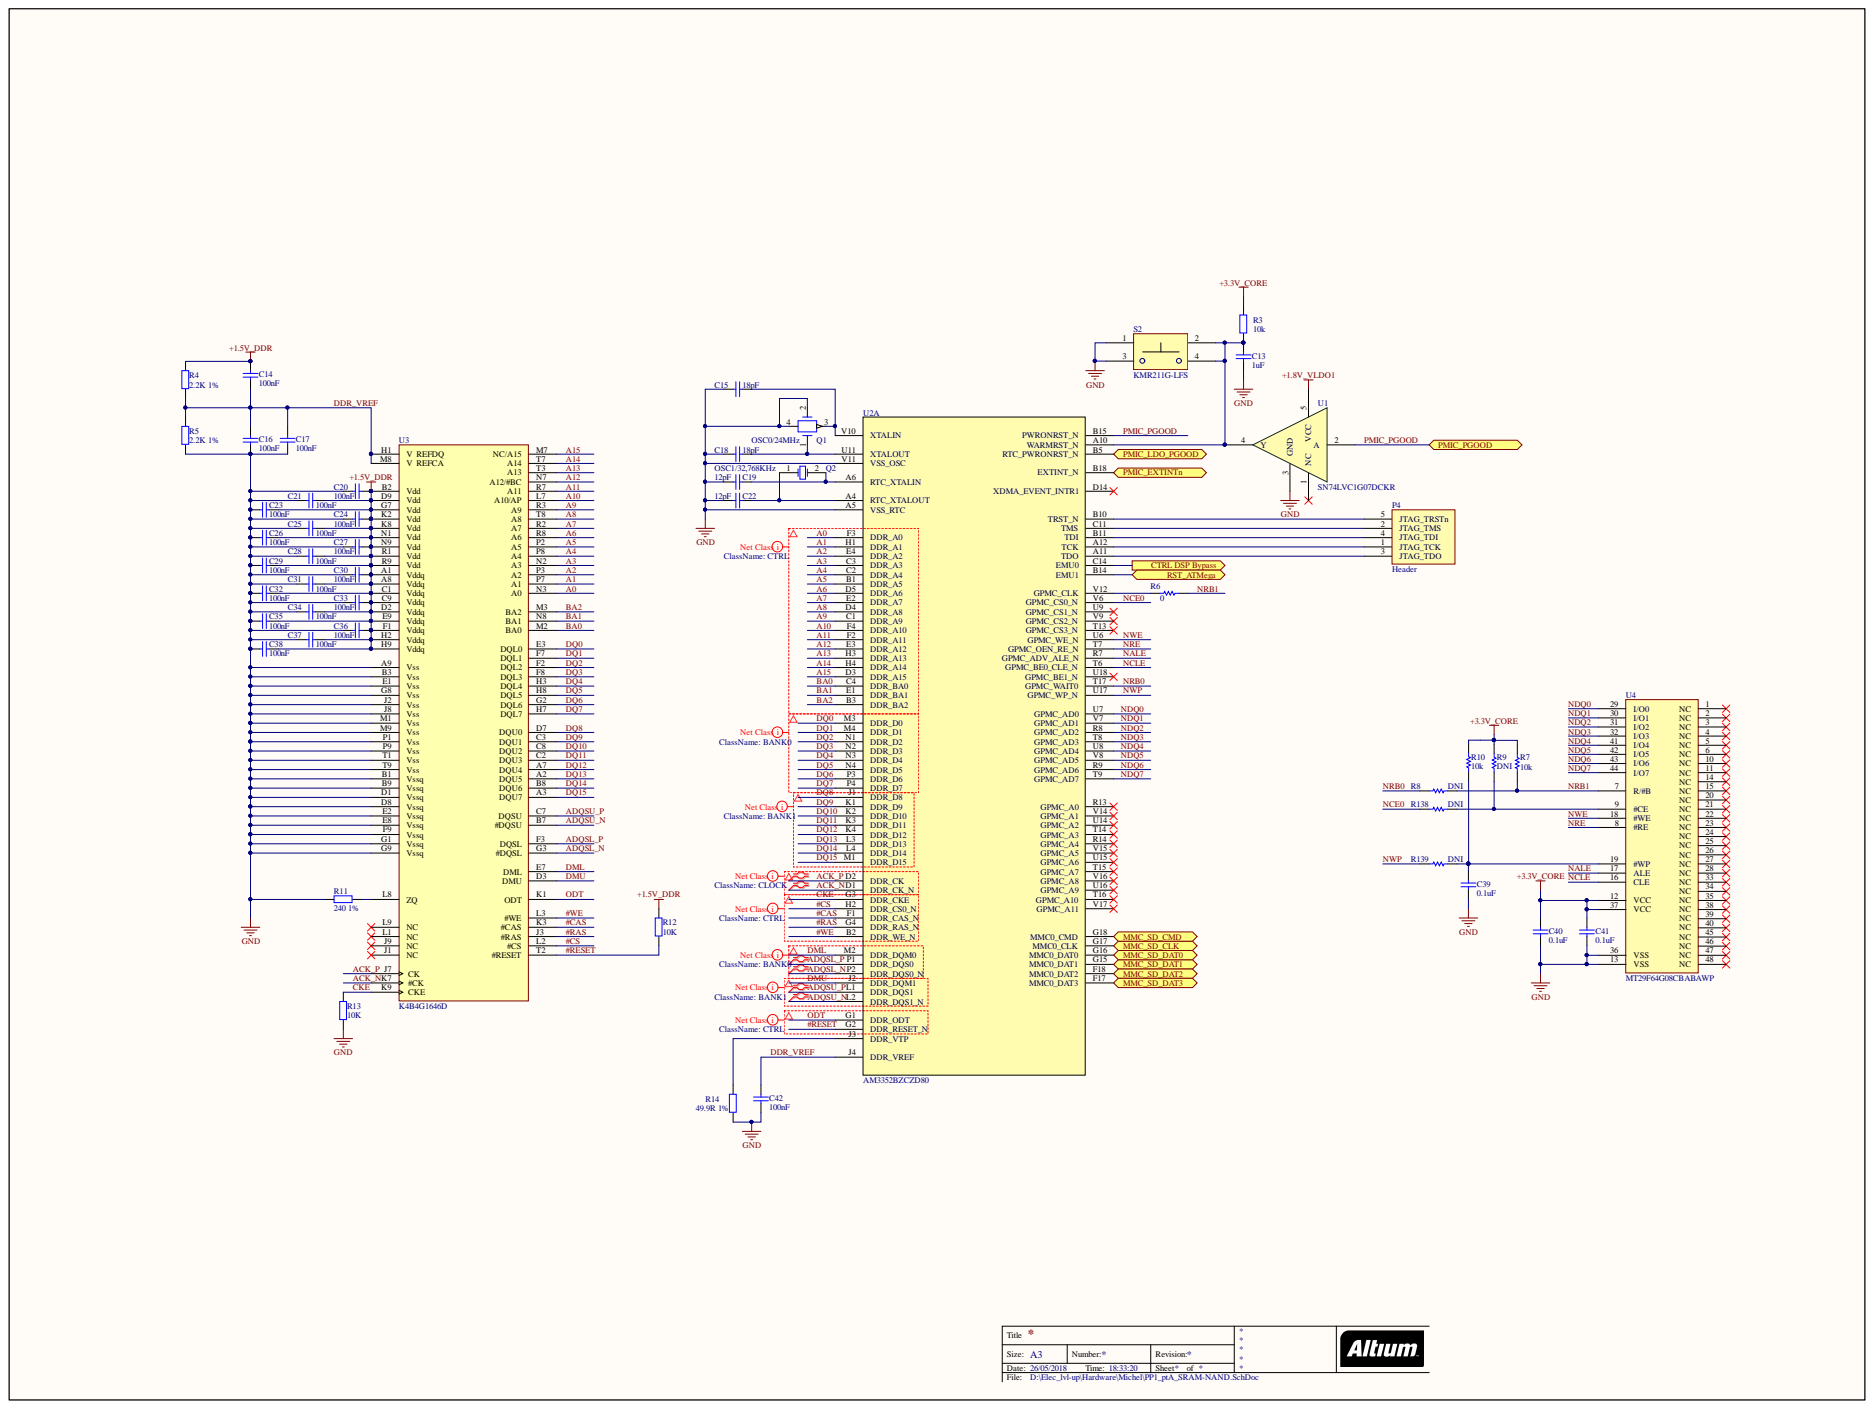
[picture p40: page 7]

NRB1 NALE NCLE NWE NRE

D DR_VRE F | J 3 J 4 | D DR_V T P D DR_VRE F

S i z e : A3 | N u mb er: * | Re v i s i o n : *
D a t e : 6/ / Ti me : : : | | S h e e t * o f *

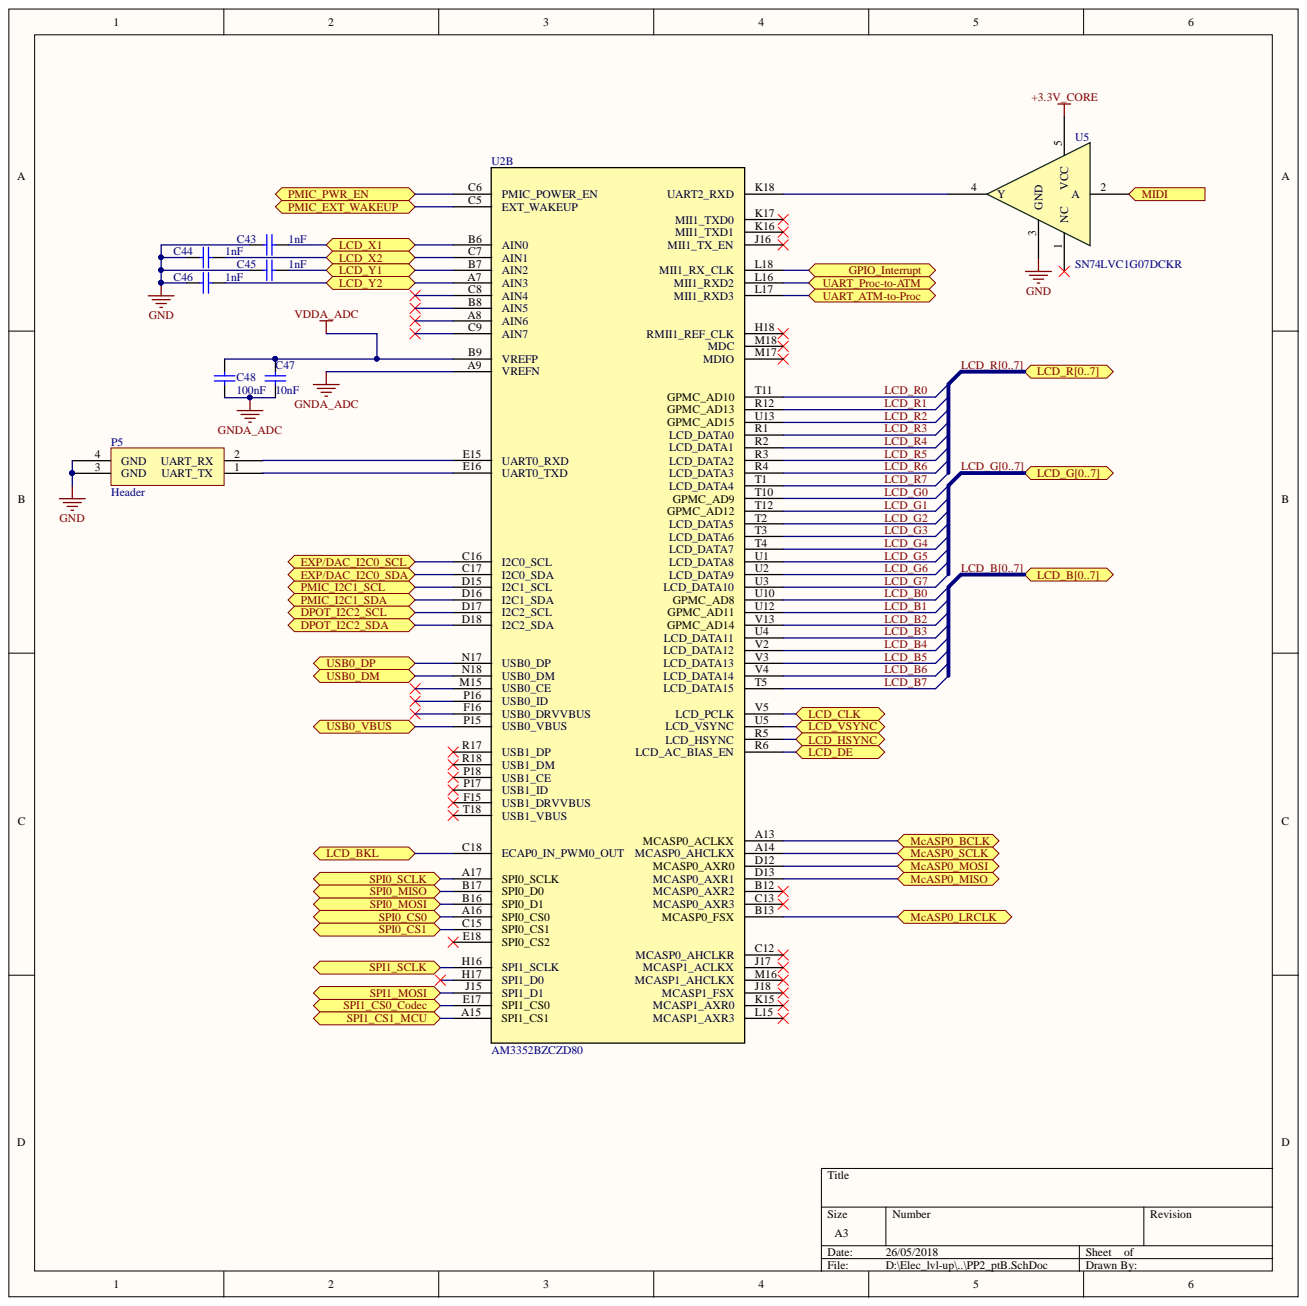
[picture p41: page 8]

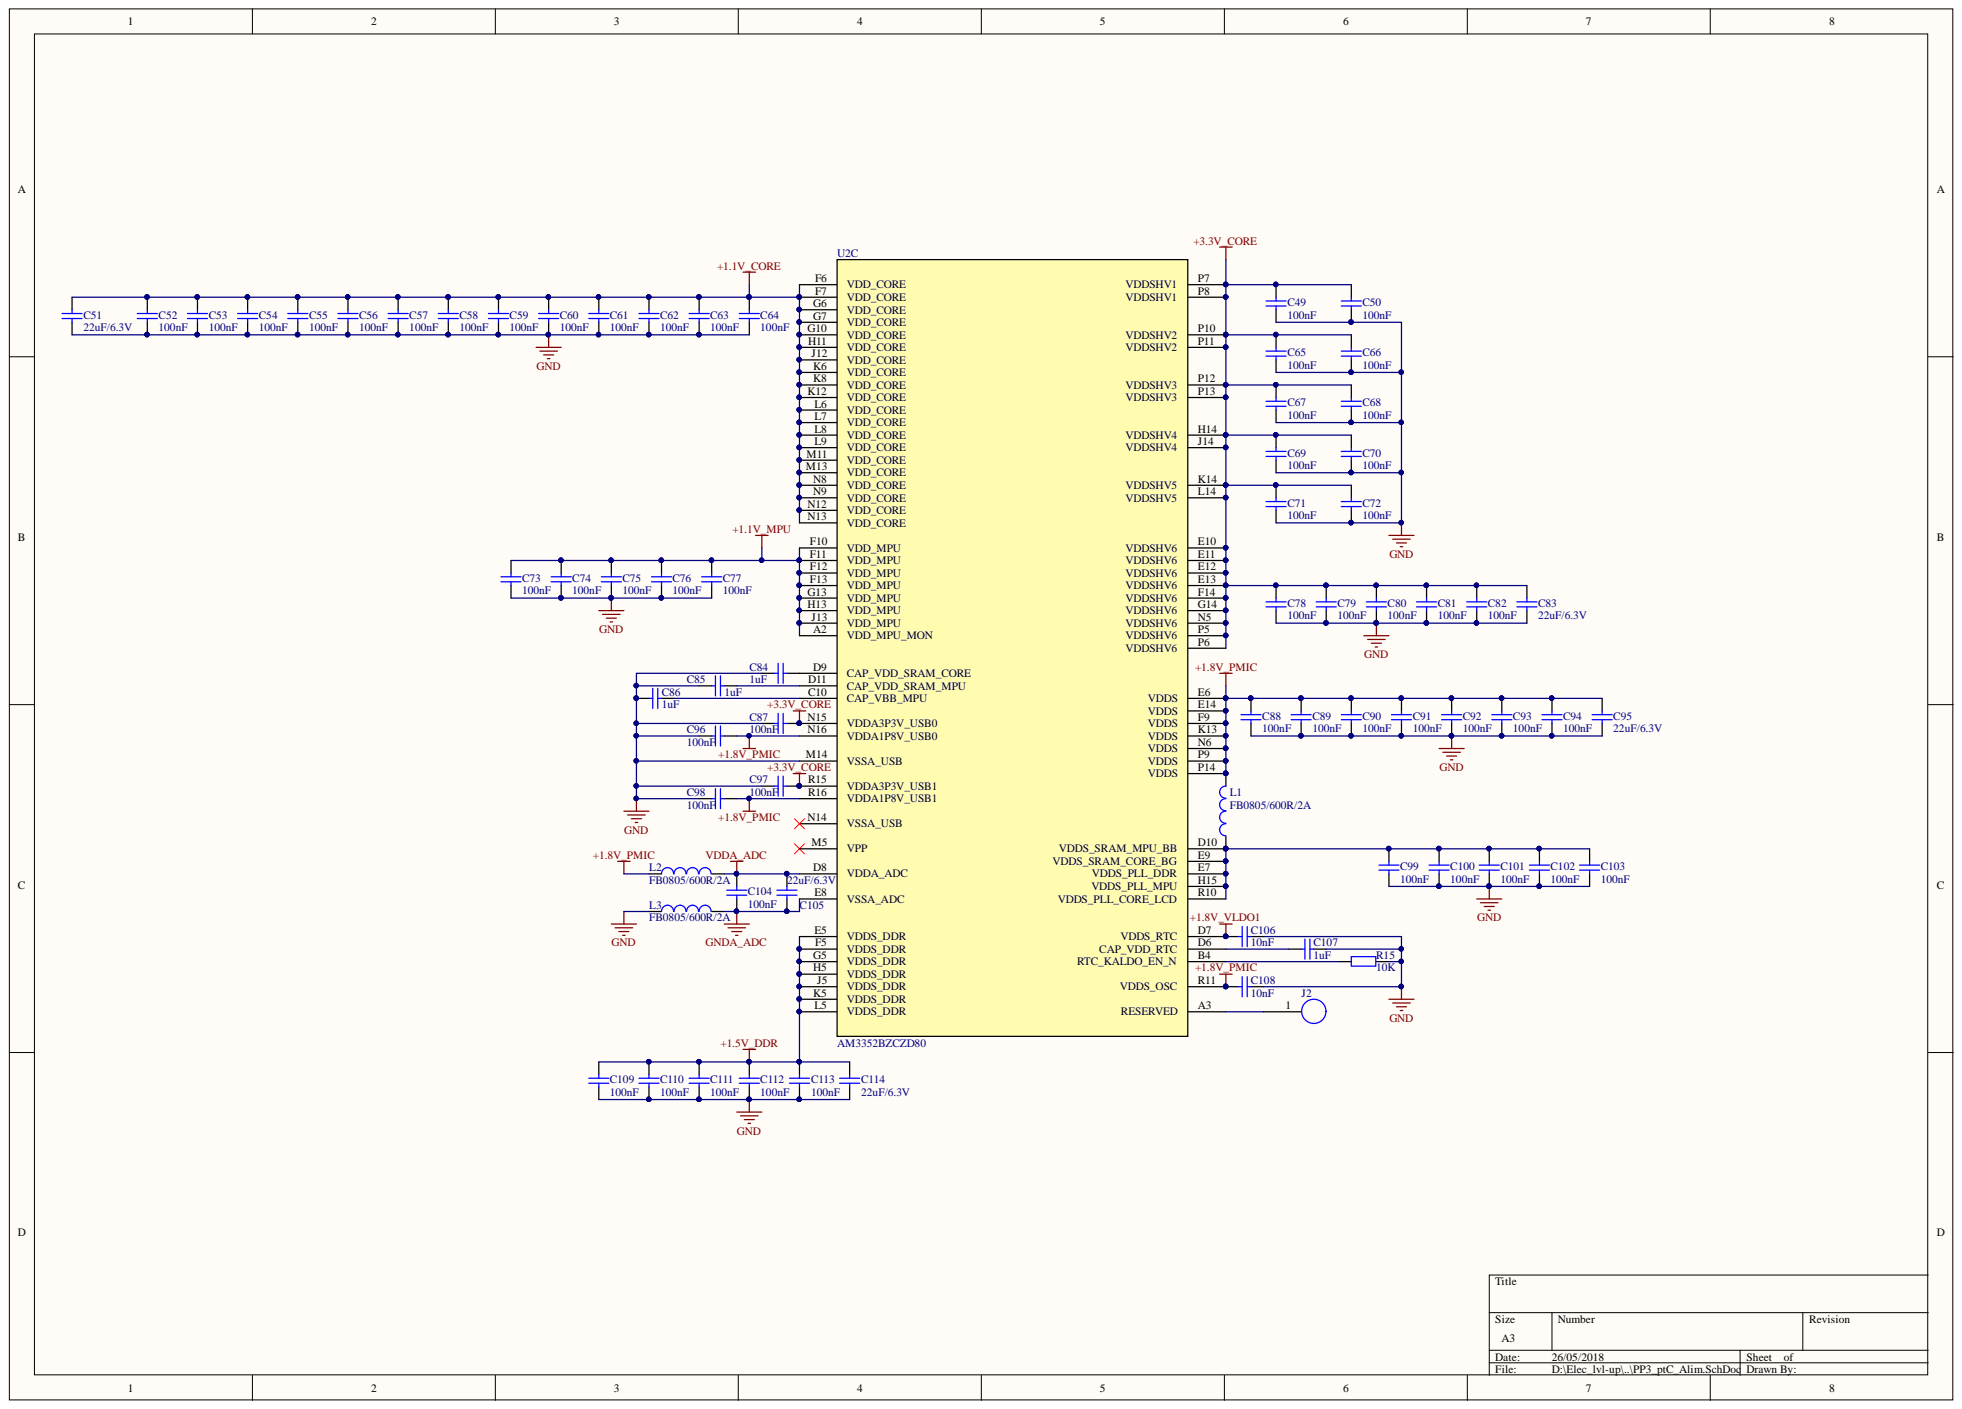
[picture p42: page 9]

K12 | | C67
L 6 | H14

L 9 | J14 | C69
M 1 1 | K14

N 9 | L14
N12 | E10

H13 | G14
J13 | N 5

C85 | 1uF | D 1 1
C86 | 1uF C10

G 5 | B 4
H 5 | +1.8V_PM C | 10K

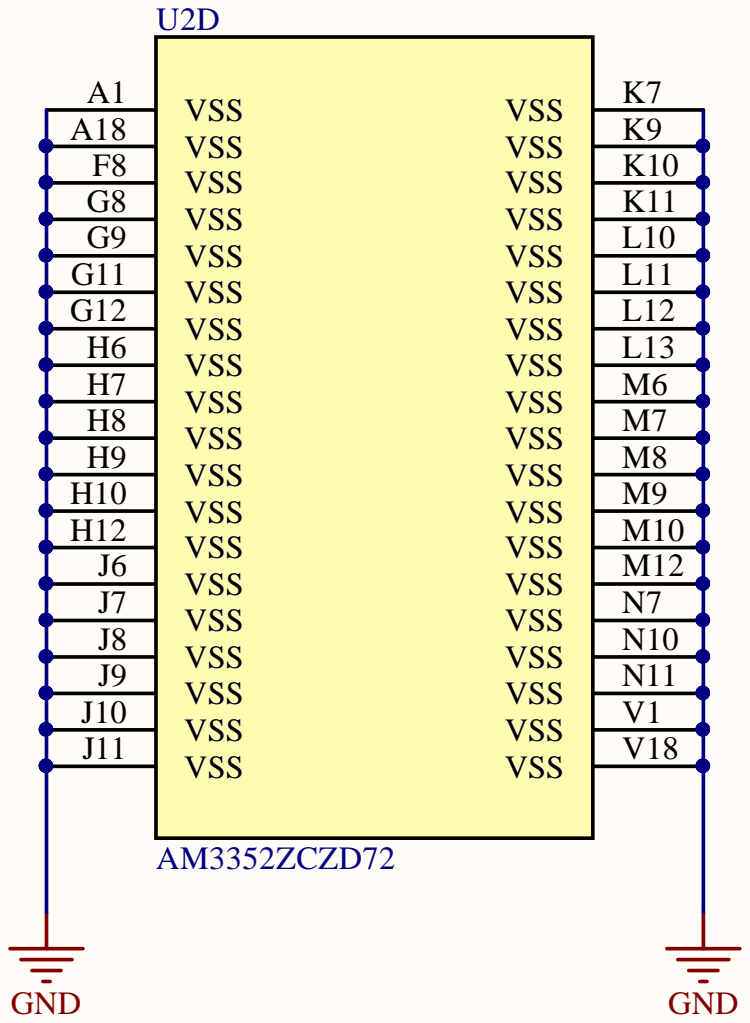
[picture p43: page 10]

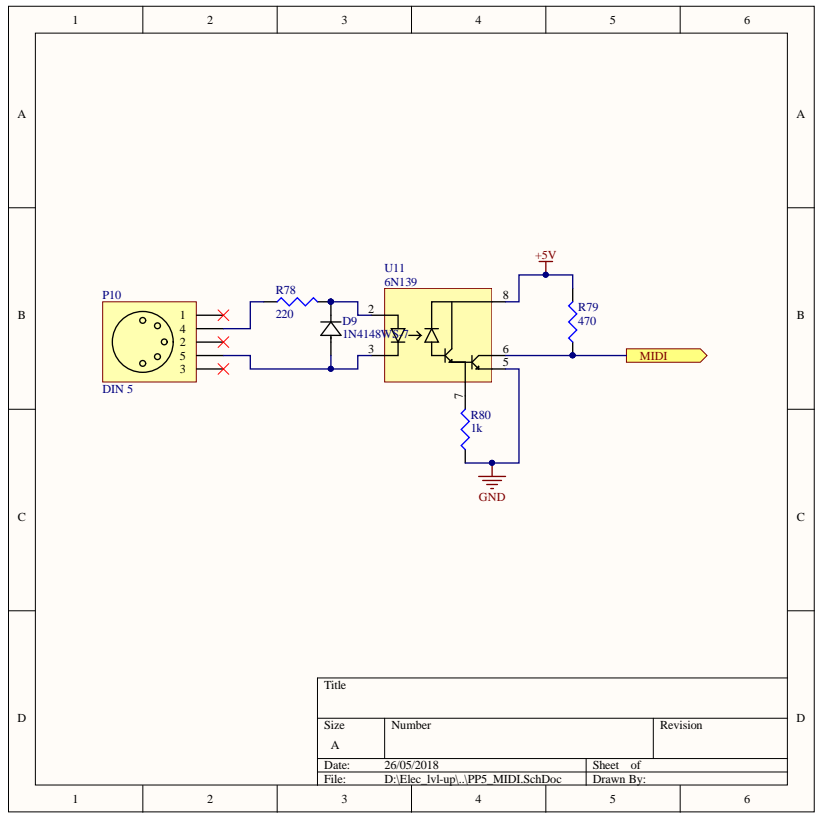
[picture p44: page 11]

A | e r | Re visio n

Date : 6/0 5/2 | S h e et o f
File : D:\Ele c _lvl-u p\..\P P _MIDI.S c hDo c | Drawn By :

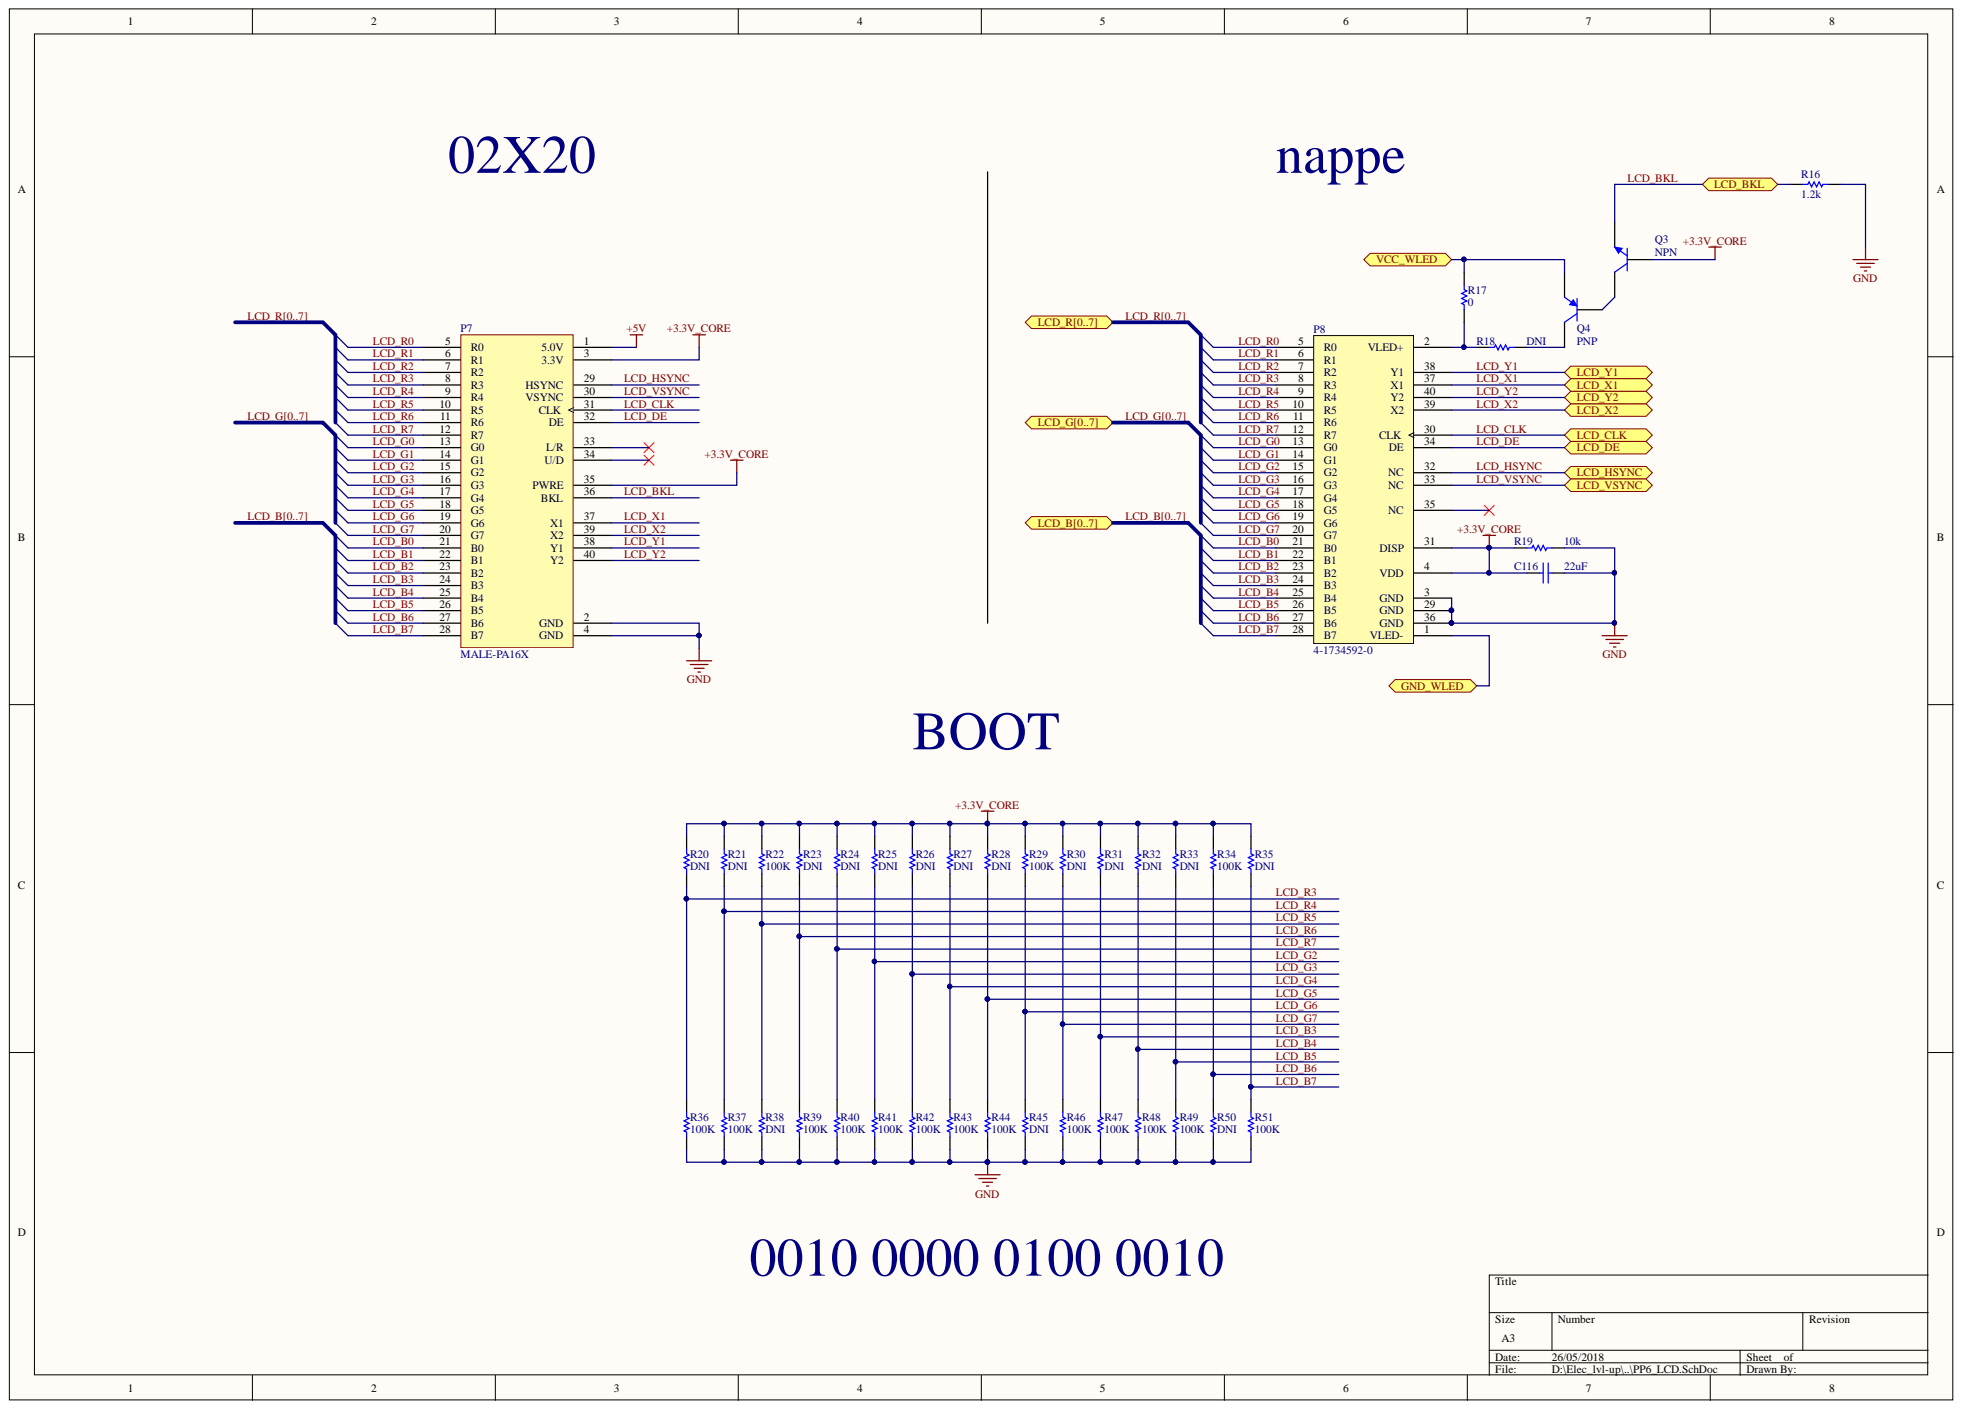
[picture p45: page 12]

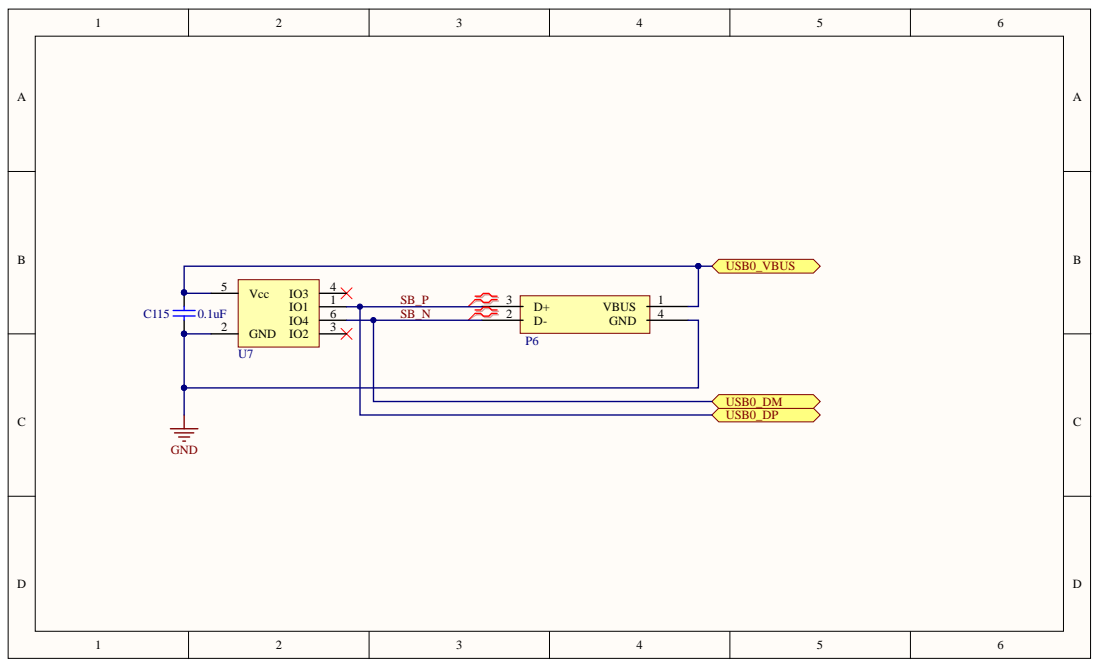
[picture p46: page 13]

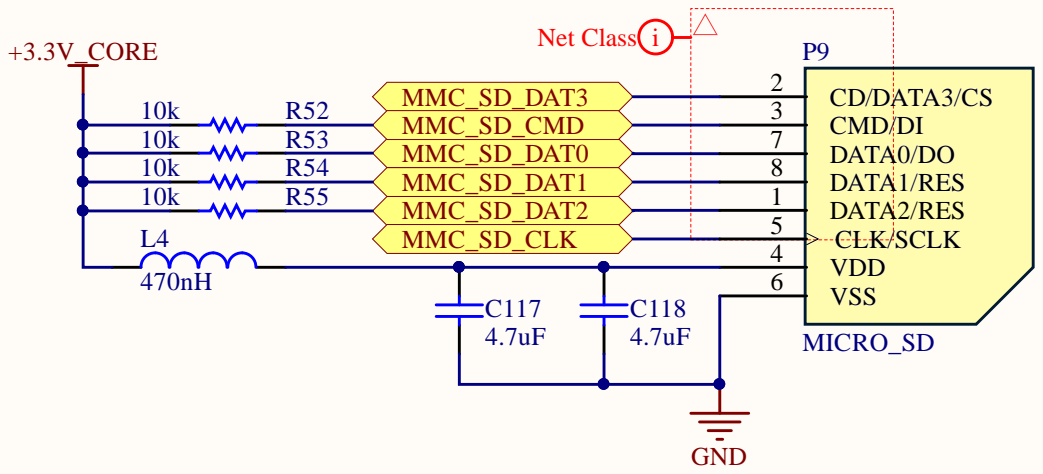
[picture p47: page 14]
