adjivas/electronic-levelup/(list of files, drawings)

Other design files:
CODEC_PCB_Project/Bonjour.PrjPcb
CODEC_PCB_Project/Bonjour.SchLib
CODEC_PCB_Project/PCBLib_Bonjour.PcbLib
CODEC_PCB_Project/Sh_ADC-DAC_Main.SchDoc
CODEC_PCB_Project/Sh_Alims.SchDoc
CODEC_PCB_Project/Sh_Connect.SchDoc
CODEC_PCB_Project/Sh_Controls.SchDoc
CODEC_PCB_Project/Sh_Headers.SchDoc
CODEC_PCB_Project/Sh_Inputs_Analog.SchDoc
CODEC_PCB_Project/Sh_Outputs_Analog.SchDoc
Filter_PCB_Project/Filter.PcbLib
Filter_PCB_Project/Filter.SchLib
Filter_PCB_Project/Filter_PCB_Project.PrjPcb
Filter_PCB_Project/P0_MASTER.SchDoc
Filter_PCB_Project/P1_Alim.SchDoc
Filter_PCB_Project/P2_AudioInput.SchDoc
Filter_PCB_Project/P3_MS.SchDoc
Filter_PCB_Project/P4_DSPBypass.SchDoc
Filter_PCB_Project/P5a_Filter1A.SchDoc
Filter_PCB_Project/P5b_Filter2A.SchDoc
Filter_PCB_Project/P5c_Filter1B.SchDoc
Filter_PCB_Project/P5d_Filter2B.SchDoc
Filter_PCB_Project/P6_FilterMode.SchDoc
Filter_PCB_Project/P7_FilterRoutingBypass.SchDoc
Filter_PCB_Project/P8_AudioOutput.SchDoc
Filter_PCB_Project/P9_MIDI.SchDoc
Filter_PCB_Project/P10_Expander.SchDoc
Filter_PCB_Project/PX_Header.SchDoc
Michel/Michel.PcbLib
Michel/Michel.PrjPcb
Michel/Michel.SchLib
Michel/P0_Main_Connect.SchDoc
Michel/PA1_Alim.SchDoc
Michel/PA2_PMIC.SchDoc
Michel/PC0_Codec.SchDoc
Michel/PC4_AudioInput.SchDoc
Michel/PC5_AudioOutput.SchDoc
Michel/PCB_adjivas.PcbDoc
Michel/PCB_Base_Méca.PcbDoc
Michel/PP1_ptA_SRAM-NAND.SchDoc
Michel/PP2_ptB.SchDoc
Michel/PP3_ptC_Alim.SchDoc
Michel/PP4_pD_GND.SchDoc
Michel/PP5_MIDI.SchDoc
Michel/PP6_LCD.SchDoc
Michel/PP7_USB.SchDoc
Michel/PP8_MMC.SchDoc
Michel/PX_Header.SchDoc
Michel_PcbLib.PcbLib
Michel_SchLib.SchLib
ProcRamLcd_PCB_Project/DDR3.SchDoc
ProcRamLcd_PCB_Project/LCD.SchDoc
ProcRamLcd_PCB_Project/ProcRamLcd_Project.PrjPcb
