adjivas/electronic-levelup/(commit log)

2018-02-17 je suis ton sauveur
    [Bonjour.PrjPcb, Bonjour.SchLib, Michel.PcbLib, Michel.SchLib, PCBLib_Bonjour.PcbLib, PCB_Bonjour.PcbDoc, Sh_ADC-DAC_Main.SchDoc, Sh_Controls.SchDoc]
2018-02-18 add ddr3
    [DDR3.SchDoc, Michel.SchLib, Michel_Project.PrjPcb]
2018-02-22 OK Sheet_Connect + Condensateurs de découplage
    Il faut que je fixe les warnings débiles et ensuite je route.
    [Bonjour.PrjPcb, Bonjour.SchLib, PCBLib_Bonjour.PcbLib, Sh_ADC-DAC_Main.SchDoc, Sh_Alims.SchDoc, Sh_Connect.SchDoc, Sh_Controls.SchDoc, Sh_Headers.SchDoc]
2018-02-24 creation pcb et stack up
    [DDR3.SchDoc, LCD.SchDoc, Michel.PcbLib, Michel_Project.PrjPcb, PCB1.PcbDoc]
2018-02-27 Clean de la branche : chaqun son dossier, chaqun son projet (jusqu'a la mise en commun)
    [Bonjour.PrjPcb, Bonjour.SchLib, DDR3.SchDoc, LCD.SchDoc, Michel_PcbLib.PcbLib, Michel_Project.PrjPcb, Michel_SchLib.SchLib, PCB1.PcbDoc]
2018-02-27 "merge" filter et rename des projets
    projet Bonjour ...... ya pu rien a faire, le patient est ded
    [Filter.PcbLib, Filter.SchLib, Filter_PCB_Project.PrjPcb, P0_MASTER.SchDoc, P10_Expander.SchDoc, P1_Alim.SchDoc, P2_AudioInput.SchDoc, P3_MS.SchDoc]
2018-03-11 Archives + Michel SchLib Ultime
    [Bonjour.PrjPcb, Bonjour.SchLib, DDR3.SchDoc, Filter.PcbLib, Filter.SchLib, Filter_PCB_Project.PrjPcb, LCD.SchDoc, Michel.PrjPcb]
2018-03-12 Import Schematics de MotherB & Codec
    [BOOT.SchDoc, LCD.SchDoc, MMC.SchDoc, Michel.PrjPcb, Michel.SchLib, PMIC.SchDoc, PROC_partA_(SRAM,NAND,LCD).SchDoc, PROC_partB_(LCD).SchDoc]
2018-03-12 Add Sheet Connect
    [Michel.PrjPcb, PROC_partB_(LCD).SchDoc, Sheet_Connect.SchDoc]
2018-03-13 Add Filtres
    [Michel.PrjPcb, P0_MASTER.SchDoc, P10_Expander.SchDoc, P1_Alim.SchDoc, P2_AudioInput.SchDoc, P3_MS.SchDoc, P4_DSPBypass.SchDoc, P5a_Filter1A.SchDoc]
2018-03-13 Update SchLibrary avec Filtres
    [Michel.SchLib]
2018-03-13 LibMichel remove doublon SN74LVC1G07DCKR_1 -> SN74LVC1G07DCKR
    [Michel.SchLib]
2018-03-13 fixe DATA3/MMC to U18
    [PROC_partA_(SRAM,NAND,LCD).SchDoc]
2018-03-13 Remove EMU 0&1 pins according to PinMux
    [PROC_partA_(SRAM,NAND,LCD).SchDoc]
2018-03-13 link GPMC_WP_N between NAND and AM335X
    [PROC_partA_(SRAM,NAND,LCD).SchDoc]
2018-03-13 Renommer les fichiers, add No ERC PF2-8-9
    [Michel.PrjPcb, P0_Main_Connect.SchDoc, PC1_Codec.SchDoc, PC2_Input.SchDoc, PC3_Output.SchDoc, PF10_Expander.SchDoc, PF1_Alim.SchDoc, PF2_AudioInput.SchDoc]
2018-03-13 fixe MMC Capa pull down
    [PP8_MMC.SchDoc]
2018-03-13 change SD pins order
    [Michel.SchLib]
2018-03-13 Update Master_Connect & Annotate
    [Michel.PrjPcb, Michel.SchLib, P0_Main_Connect.SchDoc, PC1_Codec.SchDoc, PC2_Input.SchDoc, PC3_Output.SchDoc, PF10_Expander.SchDoc, PF1_Alim.SchDoc]
2018-03-13 Update Power Ports
    [Michel.SchLib, P0_Main_Connect.SchDoc, PC1_Codec.SchDoc, PC2_Input.SchDoc, PC3_Output.SchDoc, PF10_Expander.SchDoc, PF1_Alim.SchDoc, PF2_AudioInput.SchDoc]
2018-03-13 Fix pin electrical type errors
    [Michel.SchLib, P0_Main_Connect.SchDoc, PP1_ptA_SRAM-NAND.SchDoc, PP2_ptB.SchDoc, PP6_LCD.SchDoc, PX_Header.SchDoc]
2018-03-14 recenter component PartB
    [PP2_ptB.SchDoc]
2018-03-14 Update pins, Remove PFX_Headers
    [Michel.SchLib, P0_Main_Connect.SchDoc, PF10_Expander.SchDoc, PF2_AudioInput.SchDoc, PF8_AudioOutput.SchDoc, PF9_MIDI.SchDoc, PP2_ptB.SchDoc, PP7_USB.SchDoc]
2018-03-14 Add Codec SPI, Fix Ctrl_dsp_bypass
    [Michel.PrjPcb, Michel.SchLib, P0_Main_Connect.SchDoc, PC1_Codec.SchDoc, PP1_ptA_SRAM-NAND.SchDoc, PP2_ptB.SchDoc, PX_PMIC.SchDoc]
2018-03-14 Fix all errors except Boot_PSP
    [Michel.SchLib, P0_Main_Connect.SchDoc, PP1_ptA_SRAM-NAND.SchDoc, PP2_ptB.SchDoc, PP6_LCD.SchDoc, PX_PMIC.SchDoc]
2018-03-14 Codec pin SCKL
    [P0_Main_Connect.SchDoc, PC1_Codec.SchDoc, PP1_ptA_SRAM-NAND.SchDoc, PP2_ptB.SchDoc]
2018-03-14 Fix Bus Problems
    [Michel.SchLib, PP1_ptA_SRAM-NAND.SchDoc]
2018-03-14 fix error ddr3
    [PP1_ptA_SRAM-NAND.SchDoc]
2018-03-15 fixe BOOT_PSP compilation and reset OSC{0,1} references
    [P0_Main_Connect.SchDoc, PP1_ptA_SRAM-NAND.SchDoc]
2018-03-16 add 0/Ohm resistances for PMIC output 3.3V ; reduce number of compilation errors
    [Michel.PrjPcb, Michel.SchLib, P0_Main_Connect.SchDoc, PC1_Codec.SchDoc, PC2_Input.SchDoc, PC3_Output.SchDoc, PF10_Expander.SchDoc, PF1_Alim.SchDoc]
2018-03-16 fixe USB (cc @limacoNOOB) ; source components
    [Michel.SchLib, P0_Main_Connect.SchDoc, PC1_Codec.SchDoc, PC2_Input.SchDoc, PC3_Output.SchDoc, PF10_Expander.SchDoc, PF1_Alim.SchDoc, PF2_AudioInput.SchDoc]
2018-03-16 corr value comp
    [PP3_ptC_Alim.SchDoc]
2018-03-17 Essai à corriger les erreurs
    [Michel.PrjPcb, Michel.SchLib, P0_Main_Connect.SchDoc, PC1_Codec.SchDoc, PC2_Input.SchDoc, PC3_Output.SchDoc, PF10_Expander.SchDoc, PF1_Alim.SchDoc]
2018-03-17 Restore PtA
    [PP1_ptA_SRAM-NAND.SchDoc]
2018-03-17 value of resistance and condo
    [PP1_ptA_SRAM-NAND.SchDoc]
2018-03-18 change USB reference
    [Michel.SchLib, PP7_USB.SchDoc]
2018-03-19 Add Quad DAC pour le Cutoff
    [Michel.PrjPcb, Michel.SchLib, P0_Main_Connect.SchDoc, PC4_DAC_Cutoff.SchDoc, PF9_MIDI.SchDoc, PP2_ptB.SchDoc]
2018-03-19 remove repeat boot, move boot to LCD sheet
    [Michel.PrjPcb, P0_Main_Connect.SchDoc, PC1_Codec.SchDoc, PC2_Input.SchDoc, PC3_Output.SchDoc, PC4_DAC_Cutoff.SchDoc, PF10_Expander.SchDoc, PF1_Alim.SchDoc]
2018-03-20 add LED
    [Michel.PrjPcb, P0_Main_Connect.SchDoc, PC1_Codec.SchDoc, PC2_Input.SchDoc, PC3_Output.SchDoc, PC4_DAC_Cutoff.SchDoc, PF10_Expander.SchDoc, PF1_Alim.SchDoc]
2018-03-20 add PMIC button
    [Michel.PrjPcb, PC1_Codec.SchDoc, PC2_Input.SchDoc, PC3_Output.SchDoc, PC4_DAC_Cutoff.SchDoc, PF10_Expander.SchDoc, PF1_Alim.SchDoc, PF2_AudioInput.SchDoc]
2018-03-20 Restore +3.3V Transfo sur PF1_Alim
    [PC4_DAC_Cutoff.SchDoc, PF1_Alim.SchDoc]
2018-03-20 maj ddr3
    [PP1_ptA_SRAM-NAND.SchDoc]
2018-03-20 Update All Power Ports
    [Michel.PrjPcb, PC1_Codec.SchDoc, PC4_DAC_Cutoff.SchDoc, PF10_Expander.SchDoc, PF1_Alim.SchDoc, PF2_AudioInput.SchDoc, PF4_DSPBypass.SchDoc, PF5a_Filter1A.SchDoc]
2018-03-20 Remove unwanted comp
    [PX_PMIC.SchDoc]
2018-03-20 Update PMIC
    [PX_PMIC.SchDoc]
2018-03-20 Add Alim Chart
    [PC4_DAC_Cutoff.SchDoc, PF3_MS.SchDoc, PF5a_Filter1A.SchDoc, PF5b_Filter2A.SchDoc, PF6_FilterMode.SchDoc, PF7_FilterRoutingBypass.SchDoc, PF9_MIDI.SchDoc, PX_PMIC.SchDoc]
2018-03-20 Update -5V
    [PC4_DAC_Cutoff.SchDoc]
2018-03-20 add VREF_DDR, VREFP et VREFN
    [PP2_ptB.SchDoc, PP3_ptC_Alim.SchDoc]
2018-03-20 Fix -5V chart
2018-03-20 corr commit en carton
    [PP2_ptB.SchDoc, PP3_ptC_Alim.SchDoc]
2018-03-20 Add 0Ohm on Cutoff
    [P0_Main_Connect.SchDoc]
2018-03-20 Set BOOT state
    [PP6_LCD.SchDoc]
2018-03-20 Avancée sur intégration Olimex
    [Michel.SchLib, P0_Main_Connect.SchDoc, PP1_ptA_SRAM-NAND.SchDoc]
2018-03-21 Add BOM with datasheet links and ALL the capacitance and inductance sources
    [Bill of Materials-Michel.csv, Michel.PrjPcb, P0_Main_Connect.SchDoc, PC1_Codec.SchDoc, PC2_Input.SchDoc, PC3_Output.SchDoc, PC4_DAC_Cutoff.SchDoc, PF10_Expander.SchDoc]
2018-03-21 Restore PP9
    [Michel.PrjPcb, P0_Main_Connect.SchDoc, PC1_Codec.SchDoc, PC2_Input.SchDoc, PC3_Output.SchDoc, PP9_OlimexProto.SchDoc]
2018-03-21 Update PP9 with JTAG
    [P0_Main_Connect.SchDoc, PC4_DAC_Cutoff.SchDoc, PF10_Expander.SchDoc, PF1_Alim.SchDoc, PF2_AudioInput.SchDoc, PF3_MS.SchDoc, PF4_DSPBypass.SchDoc, PF5a_Filter1A.SchDoc]
2018-03-21 Update PP9 with flash
    [PP1_ptA_SRAM-NAND.SchDoc, PP9_OlimexProto.SchDoc]
2018-03-21 Update Reset Push Buttons
    [PP1_ptA_SRAM-NAND.SchDoc, PX_PMIC.SchDoc]
2018-03-21 Fix CPU-REF Net Label
    [PP1_ptA_SRAM-NAND.SchDoc]
2018-03-21 Update All Net Labels
    [PP1_ptA_SRAM-NAND.SchDoc, PP2_ptB.SchDoc, PP6_LCD.SchDoc, PP9_OlimexProto.SchDoc]
2018-03-21 Update Pinmux
    [Michel.SchLib, P0_Main_Connect.SchDoc, PP1_ptA_SRAM-NAND.SchDoc, PP2_ptB.SchDoc]
2018-03-21 Commit vide
    [PP1_ptA_SRAM-NAND.SchDoc, PP2_ptB.SchDoc, PP9_OlimexProto.SchDoc]
2018-03-21 Update PP9
    [Michel.PrjPcb, PP2_ptB.SchDoc, PP9_OlimexProto.SchDoc]
2018-03-21 Restore right use of bus BOOT_PSP
    [PP2_ptB.SchDoc]
2018-03-21 Net Labels dont work throught different sheets
    [Michel.PrjPcb, P0_Main_Connect.SchDoc, PP1_ptA_SRAM-NAND.SchDoc, PP2_ptB.SchDoc, PP9_OlimexProto.SchDoc]
2018-03-21 source component, add UART connecteur and 9VAC, capa 470uF ; 6N138 -> 6N139
    [PC1_Codec.SchDoc, PF1_Alim.SchDoc, PF9_MIDI.SchDoc, PP2_ptB.SchDoc]
2018-03-21 add BUS PSP_BOOT as LCD sheet
    [PP6_LCD.SchDoc]
2018-03-21 Boot implementation like BBB model.. for a world without any repetition
    [PP6_LCD.SchDoc]
2018-03-21 BOM has xlsx format
    [Bill of Materials-Michel.xlsx]
2018-03-21 Ok Intégration Olimex, voir SPI & USB
    [Michel.SchLib, P0_Main_Connect.SchDoc, PP2_ptB.SchDoc]
2018-03-21 Add RST_ATMega
    [Michel.SchLib, P0_Main_Connect.SchDoc, PP2_ptB.SchDoc]
2018-03-22 fixe Oscilateur ppm ; cc @jaustry
    [PP1_ptA_SRAM-NAND.SchDoc]
2018-03-22 add monochrome (for art) schematics and BOM
2018-03-22 level shifter on MIDI, plein de fix, manque buck up LCD et quartz
    [Bill of Materials-Michel.xlsx, Michel.PrjPcb, P0_Main_Connect.SchDoc, PC1_Codec.SchDoc, PC2_Input.SchDoc, PC3_Output.SchDoc, PC4_DAC_Cutoff.SchDoc, PF10_Expander.SchDoc]
2018-03-22 Restore OSC{1,2}
    [PP1_ptA_SRAM-NAND.SchDoc]
2018-03-23 Remplacement BOOT_PSP par les NetLabel LCD
    [P0_Main_Connect.SchDoc, PP2_ptB.SchDoc, PP6_LCD.SchDoc]
2018-03-23 Update Buffer SN74 from lib
    [PP1_ptA_SRAM-NAND.SchDoc, PP2_ptB.SchDoc]
2018-03-23 Restore Olimex Landing-Headers' names
    [P0_Main_Connect.SchDoc, PP1_ptA_SRAM-NAND.SchDoc]
2018-03-23 jaustry est le maillon faible du groupe.
    [P0_Main_Connect.SchDoc, PP3_ptC_Alim.SchDoc]
2018-03-23 Remove Cutoff Bus in P0
    [P0_Main_Connect.SchDoc]
2018-03-23 Dernier fix de la mort
    [Michel.PrjPcb, Michel.SchLib, P0_Main_Connect.SchDoc, PC1_Codec.SchDoc, PC2_Input.SchDoc, PC3_Output.SchDoc, PC4_DAC_Cutoff.SchDoc, PF10_Expander.SchDoc]
2018-03-23 Add NO ERC to Olimex unconnected pins
    [P0_Main_Connect.SchDoc]
2018-03-23 SPI0 everything ready for Spectre
    [P0_Main_Connect.SchDoc, PP2_ptB.SchDoc]
2018-03-23 Add Landing Sheet Symbol for Spectre's part
    [P0_Main_Connect.SchDoc]
2018-03-23 Update Olimex Header Pins
    [Michel.SchLib, P0_Main_Connect.SchDoc]
2018-03-23 Insert Sheet Controle_ADC-LED
    [Michel.PrjPcb, P0_Main_Connect.SchDoc, PP2_ptB.SchDoc, PS_Controle_ADC-LED.SchDoc]
2018-03-23 Enlèvement de fichiers et dossiers inutiles
    [Michel.SchLib, P0_MASTER.SchDoc]
2018-03-23 beautification sheet
    [PP3_ptC_Alim.SchDoc]
2018-03-23 re-add protel PCB library footprint
    [Michel.PcbLib, Michel.PrjPcb]
2018-03-23 remove buck up from LCD ; place a DNI resistence ; thanks @NowakAydm
    [PP6_LCD.SchDoc]
2018-03-23 re-configure output job
    [Michel.PrjPcb]
2018-03-23 Update PS, Need ATMega + Update SchLib & MIDI
    [Michel.PrjPcb, Michel.SchLib, PC1_Codec.SchDoc, PF9_MIDI.SchDoc, PS_Controle_ADC-LED.SchDoc]
2018-03-24 add footprint without mechanical 15's level
    [Michel.PcbLib]
2018-03-24 update PX capacitances
    [PX_PMIC.SchDoc]
2018-03-24 Add resistance sources
    [Michel.PrjPcb, P0_Main_Connect.SchDoc, PC1_Codec.SchDoc, PC2_Input.SchDoc, PC3_Output.SchDoc, PC4_DAC_Cutoff.SchDoc, PF10_Expander.SchDoc, PF1_Alim.SchDoc]
2018-03-24 sync footprint with schematic
    [Michel.PcbLib, Michel.SchLib, PC1_Codec.SchDoc, PC2_Input.SchDoc, PC3_Output.SchDoc, PC4_DAC_Cutoff.SchDoc, PF10_Expander.SchDoc, PF1_Alim.SchDoc]
2018-03-24 sync footprint with library schematic
    [Michel.SchLib]
2018-03-24 Update PS, All Ok need SPI0 to Proc
    [Michel.SchLib, PP3_ptC_Alim.SchDoc, PS_Controle_ADC-LED.SchDoc]
2018-03-24 Update PS with I2C0
    [Michel.SchLib, P0_Main_Connect.SchDoc, PP2_ptB.SchDoc, PS_Controle_ADC-LED.SchDoc]
2018-03-24 Update Ref Component Olimex & PS
    [Michel.SchLib, P0_Main_Connect.SchDoc, PS_Controle_ADC-LED.SchDoc]
2018-03-24 Update PS Resonator
    [PS_Controle_ADC-LED.SchDoc]
2018-03-24 condensators as 0603 [1608 Metric] except for PP{1..4} pt{A..D} who is the next step
    [PC1_Codec.SchDoc, PC2_Input.SchDoc, PC3_Output.SchDoc, PC4_DAC_Cutoff.SchDoc, PF10_Expander.SchDoc, PF1_Alim.SchDoc, PF2_AudioInput.SchDoc, PF3_MS.SchDoc]
2018-03-24 Add 32A footprint
    [Michel.PcbLib, PS_Controle_ADC-LED.SchDoc]
2018-03-24 Update PS with SPI0
    [P0_Main_Connect.SchDoc, PS_Controle_ADC-LED.SchDoc]
2018-03-24 condensators from PP{1..4}_pt{A..D} as 0402 [1005 Metric]
    [PC1_Codec.SchDoc, PP1_ptA_SRAM-NAND.SchDoc, PP2_ptB.SchDoc, PP3_ptC_Alim.SchDoc]
2018-03-24 neopixel pwm
    [PS_Controle_ADC-LED.SchDoc]
2018-03-24 Update PP2 PtB with SPI0
    [Michel.SchLib, PC1_Codec.SchDoc, PP2_ptB.SchDoc, PS_Controle_ADC-LED.SchDoc]
2018-03-24 fixe condensator informations
    [PP1_ptA_SRAM-NAND.SchDoc]
2018-03-24 sync OutputJobFile
    hey @jb255 / jaustry , here you will found your list of footprint
    [Bill of Materials-Michel.xlsx]
2018-03-25 Il faut les pédales sur la Sheet PS
    [PS_Controle_ADC-LED.SchDoc]
2018-03-25 Add Pull-ups sur les interrupteurs sinon ça marche pô
    [PS_Controle_ADC-LED.SchDoc]
2018-03-25 Add Pull-ups Encoders PS
    [PS_Controle_ADC-LED.SchDoc]
2018-03-25 Update Reference Olimex-protoboard P0
    [P0_Main_Connect.SchDoc]
2018-03-25 Annotate Schematics
    [Michel.PrjPcb, P0_Main_Connect.SchDoc, PC1_Codec.SchDoc, PC2_Input.SchDoc, PC3_Output.SchDoc, PC4_DAC_Cutoff.SchDoc, PF10_Expander.SchDoc, PF1_Alim.SchDoc]
2018-03-25 Add NO ERC on unconnected pins
    [PF10_Expander.SchDoc, PF5a_Filter1A.SchDoc, PF5b_Filter2A.SchDoc, PF5c_Filter1B.SchDoc, PF5d_Filter2B.SchDoc, PF6_FilterMode.SchDoc, PF9_MIDI.SchDoc, PP2_ptB.SchDoc]
2018-03-25 Add Point de Test pin A3
    [Michel.PcbLib, Michel.SchLib, PP3_ptC_Alim.SchDoc]
2018-03-25 creation conectik alim et double jak
    [Michel.PcbLib, PF1_Alim.SchDoc, PF2_AudioInput.SchDoc, PF8_AudioOutput.SchDoc]
2018-03-25 footprint conectik alim + double jak
    [Michel.PcbLib, PF1_Alim.SchDoc, PF2_AudioInput.SchDoc, PF8_AudioOutput.SchDoc]
2018-03-26 Update USB1 to USB0 and BOOT_UART from UART5 to UART0
    [Michel.SchLib, P0_Main_Connect.SchDoc, PP1_ptA_SRAM-NAND.SchDoc, PP2_ptB.SchDoc, PP7_USB.SchDoc]
2018-03-26 Update P0 DSP_Bypass & RST_ATMega
    [P0_Main_Connect.SchDoc]
2018-03-26 Unconnect I2C0 & I2C2
    [P0_Main_Connect.SchDoc]
2018-03-26 fixe VINLDO with SYS netlabel and fixe oscilator => qwartz with new capa ; cc @limaconoob
    [PP1_ptA_SRAM-NAND.SchDoc, PX_PMIC.SchDoc]
2018-03-26 Update Codec, Remove PullUps on RST and MODE
    [Michel.SchLib, PC1_Codec.SchDoc]
2018-03-26 PS Fix Résistances séries & ajout des capa de découplages encodeurs
    [PS_Controle_ADC-LED.SchDoc]
2018-03-26 ultimate fixe of the LED ; more detail as https://mvfti.deviantart.com/art/Troll-Energy-Drink-310317253
    [PX_PMIC.SchDoc]
2018-03-26 Ajout des pédales Sheet PS
    [PC1_Codec.SchDoc, PS_Controle_ADC-LED.SchDoc]
2018-03-26 Update NetLabels ADC to POT (Potard)
    [PS_Controle_ADC-LED.SchDoc]
2018-03-26 Replace JTAG connector as CMS
    [Michel.SchLib, PP1_ptA_SRAM-NAND.SchDoc]
2018-03-26 Update PMIC_SYS
    [P0_Main_Connect.SchDoc, PC4_DAC_Cutoff.SchDoc, PX_PMIC.SchDoc]
2018-03-26 nb_LEDS 64 -> 48
    [PS_Controle_ADC-LED.SchDoc]
2018-03-26 Update MIDI HexInverter to Buffer, Add No ERC Buffer PP2
    [PF9_MIDI.SchDoc, PP2_ptB.SchDoc]
2018-03-26 fixe capa 22->10uF for VIN_DCDC{1,2,3} ; fixe JTAG 5 contacts/1line -> 6 contacts/2lines
    [Michel.SchLib, PP1_ptA_SRAM-NAND.SchDoc, PX_PMIC.SchDoc]
2018-03-26 Update SPI0_CS2 to SPI1_CS1 (ATMega)
    [P0_Main_Connect.SchDoc, PF9_MIDI.SchDoc, PP2_ptB.SchDoc, PS_Controle_ADC-LED.SchDoc]
2018-03-26 NetLabel PMIC_SYS
    [PX_PMIC.SchDoc]
2018-03-26 Update P0
    [P0_Main_Connect.SchDoc]
2018-03-26 PMIC VIO fixe
    [PX_PMIC.SchDoc]
2018-03-26 10uF capa decouplage NAND
    [PP1_ptA_SRAM-NAND.SchDoc, PP2_ptB.SchDoc]
2018-03-26 R217 240r -> 240
    [PP1_ptA_SRAM-NAND.SchDoc]
2018-03-26 C141 33pF -> 1uF
    [PP1_ptA_SRAM-NAND.SchDoc]
2018-03-26 PMIC VDDA_ADC Add condo
    [PP3_ptC_Alim.SchDoc]
2018-03-26 VDDS_RTC connecté à 1.8V VLDO1
    [PP3_ptC_Alim.SchDoc]
2018-03-26 Update MMC2 to MMC0
    [PP1_ptA_SRAM-NAND.SchDoc]
2018-03-26 Update Res condo filtre
    [PF2_AudioInput.SchDoc, PF3_MS.SchDoc, PF5a_Filter1A.SchDoc, PF5b_Filter2A.SchDoc, PF5c_Filter1B.SchDoc, PF5d_Filter2B.SchDoc, PF8_AudioOutput.SchDoc]
2018-03-26 Update PC1 condo decouplage
    [PC1_Codec.SchDoc]
2018-03-26 Update PC4 decouplage U49
    [PC4_DAC_Cutoff.SchDoc]
2018-03-26 Add UART ATMega, Update condo decouplage PS
    [P0_Main_Connect.SchDoc, PP2_ptB.SchDoc, PS_Controle_ADC-LED.SchDoc]
2018-03-26 Update Ref Potard (PS) & Move GND from PC1 to PF1
    [PC1_Codec.SchDoc, PF1_Alim.SchDoc, PS_Controle_ADC-LED.SchDoc]
2018-03-26 remove binary text, replace UART with unshrouded connector, fixe pattern of point test
    [Michel.SchLib]
2018-03-26 reoganize hardware branch, move pinmux branch into folder from hardware branch
    [Bonjour.PrjPcb, Bonjour.SchLib, DDR3.SchDoc, Filter.PcbLib, Filter.SchLib, Filter_PCB_Project.PrjPcb, LCD.SchDoc, Michel_PcbLib.PcbLib]
2018-03-26 sync primary outputJob files
    [Bill of Materials-Michel.xlsx]
2018-03-27 Update Olimex + Rename UART
    [P0_Main_Connect.SchDoc, PP2_ptB.SchDoc, PS_Controle_ADC-LED.SchDoc]
2018-03-27 Annotate Schematics + Update UART ATMega
    [P0_Main_Connect.SchDoc, PA_Alim.SchDoc, PC1_Codec.SchDoc, PC2_Input.SchDoc, PC3_Output.SchDoc, PC4_DAC_Cutoff.SchDoc, PF10_Expander.SchDoc, PF2_AudioInput.SchDoc]
2018-03-27 Ajout des Résistances 0 Ohm autour du Processeur
    [P0_Main_Connect.SchDoc, PP2_ptB.SchDoc]
2018-03-27 Update MAX7219 RefFabricant
    [Michel.SchLib, PS_Controle_ADC-LED.SchDoc]
2018-03-27 Added Cutoff Digipot and Neopixel (reannotation)
    [Michel.PrjPcb, Michel.SchLib, P0_Main_Connect.SchDoc, PA_Alim.SchDoc, PC1_Codec.SchDoc, PC2_Input.SchDoc, PC3_Output.SchDoc, PC4_DAC_Cutoff.SchDoc]
2018-03-28 change the led from PMIC, add footprint for capa, PMIC led and resistance (with IPC name standard), link all the footprint to the schematic sheet, sync outputJobFile and add/sync the 3D
    [21-0042B_24-L.step, 21-0042B_24-M.step, 21-0042B_24.step, 21-0061L-L.step, 21-0061L-M.step, 21-0061L.step, 32A-L.step, 32A-M.step]
2018-03-28 Added Power switch, updated Jack ref
    [PA_Alim.SchDoc, PF2_AudioInput.SchDoc, PF8_AudioOutput.SchDoc, PS_Controle_ADC-LED.SchDoc]
2018-03-29 Changed LED ref, added 3way connecter to pots and neopixel
    [PS_Controle_ADC-LED.SchDoc]
2018-03-29 Changed 3way connector refs
    [PS_Controle_ADC-LED.SchDoc]
2018-03-29 add new 3D's asset
    [DBV6-L.step, DBV6-M.step, DBV6.step, LED_LNJ.step, SOD323-L.step, SOD323-M.step, SOD323.step]
2018-03-29 fixe LED, add footprint, propagate resistance footprint
    [Michel.SchLib, P0_Main_Connect.SchDoc, PA_Alim.SchDoc, PC1_Codec.SchDoc, PC2_Input.SchDoc, PC3_Output.SchDoc, PC4_DAC_Cutoff.SchDoc, PF10_Expander.SchDoc]
2018-04-01 sync STL
    [CONN_1241050-2_TYCO-L.step, CONN_1241050-2_TYCO-M.step, CONN_1241050-2_TYCO.step, CONN_1241050-3_TYCO-L.step, CONN_1241050-3_TYCO-M.step, CONN_1241050-3_TYCO.step, CONN_1241150-3_TYCO-L.step, CONN_1241150-3_TYCO-M.step]
2018-04-01 sync outputjob primitive, add footprint except 6 last components, fixe wrong name from SRAM/footprint, add last datasheet links, set led as blue color, fixe every connector as CMS, fixe 8 MHz's Reson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
    [Bill of Materials-Michel.xlsx, Michel.SchLib, PA_Alim.SchDoc, PF2_AudioInput.SchDoc, PF3_MS.SchDoc, PF7_FilterRoutingBypass.SchDoc, PF8_AudioOutput.SchDoc, PF9_MIDI.SchDoc]
2018-04-02 add final components and set deceitful footprints
    [Bill of Materials-Michel.xlsx, Michel.PrjPcb, Michel.SchLib, PA_Alim.SchDoc, PC1_Codec.SchDoc, PC2_Input.SchDoc, PC3_Output.SchDoc, PC4_DAC_Cutoff.SchDoc]
2018-04-02 add new NAND option and fixe button footprint and re-add very complex double GND footprint
    [Bill of Materials-Michel.xlsx, Michel.SchLib, PA_Alim.SchDoc, PP1_ptA_SRAM-NAND.SchDoc, PP3_ptC_Alim.SchDoc, PP4_pD_GND.SchDoc]
2018-04-02 fixe NAND alim and add footprint EVM Olimex
    [P0_Main_Connect.SchDoc, PP1_ptA_SRAM-NAND.SchDoc]
2018-04-02 Updated MIDI optocoupler for CMS one
    [PF9_MIDI.SchDoc]
2018-04-02 Init PCB_Méca + Update round pads
    [Michel.PrjPcb]
2018-04-03 Update some footprints (Green Highlights)
    [Remarques footprints.xls]
2018-04-03 Update footprints
    [Remarques footprints.xls]
2018-04-04 Update footprints + Update MMC pads
    [Michel.SchLib, PP8_MMC.SchDoc, Remarques footprints.xls]
2018-04-04 Update -M footprints + schematics ; Need wrong references
    [Michel.SchLib, PA_Alim.SchDoc, PC1_Codec.SchDoc, PC2_Input.SchDoc, PC3_Output.SchDoc, PC4_DAC_Cutoff.SchDoc, PF11_DigiPot_Cutoff.SchDoc, PF2_AudioInput.SchDoc]
2018-04-05 Ok Push Button
    [Michel.SchLib, PX_PMIC.SchDoc]
2018-04-05 Reannotation, some footprints corrected
    [Michel.PrjPcb, Michel.SchLib, P0_Main_Connect.SchDoc, PA_Alim.SchDoc, PC1_Codec.SchDoc, PC2_Input.SchDoc, PC3_Output.SchDoc, PC4_DAC_Cutoff.SchDoc]
2018-04-05 enlevvation 0homs
    [PP2_ptB.SchDoc]
2018-04-05 enlevation 0homs
    [P0_Main_Connect.SchDoc]
2018-04-05 ajout stackup 8 couche a la pcb base meca
    [Michel.PrjPcb, PCB1.PcbDoc, PCB_Base_M+¬ca.PcbDoc]
2018-04-05 Reupload anowak PCBlib
2018-04-06 Ok FP Voir 4 derniers avec anowak
    [Michel.PcbLib, Michel.SchLib, PF10_Expander.SchDoc, PS_Controle_ADC-LED.SchDoc, Remarques footprints.xls]
2018-04-06 Update Solder Masks
    [Michel.PcbLib]
2018-04-06 re-add TL084/9593462) and 74LVC1G3157/2463921 data as schematics and MichelLibSchematic,
    [Michel.PcbLib, Michel.SchLib, PC4_DAC_Cutoff.SchDoc, PF3_MS.SchDoc, PF4_DSPBypass.SchDoc, PF5a_Filter1A.SchDoc, PF5b_Filter2A.SchDoc, PF5c_Filter1B.SchDoc]
2018-04-06 sync Output File ; reannote schematic, sync datasheet, fixe 1201328 permutation
    [Bill of Materials-Michel.xlsx, Michel.PrjPcb, P0_Main_Connect.SchDoc, PA_Alim.SchDoc, PC1_Codec.SchDoc, PC2_Input.SchDoc, PC3_Output.SchDoc, PC4_DAC_Cutoff.SchDoc]
2018-04-06 Update détrompeurs FP
    [Michel.PcbLib, Michel.PrjPcb, Michel.SchLib, PP6_LCD.SchDoc]
2018-04-06 Update Sérigraphie
    [Michel.PcbLib]
2018-04-06 Check Size FP
    [Michel.PcbLib, Michel.SchLib, PS_Controle_ADC-LED.SchDoc, Remarques footprints.xls]
2018-04-06 Ok Capacitors FP
    [Michel.PcbLib, Remarques footprints.xls]
2018-04-07 Ok Empreintes de pied des Headers et du Jack d'alim
    [Michel.PcbLib, PA_Alim.SchDoc, Remarques footprints.xls]
2018-04-07 Ok Empreintes de pied des Résistances
    [Michel.PcbLib, Remarques footprints.xls]
2018-04-07 mmodif cap pour passer entre les pate du proc
    [Michel.PcbLib]
2018-04-07 add footprint condo 0805 (2012 metric)
    [Michel.PcbLib]
2018-04-07 Remove jaustry commit + Check D_ SOIC FP
    [Michel.PcbLib]
2018-04-07 Update tab
    [Remarques footprints.xls]
2018-04-07 add two components (LCD & octocoupleur)
    [Michel.PcbLib, Michel.SchLib, PF9_MIDI.SchDoc, PP6_LCD.SchDoc]
2018-04-07 source ESD
    [Michel.SchLib, PP7_USB.SchDoc]
2018-04-07 modif des packtage des condo
    [PP3_ptC_Alim.SchDoc]
2018-04-07 fixe LCD component
    [Michel.SchLib, PP6_LCD.SchDoc]
2018-04-07 fixe 74HC4052D, link valid footprint
    [PF6_FilterMode.SchDoc]
2018-04-07 Check FP
    [Michel.PcbLib, Remarques footprints.xls]
2018-04-07 Check FP almost done
    [Michel.PcbLib, Remarques footprints.xls]
2018-04-08 OK Check FP (limaconoob)
    [Michel.PcbLib, Remarques footprints.xls]
2018-04-08 Rename UTF8 PCB_Base_Méca
    [Michel.PrjPcb, PCB_Base_M+¬ca.PcbDoc, PCB_Base_Méca.PcbDoc]
2018-04-08 OK Import changes on PCB_Méca
    [Michel.PcbLib, Michel.PrjPcb, Michel.SchLib, P0_Main_Connect.SchDoc, PC1_Codec.SchDoc, PF11_DigiPot_Cutoff.SchDoc, PS_Controle_ADC-LED.SchDoc]
2018-04-08 Expansion des FP
2018-04-08 sourcing condo 1uf
    [PP3_ptC_Alim.SchDoc]
2018-04-08 modif taille boitier
    [Michel.PrjPcb, PA_Alim.SchDoc, PC1_Codec.SchDoc, PP2_ptB.SchDoc, PP3_ptC_Alim.SchDoc]
2018-04-08 fixe component SOIC16_MCP3008 ; cc @limacoNOOB
    [Michel.PcbLib]
2018-04-08 first fixe of SPI1_CS0_Codec line
    [P0_Main_Connect.SchDoc]
2018-04-08 Fixe USB true-hole
    [Michel.PcbLib, Michel.SchLib, PP7_USB.SchDoc]
2018-04-09 PCB_Méca Add LEDs & Update sérigraphie connecteurs
    [Michel.PcbLib]
2018-04-09 update OutpuJobs
    [Bill of Materials-Michel.xlsx]
2018-04-09 footprints correct (solder masks), ref connecteur 2x3 2x4 changed for cheaper
    [Michel.PcbLib, Michel.SchLib, PP1_ptA_SRAM-NAND.SchDoc, PP2_ptB.SchDoc]
2018-04-09 Update FP VR1-2 & U55, Remove FP MMC
    [Michel.PcbLib]
2018-04-09 modif ferite
    [PP3_ptC_Alim.SchDoc]
2018-04-09 Add two components
    [Michel.PcbLib]
2018-04-09 source two components
    [Michel.SchLib]
2018-04-09 modif taille serigraphie
    [Michel.PcbLib]
2018-04-09 nand sd
    [Michel.SchLib, PP1_ptA_SRAM-NAND.SchDoc, PP8_MMC.SchDoc]
2018-04-10 Fix MMC + Import on PCB
    [Michel.PcbLib, Michel.PrjPcb, PP1_ptA_SRAM-NAND.SchDoc, PP8_MMC.SchDoc]
2018-04-10 Fix NAND FP
    [Michel.PcbLib]
2018-04-10 Remove old flash/Nand component
    [Michel.PcbLib, Michel.SchLib]
2018-04-10 jpepin nike tout le monde au lance rocket
    [Michel.PrjPcb, PP1_ptA_SRAM-NAND.SchDoc, PP2_ptB.SchDoc, PP3_ptC_Alim.SchDoc, PP4_pD_GND.SchDoc]
2018-04-10 Update designators
    [P0_Main_Connect.SchDoc]
2018-04-10 Update Condo FP + Update Font size on PCB
    [Michel.PcbLib, PP1_ptA_SRAM-NAND.SchDoc, PP2_ptB.SchDoc, PP3_ptC_Alim.SchDoc]
2018-04-11 Clear Analog part + Clear P0 + Add PX2_Header
    [Michel.PrjPcb, P0_Main_Connect.SchDoc, PA1_Alim.SchDoc, PA2_PMIC.SchDoc, PA_Alim.SchDoc, PC4_DAC_Cutoff.SchDoc, PF10_Expander.SchDoc, PF11_DigiPot_Cutoff.SchDoc]
2018-04-11 Update P0 & PX2
    [Michel.PrjPcb, P0_Main_Connect.SchDoc, PX2_Header.SchDoc]
2018-04-11 Fix NAND + Add Header_21 SchLib
    [Michel.SchLib, P0_Main_Connect.SchDoc, PA1_Alim.SchDoc, PP1_ptA_SRAM-NAND.SchDoc, PX2_Header.SchDoc]
2018-04-11 Update Ref Header + Add FP
    [Michel.PcbLib, Michel.SchLib, P0_Main_Connect.SchDoc, PX2_Header.SchDoc]
2018-04-11 Update PX2
    [Michel.SchLib, PX2_Header.SchDoc]
2018-04-11 Annotate + Import on PCB + Fix Heatsinks PMIC & Codec
    [Michel.PcbLib, Michel.PrjPcb, Michel.SchLib, P0_Main_Connect.SchDoc, PA1_Alim.SchDoc, PA2_PMIC.SchDoc, PC1_Codec.SchDoc, PC2_Input.SchDoc]
2018-04-11 Valid Design Rule Check
    [Michel.PcbLib, Michel.PrjPcb]
2018-04-11 Draw LCD
    [Michel.PrjPcb]
2018-04-11 Updated PCB meca, new 8x2 header for megazorb, is meca OK ?
    [Michel.PcbLib, Michel.PrjPcb, P0_Main_Connect.SchDoc, PA1_Alim.SchDoc, PA2_PMIC.SchDoc, PC1_Codec.SchDoc, PC2_Input.SchDoc, PC3_Output.SchDoc]
2018-04-11 Changed LED refs for more colors
    [PX1_Controle_ADC-LED.SchDoc]
2018-04-11 Update Text height and width + Add components config/parameters file
    [P0_Main_Connect.SchDoc]
2018-04-12 !! CLEAN PCB MECA !!
    Ce commit a une version de la PCB qui contient uniquement tous les éléments mécaniques (dont la place ne peux pas être modifiée pour le routage).
    Il faut partir de cette version pour pouvoir placer/router les composants.
    Pensez à importer les fichiers "config.dft" & "Components.dft" dans les préférences et les Rules
    [Michel.PcbLib, Michel.PrjPcb]
2018-04-12 Place Alim + Lock Méca Components
    [PA1_Alim.SchDoc]
2018-04-12 Update Alim + Place PMIC with Heatsinks
2018-04-13 Clear PX1 (Controllers LED/ADC) + Update P0 & PX (PX2)
    [Michel.PrjPcb, P0_Main_Connect.SchDoc, PX1_Controle_ADC-LED.SchDoc, PX2_Header.SchDoc, PX_Header.SchDoc]
2018-04-13 !! CLEAN PCB MECA (MINI) !!
    Add FP Header 14 Pins Controllers ADC/LED
    Update FP Header 16 Pins Audio
    Remove MIDI THRU
    Reduce PCB size (without LEDs and Encoders)
    Reannotate Schematics
    Import from Schematics
    PLACE MECA COMPONENTS
    Place Alim + HighSpeed
    [Michel.PcbLib, P0_Main_Connect.SchDoc, PA1_Alim.SchDoc, PA2_PMIC.SchDoc, PC1_Codec.SchDoc, PC2_Input.SchDoc, PC3_Output.SchDoc, PP1_ptA_SRAM-NAND.SchDoc]
2018-04-13 Solution 2 : Remove Headers and go 2 Double Jacks IN/OUT
    [Michel.PrjPcb, P0_Main_Connect.SchDoc, PA1_Alim.SchDoc, PA2_PMIC.SchDoc, PC1_Codec.SchDoc, PC2_Input.SchDoc, PC3_Output.SchDoc, PC4_AudioInput.SchDoc]
2018-04-13 Added headers, AC coupling on Codec output, reannotation
    [Michel.PrjPcb, P0_Main_Connect.SchDoc, PA1_Alim.SchDoc, PA2_PMIC.SchDoc, PC1_Codec.SchDoc, PC2_Input.SchDoc, PC3_Output.SchDoc, PC4_AudioInput.SchDoc]
2018-04-13 Placement des headers + Organisation des FP par Sheet
    [P0_Main_Connect.SchDoc]
2018-04-14 Work on New Codec TLV320
    [Michel.SchLib, PC1_Codec.SchDoc]
2018-04-15 Restore Codec PCM3168
    [Michel.SchLib, PC1_Codec.SchDoc]
2018-04-15 Update FP PMIC + Add HeatSink Vias + Add Vias under Proc
    [Michel.PcbLib]
2018-04-15 Update FP Capa (0402) Pas de sérigraphie ; cc @adjivas
    [Michel.PcbLib]
2018-04-15 Update FP Capa (0402) NEED CHECK !! + 1st try Proc Decoupling
    [Michel.PcbLib]
2018-04-15 Orga components by Sheet
    [P0_Main_Connect.SchDoc]
2018-04-15 chaqu'un sa pcb a son login il parrait ?
    [jaustry.PcbDoc]
2018-04-16 Update Matrice Proc Vias + Separate PCB Meca/jaustry/limaconoob
    [Michel.PrjPcb, PCB_jaustry.PcbDoc, jaustry.PcbDoc]
2018-04-16 Clean PCB Base Meca
2018-04-16 Update Codec on MCASP0 only
    [Michel.SchLib, PCB_jaustry.PcbDoc, PP2_ptB.SchDoc]
2018-04-16 Changed Codec, reannotation
    [Michel.PrjPcb, Michel.SchLib, P0_Main_Connect.SchDoc, PA1_Alim.SchDoc, PA2_PMIC.SchDoc, PC0_Codec.SchDoc, PC1_Codec.SchDoc, PC2_Input.SchDoc]
2018-04-16 corrected Codec Opamp decoupling ...
    [PC0_Codec.SchDoc]
2018-04-17 next draw tomorrow at 7PM
    [Michel.PrjPcb]
2018-04-18 Add Codec FP + Update on all PCB
    [Michel.PcbLib, P0_Main_Connect.SchDoc, PC0_Codec.SchDoc, PCB_jaustry.PcbDoc, PP2_ptB.SchDoc, PP4_pD_GND.SchDoc]
2018-04-18 Add 4 Corner Drill Holes (3mm Diamètre)
    [PCB_jaustry.PcbDoc]
2018-04-18 Update Corner Holes
    [PCB_jaustry.PcbDoc]
2018-04-18 Update Double Jack FP + Add Keepout Layer
    [Michel.PcbLib, PCB_jaustry.PcbDoc]
2018-04-18 Fix Regulators + Update on all PCB
    [PA1_Alim.SchDoc, PCB_jaustry.PcbDoc]
2018-04-18 REALLY added condencsers ...
    [PC0_Codec.SchDoc]
2018-04-18 Update Alim + Update Heatsinks
2018-04-18 Corrected inverted opamps
    [PC4_AudioInput.SchDoc, PC5_AudioOutput.SchDoc]
2018-04-19 pre USB
    [PCB_adjivas.PcbDoc]
2018-04-20 Add MIDI + Work on Power Planes
2018-04-20 travail dans le train
    [PCB_jaustry.PcbDoc]
2018-04-21 Route LCD
    [PP6_LCD.SchDoc]
2018-04-21 Work on Audio IN
    [PP7_USB.SchDoc]
2018-04-21 re up travail train
    [Michel.PrjPcb, PCB_jaustry.PcbDoc, PCB_jaustry2.PcbDoc]
2018-04-21 fixe Netlabel bonjour to USB, USB wait pair step, prepare SD
    [PP7_USB.SchDoc]
2018-04-22 Work on Audio IN ; Need Sérigraphie
    [Michel.PrjPcb]
2018-04-22 fixe USB class as SB
    [PP7_USB.SchDoc]
2018-04-22 presque finition alim proc
    [PCB_jaustry2.PcbDoc]
2018-04-23 SD res + USB pair
    [PP8_MMC.SchDoc]
2018-04-23 Re-up PCB_limaconoob
2018-04-23 @anowrwak's check of power direction
    [PC4_AudioInput.SchDoc]
2018-04-23 Update Board Size + Prepare Audio IN & Codec
2018-04-23 Update GND + Work on Audio IN + Add Project Title
    [Michel.PcbLib, PA1_Alim.SchDoc]
2018-04-23 finition decouplage proc
    [PCB_jaustry2.PcbDoc]
2018-04-23 add USB's pair rule
    [PP8_MMC.SchDoc]
2018-04-24 OK Découplage de jaustry
2018-04-24 add rule et pair diif ddr3
    [PP1_ptA_SRAM-NAND.SchDoc]
2018-04-24 routage SD and pre-root I2C/SPI [...]
2018-04-25 Unroute SD & SPI/I²C
2018-04-25 Fix MMC Alim + Re-Route I²C & SPI & Header P1
    [PP8_MMC.SchDoc]
2018-04-27 Work on Power Plane + Unroute PMIC
2018-04-28 NAND rootage proposition (cc @limacoNOOB) ; update component NAND from libMichel
    [Michel.SchLib, PP1_ptA_SRAM-NAND.SchDoc]
2018-04-30 Ok Alim Proc on Power Planes
2018-04-30 Push +3.3V_CORE to SD and Boot + Add +5V Power Plane
2018-04-30 Fix DDR Plane + Work on Via Holes
2018-04-30 final routage ddr3
    [PCB_jaustry3.PcbDoc]
2018-05-01 Update Track Width outside the Proc
2018-05-05 Final Routage Decoupling Processor
    [PP6_LCD.SchDoc]
2018-05-05 Update Solder Mask & Tenting
2018-05-05 NAND update
    [PP1_ptA_SRAM-NAND.SchDoc]
2018-05-06 Critical merge of last pin of LCD and PMIC lines
2018-05-06 add STEP drawed by @limaconoob
    [BarrelAlim.step, Double-Jack.step, MIDI.step, PowerSwitch.step, USB.step]
2018-05-06 Update MIDI + Add Last Proc Connections + Need NAND & DDR3
    [Michel.PcbLib, Michel.PrjPcb]
2018-05-06 update SOIC127 point and add a bit of 3D (2.5/5)
    [Michel.PcbLib]
2018-05-06 End of 3D files
    [Michel.PcbLib]
2018-05-07 fixe via solder mask who was under R116
2018-05-07 fixe solder mask via of C200
2018-05-07 Solder Mask Tending Top and Bottom fixed as Top
2018-05-07 maj feuille ram
    [Michel.PrjPcb, PP1_ptA_SRAM-NAND.SchDoc]
2018-05-07 modif resistance
2018-05-07 commit de adjivas
2018-05-07 passage de tt les ligne de ddr en 25mm
2018-05-08 Lil Update + Fix GND-AGND Connection
    [Michel.PrjPcb]
2018-05-08 protection via from Proc as top solder mask ; cc @anowak
2018-05-08 fixe 3D component footprint and set as 3D connector from PCB (Thank's @limaconoob for the primitive assets)
    [Michel.PcbLib]
2018-05-12 fixe errors from special copy
    [PP8_MMC.SchDoc]
2018-05-12 adjivas PCB to limaconoob ; sync
2018-05-14 paaaair diff 25mm
2018-05-14 MMC as higth speed class, seregraphy fixed (include via), LCD capa as 0.45mm, SD lines 33.75 for higth speed, boot text as PSP
    [PP8_MMC.SchDoc]
2018-05-14 fixe Design rule check without via error, reorganize the project into the fusion of jaustry,adjivas,liconoob to pcb
    [Bill of Materials-Michel.xlsx, Michel.PcbLib, Michel.PrjPcb, Michel.SchLib, P0_Main_Connect.SchDoc, PA1_Alim.SchDoc, PA2_PMIC.SchDoc, PC0_Codec.SchDoc]
2018-05-17 solder top ram
2018-05-17 add size pcb and table of drills
2018-05-18 Remove Ground Component (Replaced by Short-Circuit Route)
    [PA1_Alim.SchDoc]
2018-05-18 Fix C10 Value (470pf to 470uF)
    [PA1_Alim.SchDoc]
2018-05-18 Add description on Q1
    [PP1_ptA_SRAM-NAND.SchDoc]
2018-05-18 Update Description Inducteur MMC & Connecteurs LCD
    [PP6_LCD.SchDoc, PP8_MMC.SchDoc]
2018-05-18 Work on BOM
    [Bill of Materials-Michel.xls]
2018-05-18 Add Fabricant Header 2x20 LCD P7
    [PP6_LCD.SchDoc]
2018-05-18 update capacitance
    [PA1_Alim.SchDoc, PA2_PMIC.SchDoc, PC0_Codec.SchDoc, PC4_AudioInput.SchDoc, PC5_AudioOutput.SchDoc, PP1_ptA_SRAM-NAND.SchDoc, PP3_ptC_Alim.SchDoc, PP6_LCD.SchDoc]
2018-05-19 Update NAND RefFournisseur
    [Bill of Materials-Michel.xls, PP1_ptA_SRAM-NAND.SchDoc]
2018-05-19 Fix LCD Header 2x20 RefFabricant/RefFournisseur
    [Bill of Materials-Michel.xls, PP6_LCD.SchDoc]
2018-05-19 Fix all RefFournisseur on Sheet PC0_Codec
    [PC0_Codec.SchDoc]
2018-05-19 ReUp 10uF Condo
    [PC0_Codec.SchDoc]
2018-05-19 Fix PC5_AudioOutput except Res150
    [PC5_AudioOutput.SchDoc]
2018-05-19 Fix PC4_AudioInput except Res220
    [PC4_AudioInput.SchDoc]
2018-05-19 Fix PP8_MMC RefFournisseur
    [PP8_MMC.SchDoc]
2018-05-19 Work on RefFournisseur
    [PA2_PMIC.SchDoc, PC4_AudioInput.SchDoc, PP6_LCD.SchDoc, PP7_USB.SchDoc]
2018-05-19 Update BOM
    [Bill of Materials-Michel.xls]
2018-05-19 Update RefFournisseur
    [Bill of Materials-Michel.xls, Michel.PrjPcb, P0_Main_Connect.SchDoc, PA1_Alim.SchDoc, PA2_PMIC.SchDoc, PC4_AudioInput.SchDoc, PC5_AudioOutput.SchDoc, PP1_ptA_SRAM-NAND.SchDoc]
2018-05-19 maj BOM
    [PP1_ptA_SRAM-NAND.SchDoc, PP2_ptB.SchDoc, PP3_ptC_Alim.SchDoc]
2018-05-19 ref fqrnell 50 ohm
    [PP1_ptA_SRAM-NAND.SchDoc]
2018-05-19 cond + res
    [PP3_ptC_Alim.SchDoc]
2018-05-21 Add Gerber Files
    [Michel.PrjPcb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]
2018-05-21 Final Fabrication Output
    [Michel.PcbLib, Michel.PrjPcb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]
2018-05-24 maj composant farnell
    [P0_Main_Connect.SchDoc, PA2_PMIC.SchDoc, PC0_Codec.SchDoc, PC4_AudioInput.SchDoc, PC5_AudioOutput.SchDoc, PP1_ptA_SRAM-NAND.SchDoc, PP5_MIDI.SchDoc, PP6_LCD.SchDoc]
2018-05-25 Update NAND
    [PP1_ptA_SRAM-NAND.SchDoc]
2018-05-25 fixe standard BOM from DNI resistances
    [PP1_ptA_SRAM-NAND.SchDoc, PP6_LCD.SchDoc]
2018-05-26 first pass; change Out Of Stock component
    [P0_Main_Connect.SchDoc, PA2_PMIC.SchDoc, PC4_AudioInput.SchDoc, PC5_AudioOutput.SchDoc, PP1_ptA_SRAM-NAND.SchDoc, PP2_ptB.SchDoc, PP3_ptC_Alim.SchDoc, PP4_pD_GND.SchDoc]
2018-05-26 Update Fab Outputs
    [Bill of Materials-Michel.xls, Michel.PrjPcb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]
2018-05-26 Add .loc files
    [Michel.PrjPcb]
2018-05-26 BOM Order by Comments fixed
    [Bill of Materials-Michel.xls, PA2_PMIC.SchDoc, PC4_AudioInput.SchDoc, PC5_AudioOutput.SchDoc, PP6_LCD.SchDoc, PP8_MMC.SchDoc]
2018-05-26 first pass for remove duplicate fields from normal arguments
    [PA2_PMIC.SchDoc, PC0_Codec.SchDoc, PC4_AudioInput.SchDoc, PC5_AudioOutput.SchDoc, PP1_ptA_SRAM-NAND.SchDoc, PP2_ptB.SchDoc, PP3_ptC_Alim.SchDoc, PP6_LCD.SchDoc]
2018-05-27 Second pass, ultimate remove of hidden special fields from Altium. Now, the output job is coherent and not need any manual change (cc @limaconoob ).
    [P0_Main_Connect.SchDoc, PA1_Alim.SchDoc, PA2_PMIC.SchDoc, PC0_Codec.SchDoc, PC4_AudioInput.SchDoc, PC5_AudioOutput.SchDoc, PP1_ptA_SRAM-NAND.SchDoc, PP2_ptB.SchDoc]
2018-05-27 check a suspicious cap (the comment and the value not shared the same nF unit) ; pass 3, fixe the conflictual comment names to solve the output job (there was a last list fields for a undetermned rea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
    [PP2_ptB.SchDoc, PP3_ptC_Alim.SchDoc]
2018-05-27 Translast comment to value, there miss only the SRAM, that only needed to generate a right PDF. Comment is a group information, reset it was necessary to sort the list from OutputJob
    [PP1_ptA_SRAM-NAND.SchDoc, PP3_ptC_Alim.SchDoc]
2018-05-27 ultimate uncheck of comment show and check of value show
    [PA1_Alim.SchDoc, PA2_PMIC.SchDoc, PC0_Codec.SchDoc, PC4_AudioInput.SchDoc, PC5_AudioOutput.SchDoc, PP1_ptA_SRAM-NAND.SchDoc, PP5_MIDI.SchDoc]
2018-05-27 check from Olimex the last difference between comment and value
    [PA1_Alim.SchDoc, PP1_ptA_SRAM-NAND.SchDoc, PP2_ptB.SchDoc, PP3_ptC_Alim.SchDoc]
2018-05-27 last completion of empty param
    [PP1_ptA_SRAM-NAND.SchDoc, PP3_ptC_Alim.SchDoc]
2018-05-27 Fix Gerber Keep Out
    [Bill of Materials-Michel.xls, Michel.PrjPcb, Pick Place for PCB.csv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]
2018-05-27 Update BOM + Create .zip
    [Bill of Materials-Michel.xls, Michel.PrjPcb]
2018-05-29 Add Spec Files
    [Valeurs_Polar.ods, Valeurs_Réelles.ods]
2018-06-20 update BOM -- RoSH
    [P0_Main_Connect.SchDoc, PA2_PMIC.SchDoc, PC0_Codec.SchDoc, PC4_AudioInput.SchDoc, PC5_AudioOutput.SchDoc, PP1_ptA_SRAM-NAND.SchDoc, PP3_ptC_Alim.SchDoc, PP5_MIDI.SchDoc]
2018-07-07 fixe capa reference from Farnell
    [PA2_PMIC.SchDoc, PC0_Codec.SchDoc, PC4_AudioInput.SchDoc, PC5_AudioOutput.SchDoc, PP1_ptA_SRAM-NAND.SchDoc, PP7_USB.SchDoc]
